czc13611858691/hozonEp40/doc/客户反馈诊断问题2022-1-19/readme.md

微信图片_20220119090819

NAX 0x50

主节点诊断

**未请求的服务，也会自动响应其他服务**



部分服务中少加了break

F19D	2

F1BF	2

F1C0	2 	BREAK

F1D0	3

default  BREAK

**流控制帧响应格式不对**







0x3C:	50	03	22	F1	9D	00	00	00

0x3D:	50	10	06	62	F1	9D	20	21

0x3D:	50	21	12	26	00	00	00	00

**pos**

62	F1	9D	20	21	12

**实际上我们想返回的数据**

10	PCI FF 首帧

06	数据长度为6

62	RSID	SID+0x40=0x22+0x40=0x62

21	PCI CF 续帧 计数值为1

F19D	数据标识符



返回的数据为:

20 21 12 26   //2021年12月26日
