czc13611858691/hozonEp40/doc/E3软件测试.md

#### 1.功能测试

##### 1.1.通用测试

- 窗提升点动，长按功能，区分时间300ms
- 快速滑动功能，滑动后长按功能
- 背光调节功能，白天高亮度，夜晚低亮度，同时夜晚背光亮度受背光等级调节
- 触摸开关任意按键发送按键声音信息
- 自动挡位信号的发送在之前移植时手动挡

##### 1.2.特定功能测试

###### 1.2.1.主驾DFGLS

- REAR按键切换功能
- 玻璃锁止功能

###### 1.2.2.左后DRGLS

- 自定义按键

###### 1.2.3.右前PFGLS

- 自定义按键

###### 1.2.4.右后PRGLS

- 自定义按键

#### 2.LIN通信测试

- 和CANOE主节点正常通信，同时不报错误
- 波特率正确
- 设备识别的同步间隔长度为13Tbit-26Tbit
- 设备识别的界定符长度为1Tbit-14Tbit
- 帧头长度识别范围为34Tbit-47Tbit
- 从节点PID奇偶校验错误测试
- 从节点不完整帧干扰测试
- checksum错误监测
- 数据场故障监测，干扰数据场
- 从节点接收睡眠命令帧
- 总线空闲4s进入睡眠模式
- 从节点可以正常唤醒

#### 3.LIN诊断测试

**canoe上位机可以读取设备所有信息**

- 配置nad,canoe可以读取所有did功能
- **1** boot版本    F180    03.01.01  -->  30 33 2e 30 31 2e 30 31      8Byte
- 当前诊断任务模式      F186  --> 01      1Byte
- 整车零部件号     F187   -->                  13Byte
- **2** 应用软件版本号(升级版本)  F188   03.01.01  -->  30 33 2e 30 31 2e 30 31      8Byte
- 应用软件版本号(固定版本）F1B0    03.01.01  -->  30 33 2e 30 31 2e 30 31      8Byte
- ECU标定软件号     F1A2      03.01.01  -->  30 33 2e 30 31 2e 30 31      8Byte
- 系统供应商代码   F18A   -->              3Byte
- ECU生产日期   F18B  2021年12月26日 -->    20 21 12 26   4Byte
- 控制器序列号   F18C   -->                    18Byte
- **3** 整车   VINF190        -->                    17Byte
- **4** 硬件版本号   F191  H1.01-->  48 31 2E 30 31                5Byte
- 测试串口序列   F198  -->                                     10Byte
- 刷新日期    F199  2021年12月26日 -->    20 21 12 26   4Byte
- ECU专配日期   F19D  2021年12月26日 -->    20 21 12 26   4Byte
- 硬件版本    F1BF    H1.01-->  48 31 2E 30 31                5Byte
- 软件总成    F1C0    03.01.01  -->  30 33 2e 30 31 2e 30 31      8Byte
- 软件总成零件号   F1D0  -->          13Byte

规定数据以外填充0x00

小于规定长度填充0x20

#### 4.LIN刷写测试

**canoe上位机可以对设备进行上位机升级**

boot 0-0x4800   18K

app 0-end

- 设备可以成功刷写
- 刷写后重新上电，测试设备是否改变
- 刷写后所有功能都可以正常运行

0x3c

诊断默认服务切换 PCI:SF sid:0x10 DATA:1   返回帧长度:1

读取bootloader版本号  PCI:SF sid:0x22 DATA:F180   返回帧长度:2

读取app软件版本号  PCI:SF sid:0x22 DATA:F188   返回帧长度:2

读取VIN  PCI:SF sid:0x22 DATA:F190   返回帧长度:4

读取ecu硬件版本号   PCI:SF sid:0x22 DATA:F191   返回帧长度:2

诊断扩展服务切换 PCI:SF sid:0x10 DATA:3   返回帧长度:1

执行检查程序安全状态 PCI:SF sid:0x31 DATA:31 01 02 03   返回帧长度:1

获取安全状态检查结果 PCI:SF sid:0x31 DATA:31 03 02 03   返回帧长度:1

设置DTC功能关闭 PCI:SF sid:0x85 DATA:02   返回帧长度:1

设置DTC功能关闭 PCI:SF sid:0x28 DATA:03 03   返回帧长度:1

进入编程会话  PCI:SF sid:0x10 DATA:2   返回帧长度:1

***canoe工程***

**read version message**

诊断默认服务切换-->读取bootloader版本号-->读取app软件版本号-->读取VIN-->读取ecu硬件版本号

**check environment**

诊断扩展服务切换-->执行检查程序安全状态-->获取安全状态检查结果

**enter programming mode**

进入编程会话

**get seed information**

50 02 27 11 ff ff ff ff

3d

**send password**

50 06 27 12 04 03 02 01

3d

**write version message**

3d

**load**

**erase flash**

50 10 0c 31 01 ff 00 ff

50 21 ff ff ff ff ff ff

50 22 ff ff ff ff ff ff

3d

 **download request**

50 10 0b 34 00 40 00 00

50 21 48 00 00 00 00 00

3d

**transfer data**

50 10 02 36 00 00 00 00

3d 

 **quit download**

50 01 37 ff ff ff ff ff

3d

 **check program crc16**

50 10 0e 31 01 ff 01 00

50 21 00 48 00 00 00 00

50 22 00 ff ff ff ff ff

3d

**refresh**

50 04 31 03 ff 01 ff ff

3d

**reset ecu**

50 02 11 01 ff ff ff ff
