czc13611858691/hozonEp40/doc/测试报告资源/标签.pdf

| 版本信息（标签模板，不支持信息可不填写）
项目 | HOZON_EP40 | 测试模块 | 窗提升
测试阶段 | E3 | 测试日期 | 2021/1/20
供应商名称 | 毅赫 | 软件版本/F1C0 | 03.00.01
硬件版本/F191 | H2.01 | Boot版本/F180
通信矩阵版本 | EP40_DDCU_LIN1_Matrix_V2.1_Release0910 EP40_PDCU_LIN1_Matrix_V2.1_Release0910 | 诊断协议版本
