czc13611858691/hozonEp40/doc/客户反馈诊断问题2022-1-19/readme.assets/image-20220119094246104.png

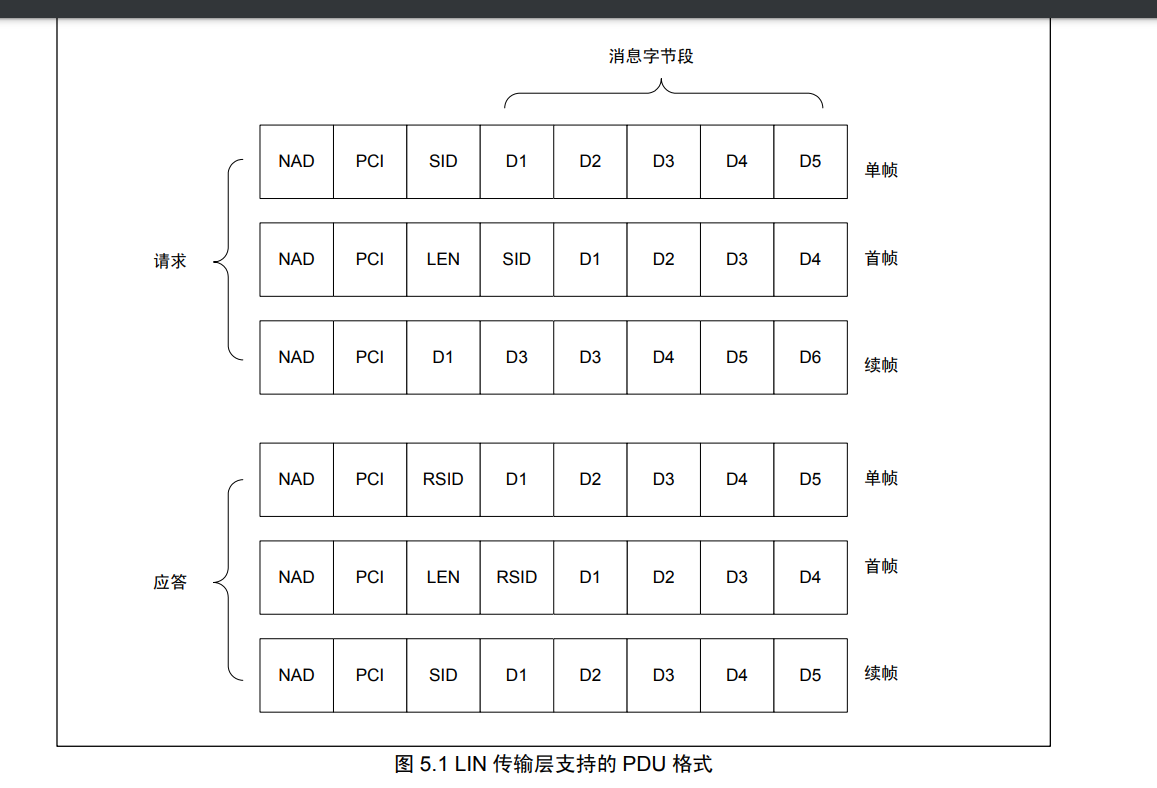
doc/客户反馈诊断问题2022-1-19/readme.assets/image-20220119094246104.png
