czc13611858691/hozonEp40/doc/客户反馈诊断问题2022-1-19/readme.assets/微信图片_20220119090819.png

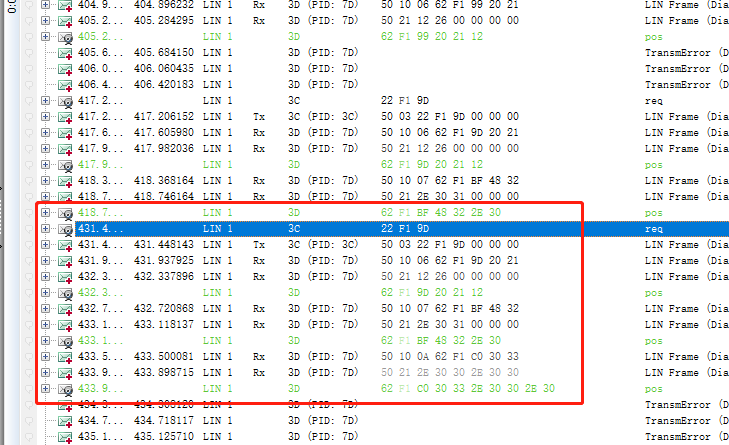
doc/客户反馈诊断问题2022-1-19/readme.assets/微信图片_20220119090819.png
