czc13611858691/hozonEp40/doc/EP40-DFGLS-LIN诊断调查表V1.2_2022.02.17.xlsx

Sheet: 1.0 Cover
 |  |  |  | Vehicle Diagnostic Engineer
 |  |  |  | Name | Email | Phone
ECU Information |  |  |  | Supplier Diagnostic Engineer
ECU Name | Diagnostic mode | Programming mode | Supplier | Name | Email | Phone
DFGLS | UDS on LIN | Programming on UDS | iNMECH | 祝聪 | zhucong@inmech.onaliyun.com

Sheet: 1.1一般信息
Part 1 - 一般信息
序号 | 调查 | 示例 | 供应商调查 | 备注
1 | 诊断使用何类物理层？[串行K线、LIN线、CAN总线、其它] | LIN总线 | LIN总线
2 | 你们是否可以使用UDS诊断协议？ | 是 | 是
3 | 诊断开始的条件是什么？ | Ignition On | Ignition On
4 | 诊断电压范围是多少？ | 9V~16V | 9V~16V
5 | 电控单元是否支持通过诊断服务“通讯控制服务($28)”，进入或退出“安静模式”？ | 支持 | 支持
6 | ECU是否支持功能寻址？ | 支持 | 支持
7 | ECU是否需要在下线站点或售后维修点进行软件刷写？ | 需要 | 需要
8 | ECU刷新是否有次数限制？ | 没有限制 | 没有限制
9 | ECU是否需要开发OTA？如果需要开发OTA，请按照合众的OTA调查表填写 | 是，填写文件详见附件“XXX项目FOTA开发刷写调查表” | 否

Sheet: 1.3 discussList
Item 序号 | sheet 分页 | Changes Comments修改说明 Issue Descriptions检讨项 |  |  | Issued by 提出方 | Issued by 提出者 | Date Issued 提出时间 | Feedback 反馈 | Status 状态 | Responded by 担当 | Due date 回复时限 | Date closed 关闭日期
 |  | 讨论项 | 修订方法 | 修订原因（可选）
1 | 1.0 Cover | 将该页填写完整 |  |  | 合众 | / | 2021.10.25
2 | 2. Services | 更改了28服务的支持情况，28服务可以只响应，不做功能 |  |  | 合众 | 王忠州 | 2021.11.03
3 | 3.5 Routine DID | 为保持和企标一致，更新了例程FF00的定义 |  |  | 合众 | 王忠州 | 2021.11.12
4 | 2. Services | 11服务需安全访问权限全部更改为N，28服务子功能01支持情况由N更改为Y |  |  | 合众 | 王忠州 | 2022.02.17

Sheet: 1.4. TimingParameters
Diagnostic Questionnaire 2 - Timing Parameter CAN 定时参数
ECU | Symbol 符号 | Min 最小值 | Max/Timeout 最大值/超时时间 | Unit 单位
DDCU | P2Server | 0 | 50 | ms
 | P2*Server | 0 | 5000 | ms
 | S3Server | —— | 5000 | ms
Tester 诊断仪 | S3Client | —— | 推荐值：2000 超时值：5000 | ms
Network Layer Timing Parameters CAN网络层定时器参数
ECU | Symbol 符号 | Timeout 超时时间 | Performance Requirement 性能要求 | Unit 单位
DDCU | N_As/N_Ar | 30 | —— | ms
 | N_Bs | 90 | —— | ms
 | N_Br | —— | (N_Br+N_Ar)<0.9*N_Bs | ms
 | N_Cs | —— | (N_Cs+N_As)<0.9*N_Cr | ms
 | N_Cr | 150 | —— | ms
CAN上诊断信息
ECU | Symbol 符号 | Parameter 参数 | Value 值 | Unit 单位
DDCU | BS | Block Size | 0 | ——
 | N_WFTmax | Maximum number of FC.WAIT frame transmissions | 0 | ——
 | STmin | Minimum Separation Time | 10（APP）/ 0（Boot） | ms
 | Request CAN-ID | 主机厂填写 0x76A
 | Response CAN-ID | 主机厂填写 0x77A
 | Functional Request CAN-ID | 主机厂填写 0x7DF
LIN诊断信息
ECU | Symbol 符号 | Parameter 参数 | Value 值 | Unit 单位
DFGLS | Request /Response ID | 0x3C/0x3D
 | Request /Response Frist-DATA（NAD） | 主机厂填写 0x50
 | Functional Request Frist-DATA | 主机厂填写 0x7E
Diagnostic Questionnaire 2 - Timing Parameter 诊断调查问卷2 - 定时参数
 | Symbol 符号 | Min 最小值 | Max/Timeout 最大值/超时时间 | Unit 单位
 | S3Server | —— | 5000 | ms
Tester 诊断仪 | S3Client | —— | 推荐值：2000 超时值：5000 | ms
Other parameters 其它参数
 | Symbol 符号 | Parameter 参数 | Value 值 | Unit 单位
RSCU | Request /Response ID | 0x3C/0x3D
 | Request /Response Frist-DATA（NAD） | 主机厂填写 0x11
 | Functional Request Frist-DATA | 主机厂填写 0x7E
Remarks:"tbd" indicates that it is to be defined. 备注："tbd" 表示待定。

Sheet: 2. Services
Diagnostic Questionnaire 2-Diagnostic Services 诊断调查问卷2 - 诊断服务
Service ID 服务标识符 | Diagnostic Services Name 诊断服务名称 | Sub-functions 子功能 | 是否支持 | Diagnostic Session 诊断模式 |  |  | Comm Types 通信类型 |  | Security Level 安全级别 |  |  | SuppressPosMsgindication 支持禁止肯定响应回复 | Comments 说明
 |  |  |  | 0x01 | 0x02 | 0x03 | Phy | Func | Level 1 | Level 2 | Level FBL
0x10 | DiagnosticSessionControl 诊断模式控制 | 0x01 DefaultSession 0x01 默认模式 | Y | Y | Y | Y | Y | Y | N | N | N | Y
 |  | 0x02 ProgrammingSession 0x02 编程会话模式 | Y | N | Y | Y | Y | N | N | N | N | Y | 编程会话模式只在bootloader中支持
 |  | 0x03 ExtendedDiagnosticSession 0x03 扩展诊断模式 | Y | Y | N | Y | Y | Y | N | N | N | Y
0x11 | EcuReset 电控单元复位 | 0x01 hardReset 0x01 硬复位 | Y | N | Y | Y | Y | N | N | N | N | Y
0x27 | SecurityAccess 安全访问 | 0x03 SecurityLevel1 0x03 安全访问级别1 | Y | N | N | Y | Y | N | N | N | N | N
 |  | 0x05 SecurityLevel2 0x05 安全访问级别2 | N | N | N | N | N | N | N | N | N | N
 |  | 0x11 SecurityLevelFBL 0x11 安全访问级别FBL | Y | N | Y | N | Y | N | N | N | N | N
0x28 | CommunicationControl 通信控制 | 0x00 EnableRxAndTx 0x00 使能收发 | Y | N | N | Y | Y | Y | N | N | N | Y | CommunicationType(通信类型) 0x01:normalCommunicationMessages 0x01:正常通信报文 0x02:networkManagementCommunicationMessages 0x02:(网络管理报文) 0x03:networkManagementCommunicationMessages and normalCommunicationMessages 0x03:(正常通信报文和网络管理报文)
 |  | 0x01 EnableRxAndDisableTx 0x01 使能收禁止发 | Y | N | N | Y | Y | Y | N | N | N | Y
 |  | 0x02 DisableRxAndEnableTx 0x02 禁止收使能发 | N | N | N | N | N | N | N | N | N | N
 |  | 0x03 DisableRxAndTx 0x03 禁止收发 | Y | N | N | Y | Y | Y | N | N | N | Y
0x3E | TesterPresent 诊断设备在线 | 0x00 ZeroSubFunction 0x00 Zero子功能 | Y | Y | Y | Y | Y | Y | N | N | N | Y
0x22 | ReadDataByIdentifier 读取数据（通过标识） | N/A | Y | Y | Y | Y | Y | Y | N | N | N | N
0x2E | WriteDataByIdentifier 写入数据（通过标识） | N/A | Y | N | Y | Y | Y | N | Y | N | Y | N
0x2F | InputOutput Control I/O控制 | 0x00 Return Control To ECU 0x00 返回ECU控制 | N | N | N | N | N | N | N | N | N | N
 |  | 0x01 Reset To Defort 0x01 重置到默认值 | N | N | N | N | N | N | N | N | N | N
 |  | 0x02 Freeze Current Statet 0x02 冻结当前状态 | N | N | N | N | N | N | N | N | N | N
 |  | 0x03 Short Term Adjustment 0x03 短时调整 | N | N | N | N | N | N | N | N | N | N
0x14 | ClearDiagnosticInformation 清除诊断信息 | N/A | Y | Y | N | Y | Y | Y | N | N | N | N
0x19 | ReadDTCInformation 读取DTC信息 | 0x01 ReportNumberOfDTCByStatusMask 0x01 通过状态码报告DTC的数 | N | Y | N | Y | Y | N | N | N | N | N
 |  | 0x02 ReportDTCByStatusMask 0x02 通过状态码报告DTC | N | Y | N | Y | Y | N | N | N | N | N
 |  | 0x03 reportDTCSnapshotIdentification | N | Y | N | Y | Y | N | N | N | N | N
 |  | 0x04 reportDTCSnapshotRecordByDTCNumber | N | Y | N | Y | Y | N | N | N | N
 |  | 0x0A ReportSupportedDTC 0x0A 报告支持的DTC | N | Y | N | Y | Y | N | N | N | N | N
0x31 | RoutineControl 例程控制 | 0x01 StartRoutine 0x01 开始执行 | Y | N | Y | Y | Y | N | Y | N | Y | N
 |  | 0x02 StopRoutine 0x02 停止执行 | N | N | Y | Y | Y | N | Y | N | Y | N
 |  | 0x03 RequestRoutineResults 0x03 执行结果 | Y | N | Y | Y | Y | N | Y | N | Y | N
0x34 | Request for download 请求下载 | N/A | Y | N | Y | N | Y | N | N | N | Y | N
0x36 | Transfer data 传输数据 | N/A | Y | N | Y | N | Y | N | N | N | Y | N
0x37 | RequestTransferExit 请求传输退出 | N/A | Y | N | Y | N | Y | N | N | N | Y | N
0x85 | Control DTC Setting DTC控制 | 0x01 ON | Y | N | N | Y | Y | Y | N | N | N | Y
 |  | 0x02 OFF | Y | N | N | Y | Y | Y | N | N | N | Y
注： DID为Data Identification; StoreData DID 通常为ECU内部存储的非易失的标识信息，如ECU硬件版本、序号等，这些参数可被读取或写入； DynamicData DID通常为ECU监测到的动态变化参数，如车速、某传感器的采集值等； Routine DID用于$31服务的参数； 填写特别注意： 1，支持为Y；不支持为N； 2，如果无需求，请写无，勿放空。例如，如I/O DID无需求，在该页写上无需求。

Sheet: 3.1 DTCStatus
Diagnostic Questionnaire 3-1 - DTC Status 诊断调查问卷3-1 - DTC状态
Bit Field 位场 | Bit Description 描述 | Bit State Definition 位状态定义 | Supported by ECU1 ECU支持1 | Remarks 备注
0 | Test failed 测试失效 | 0=False 1=True |  | 用来指示当前故障诊断结果
1 | Test failed this operation cycle 本运行周期测试失效 | 0=False 1=True
2 | Pending DTC 等待DTC | 0=False 1=True
3 | Confirmed DTC 确认DTC | 0=False 1=True |  | DTC被确认。只要故障被确认，此值会被置1，即Bit0==0 && Bit3==1代表历史故障
4 | Test not completed since last clear 上次清零后测试未完成 | 0=False 1=True
5 | Test failed since last clear 上次清零后测试失效 | 0=False 1=True
6 | Test not completed this operation cycle 本运行周期测试未完成 | 0=False 1=True
7 | Warning indicator requested 警告指示位请求 | 0=False 1=True
1 Please select if the DTC status is supported by ECU or not: "Yes" indicates that the DTC status is supported by ECU; "No" indicates that the DTC status is non-supported by ECU; "tbd" indicates that it is to be defined. 1 请选择ECU是否支持该DTC状态："Yes" 表示ECU支持该DTC状态；"No" 表示ECU不支持该DTC状态；"tbd" 表示是否支持待定。 Remarks: The meaning of every terms in this table is showed in the “Terms” worksheet. 注：表格中术语的含义在Terms工作表中给出。
NA

Sheet: 3.2 StoredData DID
Diagnostic Questionnaire 3-2 - StoredData DID List 诊断调查问卷3-2 - 静态存储DID列表
Num 序号 | DID Num DID号 | DID Description DID描述 | 是否支持 | 定义方 | Data Length (Bytes) | Data content 数据内容 | Data Type 数据类型 | Readable（$22） (Diagnostic Session ) |  |  |  | Writable（$2E） (Diagnostic Session ) |  |  |  | Comments / Information 备注
 |  |  |  |  |  |  |  | 0x01 | 0x02 | 0x03 | Security 安全等级 | 0x01 | 0x02 | 0x03 | Security 安全等级
1 | F180 | Boot SW Identifier Bootloader软件版本号 | Y | 供应商 | 8Byte | 编码规则示例： 30 31 2E 30 31 2E 30 31->"01.01.01" 表示Boot版本号为01.01.01 软件版本由主版本、子版本、修正版本及间隔符四部分共8个字节组成，前两个字节代表主版本、第三个字节代表间隔符，第四五个字节代表子版本，第六个字节代表间隔符，第七八字节代表修正版本。版本范围从00.01.00——99.99.99 | ASCII | Y | Y | Y | No | N | N | N
2 | F186 | ActiveDiagnosticSession 当前诊断任务模式 | Y | 供应商 | 1Byte | 0x01-默认会话模式 0x02-编程会话模式 0x03-扩展会话模式 | HEX | Y | Y | Y | No | N | N | N
3 | F187 | VehicleManufacturerSparePartNumber 整车零部件号 | Y | 合众 | 13Byte | 由合众提供，整车零部件号同EBOM零件号 | ASCII | Y | N | Y | No | N | N | N
4 | F188 | Vehicle Manufacturer ECU Software Number Data Identifier 应用软件版本号（正常升级版本） | Y | 合众 | 8Byte | 编码规则示例： 30 31 2E 30 32 2E 30 33 ->"01.02.03" 软件版本由主版本、子版本、修正版本及间隔符四部分共8个字节组成，前两个字节代表主版本、第三个字节代表间隔符，第四五个字节代表子版本，第六个字节代表间隔符，第七八字节代表修正版本。版本范围从00.01.00——99.99.99 | ASCII | Y | N | Y | No | N | N | N
5 | F1B0 | Vehicle Manufacturer ECU Software Number Data Identifier 应用软件版本号（固定版本） | Y | 合众 | 8Byte | 编码规则示例： 30 31 2E 30 32 2E 30 33 ->"01.02.03" 软件版本由主版本、子版本、修正版本及间隔符四部分共8个字节组成，前两个字节代表主版本、第三个字节代表间隔符，第四五个字节代表子版本，第六个字节代表间隔符，第七八字节代表修正版本。版本范围从00.01.00——99.99.99 | ASCII | Y | N | Y | No | N | N | N
6 | F1A2 | ECU标定软件号 | N | 供应商 | 8Byte | 30 31 2E 30 31 2E 30 31->"01.01.01" 表示 标定 版本号为 01.01.01 软件版本由主版本、子版本、修正版本及间隔符四部分共8个字节组成，前两个字节代表主版本、第三个字节代表间隔符，第四五个字节代表子版本，第六个字节代表间隔符，第七八字节代表修正版本。版本范围从00.01.00——99.99.99 | ASCII | Y | N | Y | No | N | N | N
7 | F18A | systemSupplierIdentifierDataIdentifier 系统供应商代码 | Y | 合众 | 3Byte | 采购定义系统供应商代码，该值由合众提供。 | ASCII | Y | N | Y | No | N | N | N
8 | F18B | ECU Manufacture Date ECU生产日期 | Y | 供应商 | 4Byte | 编码规则示例： 20 18 06 01->表示2018年6月1日生产 前两个字节代表年，第三个字节代表月，第四个字节代表日。 | BCD | Y | N | Y | No | N | N | N
9 | F18C | ECUSerialNumberDataIdentifier 控制器序列号 | Y | 供应商 | 18Byte | 示例：P EP30 10BA AA31 A 0001 第1字节：表示设备所在域。BDCS所在域为“B”，BMS所在的域为“P”，EPS所在的域为“C”，HUD所在的域为“I”； 第2~5字节：表示合众车型项目代码。如“EP30”。 第6~ 9字节：表示合众零件号码。采用合众内部零件号后4字节。 第 10字节：表示“年”。如：A 表示2021 年，依次类推。 第 11 字节：表示“月”分别用“1，2，3，4，5，6，7，8，9，A，B，C”表示12个月份。 第 12~13字节：表示“日”。必须用2字节数表示日，如是1－9 号则必须用 01－09表示。 第 14字节：表示零部件当天的生产班次，班次定义为：A-B-C-D-E-F-G-H； (I、O不允许使用) 第 15~18字节：表示零部件当天的生产流水号，流水号从0001开始。 | ASCII | Y | N | Y | No | N | N | N
10 | F190 | VINDataIdentifier 整车VIN | Y | 合众 | 17Byte | 编码规则示例： 十六进制： 4C 56 56 44 43 31 31 42 36 41 44 35 32 34 32 38 36 ACSII： LVVDC11B6AD324286 | ASCII | Y | N | Y | No | N | N | Y | Level1
11 | F191 | Vehicle Manufacturer ECU Hardware Number Data Identifier 硬件版本号 | Y | 合众 | 5Byte | 编码规则示例： 48 31 2E 30 31->"H1.01" 表示硬件版本号为H1.01， 硬件版本由字母、数字及间隔符共5个字节组成，其中H代表硬件（第一个字节），第二个字节代表大版本，代表产品硬件方案，从1开始。第三个字节代表间隔符，第四个字节代表中版本，代表PCB的版本，从1开始。第5个字节代表小版本，代表PCBA版本，从0开始。 | ASCII | Y | Y | Y | No | N | N | N
12 | F198 | TesterSerialNumberDataIdentifier | Y | 合众 | 10Byte | 每个字节从有效值范围0x20,0x2E,0x30-0x39, 0x41-0x5A,0x61-0x7A中选取任一字节，当序列号小于10字节时，低字节用以0x20（空格）填充 | ASCII | Y | Y | Y | No | N | Y | N | Leve FBL
13 | F199 | ProgrammingDataDataIdentifier 刷新日期 | Y | 合众 | 4Byte | 编码规则示例： 20 18 06 01->表示2018年6月1日刷新 前两个字节代表年，第三个字节代表月，第四个字节代表日。 | BCD | Y | Y | Y | No | N | Y | N | Leve FBL
15 | F1A8 | VehicleFeatureCode 整车配置码 | N | 供应商 | 10Byte |  |  | N | N | N |  | N | N | N
13 |  | BMSManufactureCode 电池管理系统生产编号 | N | 供应商
14 | F19D | ECUInstallationDateDataIdentifier ECU装配日期 | Y | 合众 | 4Byte | 编码规则示例： 20 18 06 01->表示2018年6月1日装配 前两个字节代表年，第三个字节代表月，第四个字节代表日。 | BCD | Y | N | Y | No | N | N | Y | Leve1
15 | F1BF | Vehicle Manufacturer ECU Hardware Number Data Identifier 硬件件版本号（固定版本） | Y | 合众 | 5Byte | 编码规则示例： 48 31 2E 30 31->"H1.01" 表示硬件版本号为H1.01， 硬件版本由字母、数字及间隔符共5个字节组成，其中H代表硬件（第一个字节），第二个字节代表大版本，代表产品硬件方案，从1开始。第三个字节代表间隔符，第四个字节代表中版本，代表PCB的版本，从1开始。第5个字节代表小版本，代表PCBA版本，从0开始。 | ASCII | Y | Y | Y | No | N | N | N
16 | F1C0 | Vehicle Manufacturer ECU Software Assembly Number Data Identifier 软件总成版本 | Y | 合众 | 8Byte | 编码规则示例： 30 31 2E 30 32 2E 30 33 ->"01.02.03" 软件版本由主版本、子版本、修正版本及间隔符四部分共8个字节组成，前两个字节代表主版本、第三个字节代表间隔符，第四五个字节代表子版本，第六个字节代表间隔符，第七八字节代表修正版本。版本范围从00.01.00——99.99.99 | ASCII | Y | N | Y | No | N | N | N
17 | F1D0 | Vehicle manufacturer ECU software Assembly part number data identifier 软件总成零件号 | Y | 合众 | 13Byte | 软件总成零件号由责任工程师定义，该值由合众提供。 | ASCII | Y | N | Y | No | N | N | N
注：a)规定数据长度以外的数据填充为0x00
b)如果ECU反馈的数据长度比规定的数据长度小，其余低字节填充0x20
NA

Sheet: 3.3 IO Control DID
Diagnostic Specification 4_2 - I/O DID List
诊断规范4_2 - 输入/输出DID列表
Module I/O control test via InputOutputControlByIdentifier [$2F] 节点通过$2F服务执行输入输出控制测试 |  |  | SecurityAccess[27] Required 需要$27安全访问
NOTE 1: | This section is reserved for Input output control commands ONLY. 此部分只包含输入输出控制命令DID
DID Number DID号 | Command Description 命令描述 |  | InputOutputControlParameter 输入输出控制参数 | ControlState in request message 请求报文中的控制状态 |  |  |  |  |  |  |  |  |  |  |  |  |  | ControlEnableMaskRecord 控制掩码 | ControlStateRecord in positive response message 肯定响应报文中的控制状态记录 | Security Leve 安全等级 | Application Software1 (Diagnostic Session ) 应用程序诊断模式1 |  | Boot Sofeware1 (Diagnostic Session ) 引导程序诊断模式1 |  |  | Message Example 报文示例 | Remarks 备注
 | DID Description | DID 中文描述 |  | Param 参数名 | 参数中文描述 | ByteLength 字节长度 | Byte Position 字节位置 | Bit Position Bit 位置 | Sub Data Name 子数据名称 | 子参数中文描述 | Default Value (Phy.) 默认值 | Range, Min (Phy.) 物理值最小值 | Range, Max (Phy.) 物理值最大值 | Unit 单位 | Conversion 换算 | Data Type 数据类型 | Comments / Information 描述信息 |  |  |  | 0x01 | 0x03 | 0x01 | 0x02 | 0x03
0x0010(Demo) | Door Lock/Unlock Control | 门锁控制 | 0x03 | Door Lock Control | 门锁控制 | 1 | 0 | 7 | Reserved | 预留 | 0x00 | / | / | / | / | / | not used | 0x00-0xFF | 与请求报文中的控制状态定义相同 | Level1 | No | Yes | No | No | Yes | 请求：2F 00 10 03 01 01 响应：6F 00 10 03 01 | N/A表示没有该参数
 |  |  |  |  |  |  |  | 6 | Reserved | 预留 | 0x00 | / | / | / | / | / | not used
 |  |  |  |  |  |  |  | 5 | Reserved | 预留 | 0x00 | / | / | / | / | / | not used
 |  |  |  |  |  |  |  | 4 | Reserved | 预留 | 0x00 | / | / | / | / | / | not used
 |  |  |  |  |  |  |  | 3 | Reserved | 预留 | 0x00 | / | / | / | / | / | not used
 |  |  |  |  |  |  |  | 2 | Reserved | 预留 | 0x00 | / | / | / | / | / | not used
 |  |  |  |  |  |  |  | 1 | Passener's Door | 副驾侧门 | Unlock | / | / | / | 0x0: Unlock 0x1:Lock | Table
 |  |  |  |  |  |  |  | 0 | Driver's Door | 主驾侧门 | Unlock | / | / | / | 0x0: Unlock 0x1:Lock | Table
 |  |  | 0x00 |  |  | N/A |  |  |  |  |  |  |  |  |  |  |  | N/A | 与输入输出控制参数为0x03时请求报文中的控制状态定义相同 | Level1 | No | Yes | No | No | Yes | 请求：2F 00 10 00 响应：6F 00 10 00 01
NA
1 Please select if the data is accessible by the service or not: "Y" indicates that the data is accessible by the service; "N" indicates that the data is not accessible by the service; "TBD" indicates that it is to be defined. 1 请选择服务能否访问该数据："Y"表示服务可以访问该数据；"N"表示服务不能访问该数据；"TBD"表示待定。 2 please fill the precondition requirement of the action in the implementation rule column. 2 请在执行规则栏中填写动作的前提条件。 Remarks: The meaning of terms in this table is showed in the "Terms" worksheet. 注：表格中术语的含义在Terms工作表中给出。

Sheet: 3.4 Routine DID
Diagnostic Specification - RoutineControl DID List
诊断规范 - 例程控制DID列表
Module routine control test via RoutineControlByIdentifier [$31]: 节点通过$31服务执行例程控制测试：
NOTE 1: | This section is reserved for routine control commands ONLY. 此部分只包含例程控制命令DID
RoutineDID 例程DID | Routine Description DID描述 |  | RoutineControlType 例程控制类型 | Subfuction 子功能 | 参数选项 | Routine Param 例程参数 |  |  |  |  |  |  |  |  |  | Security Leve 安全等级 | Application Software2 (Diagnostic Session ) 应用程序诊断模式2 |  | Boot Software2 (Diagnostic Session ) 引导程序诊断模式2 |  |  | Limited Time for Routine 例程时间限制 | Remarks 备注 | Message Example 报文示例
 | DID Description | DID 中文描述 |  |  |  | Byte Length 字节长度 | Param 参数名 | Byte Position 字节位置 | Bit Position Bit 位置 | Default Value (Phy.) 默认值 | Range, Min (Phy.) 物理值最小值 | Range, Max (Phy.) 物理值最大值 | Unit 单位 | Conversion 换算 | Data Type 数据类型 |  | 0X01 | 0X03 | 0X01 | 0X02 | 0x03
FF01 | Check Programming Dependencies | 检查编程完整性 | 0x01 StartRoutine | Y | Request Routibe Control Option 请求：例程控制选项 | 10 | Erase Address | 0~3 | 31~0 | 0x00 | 0 | 0xFFFFFFFF | / | phy=XX*1 | Unsigned | LevelFBL | N | N | N | Y | N
 |  |  |  |  |  |  | Erase Size | 4~7 | 31~0 | 0x00 | 0 | 0xFFFFFFFF | / | phy=XX*1 | Unsigned
 |  |  |  |  |  |  | checksum | 8~9 | 15~0 | 0x00 | 0 | 0xFFFF | / | phy=XX*1 | Unsigned
 |  |  |  | Y | Response Routine Status 回复：例程控制状态 | 3 | RoutineStatusRecord | 0 | 7~0 | / | / | / | / | 0x02 successful 0x05 failed | Table
 |  |  |  |  |  |  | checksum | 1~2 | 15~0 | 0x00 | 0 | 0xFFFF | / | phy=XX*1 | Unsigned
 |  |  | 0x02 StopRoutine | N | Request Routibe Control Option 请求：例程控制选项 | N/A | N/A | N/A | N/A | N/A | N/A | N/A | N/A | N/A | N/A
 |  |  |  | N | Response Routine Status 回复：例程控制状态 | N/A | N/A | N/A | N/A | N/A | N/A | N/A | N/A | N/A | N/A
 |  |  | 0x03 RequestRoutineResults | N | Request Routibe Control Option 请求：例程控制选项 | N/A | N/A | N/A | N/A | N/A | N/A | N/A | N/A | N/A | N/A
 |  |  |  | N | Response Routine Status 回复：例程控制状态 | N/A | N/A | N/A | N/A | N/A | N/A | N/A | N/A | N/A | N/A
0XFF00 | EraseMemory | 擦除内存 | 0x01 StartRoutine | Y | Request Routibe Control Option 请求：例程控制选项 | 8 | Erase Address | 0~3 | 31~0 | 0x00 | 0 | 0xFFFFFFFF | / | phy=XX*1 | Unsigned | LevelFBL | N | N | N | Y | N |  | 如果不支持Bootloader功能，请删除这个例程DID
 |  |  |  |  |  |  | Erase Size | 4~7 | 31~0 | 0x00 | 0 | 0xFFFFFFFF | / | phy=XX*1 | Unsigned
 |  |  |  | Y | Response Routine Status 回复：例程控制状态 | 1 | RoutineStatusRecord | 0 | 7~0 | / | / | / | / | 0x02 successful 0x05 failed | Table
 |  |  | 0x02 StopRoutine | N | Request Routibe Control Option 请求：例程控制选项 | N/A | N/A | N/A | N/A | N/A | N/A | N/A | N/A | N/A | N/A
 |  |  |  | N | Response Routine Status 回复：例程控制状态 | N/A | N/A | N/A | N/A | N/A | N/A | N/A | N/A | N/A | N/A
 |  |  | 0x03 RequestRoutineResults | N | Request Routibe Control Option 请求：例程控制选项 | N/A | N/A | N/A | N/A | N/A | N/A | N/A | N/A | N/A | N/A
 |  |  |  | N | Response Routine Status 回复：例程控制状态 | N/A | N/A | N/A | N/A | N/A | N/A | N/A | N/A | N/A | N/A
0x0203 | Check Programming Preconditions | 检查编程预条件 | 0x01 StartRoutine | Y | Request Routibe Control Option 请求：例程控制选项 | N/A | N/A | N/A | N/A | N/A | N/A | N/A | N/A | N/A | N/A | N | N | Y | N | N | Y |  |  | 预编程检查成功： 请求：31 01 02 03 响应：71 01 02 03 02 ：condition(successful) 预编程检查不成功： 请求：31 01 02 03 响应：71 01 02 03 05
 |  |  |  | Y | Response Routine Status 回复：例程控制状态 | 1 | RoutineStatusRecord | 0 | 7~0 | 0 | 0 | 255 | / | 0x02 successful 0x05 failed | Table
 |  |  | 0x02 StopRoutine | N | Request Routibe Control Option 请求：例程控制选项 | N/A | N/A | N/A | N/A | N/A | N/A | N/A | N/A | N/A | N/A
 |  |  |  | N | Response Routine Status 回复：例程控制状态 | N/A | N/A | N/A | N/A | N/A | N/A | N/A | N/A | N/A | N/A
 |  |  | 0x03 RequestRoutineResults | N | Request Routibe Control Option 请求：例程控制选项 | N/A | N/A | N/A | N/A | N/A | N/A | N/A | N/A | N/A | N/A
 |  |  |  | N | Response Routine Status 回复：例程控制状态 | N/A | N/A | N/A | N/A | N/A | N/A | N/A | N/A | N/A | N/A
NA
1 "-" indicates that there is no specific requirements about "RoutineControlOption" and "RoutineStatus" in this routine DID. 1 "-" 表示该例程DID中没有特殊的“例程控制选项”或“例程状态”。 2 Please select if the data is accessible by the service or not: "Y" indicates that the data is accessible by the service; "N" indicates that the data is not accessible by the service; "TBD" indicates that it is to be defined. 2 请选择服务能否访问该数据："Y"表示服务可以访问该数据；"N"表示服务不能访问该数据；"TBD"表示待定。 3 please fill the precondition requirement of the action in the implementation rule column. 3 请在执行规则栏中填写动作的前提条件。 Remarks: The meaning of terms in this table is showed in the "Terms" worksheet. 注：表格中术语的含义在Terms工作表中给出。

Sheet: 3.5 DTC List
Number 序号 | DTC Number DTC故障码（按照高中低3字节的格式反馈） | H&M Byte 高&中字节 | Faults Types1 低字节 | DTC描述 | Failure Category definition 故障类型 | 整车故障等级 | 故障灯 | 故障发生时发送的CAN\硬线信号 | 故障时，信号状态位及对应释义 | Detection Conditions 故障判断条件 （必须要有故障确认的时间和参数） | Recovery Conditions 恢复条件 （必须要有故障恢复的时间和参数） | Possible Fault Causes 引起故障可能的原因 | Corrective Action 维修建议 | Fault Protection Measure 故障保护措施 | 故障码清除方式 | Category | 优先级 | 严重等级 | Failure Mode 失效模式
Note 1: the value of this parameter should be filed according to ISO15031-6 注1: 依据ISO 15031填写该参数 Note2: The meaning of other terms in this table is showed in the "Terms" worksheet. 注2：表格中其它术语的含义在Terms工作表中给出。 注3：诊断故障代码严重等级说明。Level 1：立即检查；Level 2：下次停机检查；Level 3：保养时检查；Level 4：一般信息。 注4：诊断故障代码优先级说明。Priority 0代表最高的优先级；父故障的优先级要高于子故障的优先级。 所有的故障代码及其相关信息都应存储于非易失性存储器。受空间所限，ECU可存储的故障信息是有限。同时代码及其相关个数应不小于10个。当存储信息已满时，ECU需决定是忽略最新检测到的故障及其信息，还是删除已存储的信息以预留空间给最新检测到故障。 ECU供应商需定义故障信息存储的优先级机制，但必须保证部件及整车安全性。
示例 | 0x056216 | 0x0562 | 0x16 | Battery Voltage below threshold | Battery | 2 | 不点亮 | 无 | 无 | The BAT voltage value is detected as below 8.5V by ECU for 500 ms. | The BAT voltage value is detected as between 9V and 16V for 500 ms. | 电池电压过低 | 检查小电池电压 | 功能降级 | 通过14服务清除 DTC，或者DTC老化 | 电池 | Level $1 | 2
NA

Sheet: 4. Terms
Diagnostic Questionnaire 4 - Terms 诊断调查问卷4 - 术语
Property 属性 | Description 描述 | Remarks 注释
Diagnostic Services
诊断服务
Service ID (hex) 服务ID | Diagnostic services identifier 诊断服务标识符 | Based on ISO 14229 基于 ISO 14229
Diagnostic Services Name 诊断服务名称 | Name of diagnostic services 诊断服务名称 | Based on ISO 14229 基于 ISO 14229
Sub-Function 子功能 | Sub-functions of services 服务包含的子功能。 | Based on ISO 14229 基于 ISO 14229
Diagnostic Session 诊断会话模式 | Diagnostic session: defaultSession (0x01) programmingDiagnosticSession (0x02) extendedDiagnosticSession (0x03) 诊断会话模式： 默认会话模式（0x01） 程序设计诊断会话模式（0x02） 扩展诊断会话模式（0x03）
Comm Types 通信寻址方式 | Communication types: Physical Functional 寻址方式： 物理寻址 功能寻址
DID List
DID列表
DID Number DID数值 | The number of data Identifier 资料标识符的数值
DID Description 描述 | Description of DID 对于DID的描述
Length (Bytes) 字节数 | Length of the data which the DID stands for 该DID所代表数据的长度
Byte 字节 | The byte number of the data 数据所占的字节号 | Mapped start position of the signal by "Motorola forward LSB" format. It indicates the lsb (least significant bit) of LSB (least significant byte) from beginning of the message. (See the following figure). Bitwise to the left, bytewise to the up (from start position). 信号的起始映像位置按照 "Motorola forward LSB"格式。即报文的起始为LSB（最低有效字节）的lsb（最低有效位）。（如下图所示，从起始点开始，位方向从右向左，字节方向自下至上。
Bit 位 | The bit number of the data 数据在所占字节中的位号
Sub Data Name 子数据名称 | Name of sub data which is contained in a data 数据中包含的子数据的名称
Range, Min (Phy.) 最小值范围（物理值） | Minimum physical value of the data 数据的物理最小值 | The "physical value" of a data is the value of the physical quantity (e.g. speed, rpm, temperature, etc.) that represents the data. 数据的物理值即这个数据所代表的物理量（例如：速度、转速、温度等）。
Range, Max (Phy.) 最大值范围（物理值） | Maximum physical value of the data 数据的物理最大值
Unit 单位 | The unit of the physical data 数据物理值单位
Conversion 转换关系 | Conversion between physical data value and hexadecimal representation (e.g. formula, table,etc) 物理值和总线数值的换算（例如:公式、对照表等）
Data Type 数据类型 | The type of data used in program 程序设计中使用的数据的类型 | e.g. BCD, ASCII, Hex Dump, unsigned, Bool, Bit mapped etc. 例如: BCD, ASCII, Hex Dump, unsigned, Bool, Bit mapped等。
Storage Pos. 存储位置 | The position where a ECU store the data "FLASH", "EEPROM", "RAM" and "ROM" are defined ECU存储数据的位置 定义了“FLASH”，“EEPROM”，“RAM”和“ROM”
Limited Time (S) 限制时间（秒） | This parameter optionally defines the limited max time for special control. After the time, the control will automatically return to the ECU. 该参数用于定义某些特殊控制选项的最大运行时间。超过这个时间后，控制权将自动恢复给ECU。 | e.g. If the motor is controlled for too long, it will cause motor overheating and thus damage to motor. Therefore, a maximum time is defined. When this maximum time is achieved, the motor's control state will automatic return to normal state. 比如: 控制电机时间过长，会造成电机过热，从而损坏电机。因此，定义一个执行的最大时间，达到这个最大时间后，电机的控制状态自动恢复到正常状态。
RoutineControlType 例程控制类型 | 0x01: startRoutine 0x01: 开始执行 0x02: stopRoutine 0x02: 停止执行 0x03: requestRoutineResults 0x03: 执行结果
RoutineControlOption 例程控制选项 | This parameter is used in the request message of $31 service to describe the detailed control state of request. 该参数为$31服务请求报文中用于描述所请求的具体的控制状态。 | routine entry option parameters, which optionally specify start conditions of the routine (e.g. timeToRun, startUp- Variables, etc). 例程入口的参数选项，比如例程的指定开启条件（例如：运行的时间，开启时刻可变等）。
RoutineStatus 例程状态 | This parameter is used in the response message of $31 service to describe the detailed control results. 该参数为$31服务回应报文中用于描述所控制选项的执行结果。 | additional information about the status of the server following the start of the routine, etc. 例程开始后，服务器状态附加信息等
Limited Time for Routine (S) 限制时间（秒） | This parameter optionally defines the limited time for special routine. 该参数用于定义所控制例程的运行时间。
