czc13611858691/hozonEp40/doc/EP40_E3_DFGLS_功能测试报告_2021228.xlsx

Sheet: 封面
EP40项目
功能测试报告-触摸开关 （E3）
 | 编 制：
 | 审 核：
 | 批准：

Sheet: 内部环境
版本信息
项目 | EP40 | 测试模块 | 基本功能
测试阶段 | EP1 | 测试日期 | 2022-12-28
零部件号 | C40-3746010/020/030/040 | 软件版本/F188 | 暂未体现
硬件版本/F191 | 暂未体现 | Boot版本/F180 | 暂未体现
供应商名称 | 上海毅赫 | 测试申请人 | 邵伟
通信矩阵版本 | EP40_DDCU_LIN1_Matrix_V2.1_Release0910 EP40_PDCU_LIN1_Matrix_V2.1_Release0910 | 诊断协议版本 | 暂未体现

Sheet: 电路原路接口定义
一、测试工具
上位机、万用表
二、硬件接线
C40-3774010 玻璃升降主开关总成
C40-3774020/030/040 玻璃升降副开关总成/左后玻璃升降开关总成/右后玻璃升降开关总成

Sheet: 玻璃升降主开关总成功能测试
用例编号 | 零件号 | 零件名称 | 测试项目 | 前置条件 | 操作步骤 | 预期结果 | 阶段 | 车型 | 测试环境 | 测试结果 | 备注
1 | C40-3774010 | 玻璃升降主开关总成 | 点动-左前门玻璃自动上升功能 | 1、正常工作电压； 2、针脚接线正确； 3、DDCU报头能正常发送； | 点触玻璃升降主开关总成左前门上升按键； | 1、开关信号发出：DFGLS_FLWindowControl=0x3:Auto Up； 2、左前玻璃升降电机自动上升； | EP1 | EP40 | 单件/台架 | PASS
2 |  |  | 长按-左前门玻璃手动上升功能 |  | 长按玻璃升降主开关总成左前门上升按键； | 1、开关信号发出：DFGLS_FLWindowControl=0x1:Manual Up； 2、左前玻璃升降电机手动上升； | EP1 | EP40 | 单件/台架 | PASS
3 |  |  | 点动-左前门玻璃自动下降升功能 |  | 点触玻璃升降主开关总成左前门下降按键； | 1、开关信号发出：DFGLS_FLWindowControl=0x4:Auto Down； 2、左前玻璃升降电机自动下降； | EP1 | EP40 | 单件/台架 | PASS
4 |  |  | 长按-左前门玻璃手动动下降升功能 |  | 长按玻璃升降主开关总成左前门下降按键； | 1、开关信号发出：DFGLS_FLWindowControl=0x2:Manual Down； 2、左前玻璃升降电机手动下降； | EP1 | EP40 | 单件/台架 | PASS
5 |  |  | 点动-右前门玻璃自动上升功能 |  | 点触玻璃升降主开关总成右前门上升按键； | 1、开关信号发出：DFGLS_FRWindowControl=0x3:Auto Up； 2、右前玻璃升降电机自动上升； | EP1 | EP40 | 单件/台架 | PASS
6 |  |  | 长按-右前门玻璃手动上升功能 |  | 长按玻璃升降主开关总成右前门上升按键； | 1、开关信号发出：DFGLS_FRWindowControl=x1:Manual Up； 2、右前玻璃升降电机手动上升； | EP1 | EP40 | 单件/台架 | PASS
7 |  |  | 点动-右前门玻璃自动下降升功能 |  | 点触玻璃升降主开关总成右前门下降按键； | 1、开关信号发出：DFGLS_FRWindowControl=0x4:Auto Down； 2、右前玻璃升降电机自动下降； | EP1 | EP40 | 单件/台架 | PASS
8 |  |  | 长按-右前门玻璃手动下降升功能 |  | 长按玻璃升降主开关总成右前门下降按键； | 1、开关信号发出：DFGLS_FRWindowControl=0x2:Manual Down； 2、右前玻璃升降电机手动下降； | EP1 | EP40 | 单件/台架 | PASS
9 |  |  | REAR切换功能 |  | 点触玻璃升降主开关总成REAR按键 | 1、开关指示灯点亮； 2、1min后指示灯熄灭； | EP1 | EP40 | 单件/台架 | PASS
10 |  |  | 玻璃锁止功能 |  | 点触玻璃升降主开关总成玻璃锁止按键 | 1、开关信号发出：DFGLS_ControlWindowLockSw=0x1:Active； 2、DDCU信号发至开关：DDCU_ControlWindowLockSwInd=0x1:Active； 3、开关指示灯点亮； | EP1 | EP40 | 单件 | PASS | DDCU通过模拟信号发送
11 |  |  | 点动-左后门玻璃自动上升功能 |  | 1、点触REAR按键； 2、点触玻璃升降主开关总成左后门上升按键； | 1、开关信号发出：DFGLS_RLWindowControl=0x3:Auto Up； 2、左后玻璃升降电机自动上升； | EP1 | EP40 | 单件/台架 | PASS
12 |  |  | 长按-左后门玻璃手动上升功能 |  | 1、点触REAR按键； 2、长按玻璃升降主开关总成左后门上升按键； | 1、开关信号发出：DFGLS_RLWindowControl=0x1:Manual Up； 2、左后玻璃升降电机手动上升； | EP1 | EP40 | 单件/台架 | PASS
13 |  |  | 点动-左后门玻璃自动下降升功能 |  | 1、点触REAR按键； 2、点触玻璃升降主开关总成左后门下降按键； | 1、开关信号发出：DFGLS_RLWindowControl=0x4:Auto Down； 2、左后玻璃升降电机自动下降； | EP1 | EP40 | 单件/台架 | PASS
14 |  |  | 长按-左后门玻璃手动下降升功能 |  | 1、点触REAR按键； 2、长按玻璃升降主开关总成左后门下降按键； | 1、开关信号发出：DFGLS_RLWindowControl=0x2:Manual Down； 2、左后玻璃升降电机手动下降； | EP1 | EP40 | 单件/台架 | PASS
15 |  |  | 点动-右后门玻璃自动上升功能 |  | 1、点触REAR按键； 2、点触玻璃升降主开关总成右后门上升按键； | 1、开关信号发出：DFGLS_RRWindowControl=0x3:Auto Up； 2、右后玻璃升降电机自动上升； | EP1 | EP40 | 单件/台架 | PASS
16 |  |  | 长按-右后门玻璃手动上升功能 |  | 1、点触REAR按键； 2、长按玻璃升降主开关总成右后门上升按键； | 1、开关信号发出：DFGLS_RRWindowControl=0x1:Manual Up； 2、右后玻璃升降电机手动上升； | EP1 | EP40 | 单件/台架 | PASS
17 |  |  | 点动-右后门玻璃自动下降升功能 |  | 1、点触REAR按键； 2、点触玻璃升降主开关总成右后门下降按键； | 1、开关信号发出：DFGLS_RRWindowControl=0x4:Auto Down； 2、右后玻璃升降电机自动下降； | EP1 | EP40 | 单件/台架 | PASS
18 |  |  | 长按-右后门玻璃手动下降升功能 |  | 1、点触REAR按键； 2、长按玻璃升降主开关总成右后门下降按键； | 1、开关信号发出：DFGLS_RRWindowControl=0x2:Manual Down； 2、右后玻璃升降电机手动下降； | EP1 | EP40 | 单件/台架 | PASS
19 |  |  | 滑动-左前门玻璃自动上升功能 |  | 滑动向上且手指迅速离开玻璃升降主开关总成左侧按键表面； | 1、开关信号发出：DFGLS_FLWindowControl=0x3:Auto Up； 2、左前玻璃升降电机自动上升； | EP1 | EP40 | 单件/台架 | PASS
20 |  |  | 滑动后长按-左前门玻璃手动上升功能 |  | 滑动向上且手指保持在玻璃升降主开关总成左侧按键表面； | 1、开关信号发出：DFGLS_FLWindowControl=0x1:Manual Up； 2、左前玻璃升降电机手动上升； | EP1 | EP40 | 单件/台架 | PASS
21 |  |  | 滑动-左前门玻璃自动下降升功能 |  | 滑动向下手指迅速离开玻璃升降主开关总成左侧按键表面； | 1、开关信号发出：DFGLS_FLWindowControl=0x4:Auto Down； 2、左前玻璃升降电机自动下降； | EP1 | EP40 | 单件/台架 | PASS
22 |  |  | 滑动后长按-左前门玻璃手动下降升功能 |  | 滑动向下手指保持在玻璃升降主开关总成左侧按键表面； | 1、开关信号发出：DFGLS_FLWindowControl=0x2:Manual Down； 2、左前玻璃升降电机手动下降； | EP1 | EP40 | 单件/台架 | PASS
23 |  |  | 滑动-右前门玻璃自动上升功能 |  | 滑动向上且手指迅速离开玻璃升降主开关总成右侧按键表面； | 1、开关信号发出：DFGLS_FRWindowControl=0x3:Auto Up； 2、右前玻璃升降电机自动上升； | EP1 | EP40 | 单件/台架 | PASS
24 |  |  | 滑动后长按-右前门玻璃手动上升功能 |  | 滑动向上且手指保持在玻璃升降主开关总成右侧按键表面； | 1、开关信号发出：DFGLS_FRWindowControl=0x1:Manual Up； 2、右前玻璃升降电机手动上升； | EP1 | EP40 | 单件/台架 | PASS
25 |  |  | 滑动-右前门玻璃自动下降升功能 |  | 滑动向下且手指迅速离开玻璃升降主开关总成右侧按键表面； | 1、开关信号发出：DFGLS_FRWindowControl=0x4:Auto Down； 2、右前玻璃升降电机自动下降； | EP1 | EP40 | 单件/台架 | PASS
26 |  |  | 滑动后长按-右前门玻璃手动下降升功能 |  | 滑动向下且手指保持在玻璃升降主开关总成右侧按键表面； | 1、开关信号发出：DFGLS_FRWindowControl=0x2:Manual Down； 2、右前玻璃升降电机手动下降； | EP1 | EP40 | 单件/台架 | PASS
27 |  |  | 滑动-左后门玻璃自动上升功能 |  | 1、点触REAR按键； 2、滑动向上且手指迅速离开玻璃升降主开关总成左侧按键表面； | 1、开关信号发出：DFGLS_RLWindowControl=0x3:Auto Up； 2、左后玻璃升降电机自动上升； | EP1 | EP40 | 单件/台架 | PASS
28 |  |  | 滑动后长按-左后门玻璃手动上升功能 |  | 1、点触REAR按键； 2、滑动向上且手指保持在玻璃升降主开关总成左侧按键表面； | 1、开关信号发出：DFGLS_RLWindowControl=0x1:Manual Up； 2、左后玻璃升降电机手动上升； | EP1 | EP40 | 单件/台架 | PASS
29 |  |  | 滑动-左后门玻璃自动下降升功能 |  | 1、点触REAR按键； 2、滑动向下且手指迅速离开玻璃升降主开关总成左侧按键表面； | 1、开关信号发出：DFGLS_RLWindowControl=0x4:Auto Down； 2、左后玻璃升降电机自动下降； | EP1 | EP40 | 单件/台架 | PASS
30 |  |  | 滑动后长按-左后门玻璃手动下降升功能 |  | 1、点触REAR按键； 2、滑动向下且手指保持在玻璃升降主开关总成左侧按键表面； | 1、开关信号发出：DFGLS_RLWindowControl=0x2:Manual Down； 2、左后玻璃升降电机手动下降； | EP1 | EP40 | 单件/台架 | PASS
31 |  |  | 滑动-右后门玻璃自动上升功能 |  | 1、点触REAR按键； 2、滑动向上且手指迅速离开玻璃升降主开关总成右侧按键表面； | 1、开关信号发出：DFGLS_RRWindowControl=0x3:Auto Up； 2、右后玻璃升降电机自动上升； | EP1 | EP40 | 单件/台架 | PASS
32 |  |  | 滑动后长按-右后门玻璃手动上升功能 |  | 1、点触REAR按键； 2、滑动向上且手指保持在玻璃升降主开关总成右侧按键表面； | 1、开关信号发出：DFGLS_RRWindowControl=0x1:Manual Up； 2、右后玻璃升降电机手动上升； | EP1 | EP40 | 单件/台架 | PASS
33 |  |  | 滑动-右后门玻璃自动下降升功能 |  | 1、点触REAR按键； 2、滑动向下且手指迅速离开玻璃升降主开关总成右侧按键表面； | 1、开关信号发出：DFGLS_RRWindowControl=0x4:Auto Down； 2、右后玻璃升降电机自动下降； | EP1 | EP40 | 单件/台架 | PASS
34 |  |  | 滑动后长按-右后门玻璃手动下降升功能 |  | 1、点触REAR按键； 2、滑动向下且手指保持在玻璃升降主开关总成右侧按键表面； | 1、开关信号发出：DFGLS_RRWindowControl=0x2:Manual Down； 2、右后玻璃升降电机手动下降； | EP1 | EP40 | 单件/台架 | PASS
35 |  |  | 背光等级调节 |  | 1、模拟DDCU发送整车背光灯状态信号 白天、夜晚模式信号发送DDCU_BDCS1_BacklightStatus=0x1:Active； 2、模拟DDCU发送背光等级信号发送 DDCU_BDCS1_Backlight_brightness_fb= 0x1:Level 1 0x2:Level 2 0x3:Level 3 0x4:Level 4 0x5:Level 5 0x6:Level 6 0x7:Level 7 0x8:Level 8 | 开关夜晚背光分等级变化，白天为最大等级 | EP1 | EP40 | 单件 | PASS
36 |  |  | 按键声音 |  | 触摸开关任意按键 | 开关信号发出：DFGLS_ButtonSoundRequest=0x1:Press | EP1 | EP40 | 单件 | PASS
37 |  |  | 压力感应/震动反馈 |  | 对开关面板上的字符进行操作，施加一定力度； | 施加力度后功能方可触发，同时面板振动； | EP1 | EP40 | 单件 | NG | 软件暂未体现

Sheet: 玻璃升降副开关总成功能测试
用例编号 | 零件号 | 零件名称 | 测试项目 | 前置条件 | 操作步骤 | 预期结果 | 阶段 | 车型 | 测试环境 | 测试结果 | 备注
1 | C40-3774020 | 玻璃升降副开关总成 | 点动-右前门玻璃自动上升功能 | 1、正常工作电压； 2、针脚接线正确； 3、PDCU报头能正常发送； | 点触玻璃升降副开关总成成右前门上升按键； | 1、开关信号发出：PFGLS_RLWindowControl0x3:Auto Up； 2、右前玻璃升降电机自动上升； | EP1 | EP40 | 单件/台架 | PASS
2 |  |  | 长按-右前门玻璃手动上升功能 |  | 长按玻璃升降副开关总成成右前门上升按键； | 1、开关信号发出：PFGLS_RLWindowControl=x1:Manual Up； 2、右前玻璃升降电机手动上升； | EP1 | EP40 | 单件/台架 | PASS
3 |  |  | 点动-右前门玻璃自动下降升功能 |  | 点触玻璃升降副开关总成右前门下降按键； | 1、开关信号发出：PFGLS_RLWindowControl=0x4:Auto Down； 2、右前玻璃升降电机自动下降； | EP1 | EP40 | 单件/台架 | PASS
4 |  |  | 长按-右前门玻璃手动下降升功能 |  | 长按玻璃升降副开关总成右前门下降按键； | 1、开关信号发出：PFGLS_RLWindowControl=0x2:Manual Down； 2、右前玻璃升降电机手动下降； | EP1 | EP40 | 单件/台架 | PASS
5 |  |  | 滑动-右前门玻璃自动上升功能 |  | 滑动向上且手指迅速离开玻璃升降副开关总成右侧按键表面； | 1、开关信号发出：PFGLS_RLWindowControl=0x3:Auto Up； 2、右前玻璃升降电机自动上升； | EP1 | EP40 | 单件/台架 | PASS
6 |  |  | 滑动后长按-右前门玻璃手动上升功能 |  | 滑动向上且手指保持在玻璃升降副开关总成右侧按键表面； | 1、开关信号发出：PFGLS_RLWindowControl=0x1:Manual Up； 2、右前玻璃升降电机手动上升； | EP1 | EP40 | 单件/台架 | PASS
7 |  |  | 滑动-右前门玻璃自动下降升功能 |  | 滑动向下且手指迅速离开玻璃升降副开关总成右侧按键表面； | 1、开关信号发出：PFGLS_RLWindowControl=0x4:Auto Down； 2、右前玻璃升降电机自动下降； | EP1 | EP40 | 单件/台架 | PASS
8 |  |  | 滑动后长按-右前门玻璃手动下降升功能 |  | 滑动向下且手指保持在玻璃升降副开关总成右侧按键表面； | 1、开关信号发出：PFGLS_RLWindowControl=0x2:Manual Down； 2、右前玻璃升降电机手动下降； | EP1 | EP40 | 单件/台架 | PASS
9 |  |  | 背光等级调节 |  | 1、模拟DDCU发送整车背光灯状态信号 白天、夜晚模式信号发送BDCS1_BacklightStatus=0x1:Active； 2、模拟PDCU发送背光等级信号发送 PDCU_BDCS1_Backlight_brightness_fb= 0x1:Level 1 0x2:Level 2 0x3:Level 3 0x4:Level 4 0x5:Level 5 0x6:Level 6 0x7:Level 7 0x8:Level 8 | 开关夜晚背光分等级变化，白天为最大等级 | EP1 | EP40 | 单件 | PASS
10 |  |  | 按键声音 |  | 触摸开关任意按键 | 开关信号发出：PFGLS_ButtonSoundRequest=0x1:Press | EP1 | EP40 | 单件 | PASS
11 |  |  | 自定义功能 |  | 点触自定义按键表面 | 开关信号发出：PFGLS_CustomSignal=0x1:Active | EP1 | EP40 | 单件/台架 | PASS

Sheet: 左后玻璃升降开关总成功能测试
用例编号 | 零件号 | 零件名称 | 测试项目 | 前置条件 | 操作步骤 | 预期结果 | 阶段 | 车型 | 测试环境 | 测试结果 | 备注
1 | C40-3774030 | 左后玻璃升降开关总成 | 点动-左后门玻璃自动上升功能 | 1、正常工作电压； 2、针脚接线正确； 3、PDCU报头能正常发送； | 1、点触REAR按键； 2、点触左后玻璃升降开关总成左后门上升按键； | 1、开关信号发出：DRGLS_FRWindowControl=0x3:Auto Up； 2、左后玻璃升降电机自动上升； | EP1 | EP40 | 单件/台架 | PASS
2 |  |  | 长按-左后门玻璃手动上升功能 |  | 1、点触REAR按键； 2、长按左后玻璃升降开关总成左后门上升按键； | 1、开关信号发出：DRGLS_FRWindowControl=0x1:Manual Up； 2、左后玻璃升降电机手动上升； | EP1 | EP40 | 单件/台架 | PASS
3 |  |  | 点动-左后门玻璃自动下降升功能 |  | 1、点触REAR按键； 2、点触左后玻璃升降开关总成左后门下降按键； | 1、开关信号发出：DRGLS_FRWindowControl=0x4:Auto Down； 2、左后玻璃升降电机自动下降； | EP1 | EP40 | 单件/台架 | PASS
4 |  |  | 长按-左后门玻璃手动下降升功能 |  | 1、点触REAR按键； 2、长按左后玻璃升降开关总成左后门下降按键； | 1、开关信号发出：DRGLS_FRWindowControl=0x2:Manual Down； 2、左后玻璃升降电机手动下降； | EP1 | EP40 | 单件/台架 | PASS
5 |  |  | 滑动-左后门玻璃自动上升功能 |  | 1、点触REAR按键； 2、滑动向上且手指迅速离开左后玻璃升降开关总成左侧按键表面； | 1、开关信号发出：DRGLS_FRWindowControl=0x3:Auto Up； 2、左后玻璃升降电机自动上升； | EP1 | EP40 | 单件/台架 | PASS
6 |  |  | 滑动后长按-左后门玻璃手动上升功能 |  | 1、点触REAR按键； 2、滑动向上且手指保持在左后玻璃升降开关总成左侧按键表面； | 1、开关信号发出：DRGLS_FRWindowControl=0x1:Manual Up； 2、左后玻璃升降电机手动上升； | EP1 | EP40 | 单件/台架 | PASS
7 |  |  | 滑动-左后门玻璃自动下降升功能 |  | 1、点触REAR按键； 2、滑动向下且手指迅速离开左后玻璃升降开关总成左侧按键表面； | 1、开关信号发出：DRGLS_FRWindowControl=0x4:Auto Down； 2、左后玻璃升降电机自动下降； | EP1 | EP40 | 单件/台架 | PASS
8 |  |  | 滑动后长按-左后门玻璃手动下降升功能 |  | 1、点触REAR按键； 2、滑动向下且手指保持在左后玻璃升降开关总成左侧按键表面； | 1、开关信号发出：DRGLS_FRWindowControl=0x2:Manual Down； 2、左后玻璃升降电机手动下降； | EP1 | EP40 | 单件/台架 | PASS
9 |  |  | 背光等级调节 |  | 1、模拟DDCU发送整车背光灯状态信号 白天、夜晚模式信号发送DDCU_BDCS1_BacklightStatus=0x1:Active； 2、模拟DDCU发送背光等级信号发送 DDCU_BDCS1_Backlight_brightness_fb= 0x1:Level 1 0x2:Level 2 0x3:Level 3 0x4:Level 4 0x5:Level 5 0x6:Level 6 0x7:Level 7 0x8:Level 8 | 开关夜晚背光分等级变化，白天为最大等级 | EP1 | EP40 | 单件 | PASS
10 |  |  | 自定义功能 |  | 点触自定义按键表面 | 开关信号发出：DRGLS_CustomSignal=0x1:Active | EP1 | EP40 | 单件/台架 | PASS
11 |  |  | 按键声音 |  | 触摸开关任意按键 | 开关信号发出：DRGLS_ButtonSoundRequest=0x1:Press | EP1 | EP40 | 单件 | PASS

Sheet: 右后玻璃升降开关总成功能测试
用例编号 | 零件号 | 零件名称 | 测试项目 | 前置条件 | 操作步骤 | 预期结果 | 阶段 | 车型 | 测试环境 | 测试结果 | 备注
1 | C40-3774040 | 右后玻璃升降开关总成 | 点动-右后门玻璃自动上升功能 | 1、正常工作电压； 2、针脚接线正确； 3、PDCU报头能正常发送； | 1、点触REAR按键； 2、点触玻璃升降主开关总成右后门上升按键； | 1、开关信号发出：PRGLS_RRWindowControl=0x3:Auto Up； 2、右后玻璃升降电机自动上升； | EP1 | EP40 | 单件/台架 | PASS
2 |  |  | 长按-右后门玻璃手动上升功能 |  | 1、点触REAR按键； 2、长按玻璃升降主开关总成右后门上升按键； | 1、开关信号发出：PRGLS_RRWindowControl=0x1:Manual Up； 2、右后玻璃升降电机手动上升； | EP1 | EP40 | 单件/台架 | PASS
3 |  |  | 点动-右后门玻璃自动下降升功能 |  | 1、点触REAR按键； 2、点触玻璃升降主开关总成右后门下降按键； | 1、开关信号发出：PRGLS_RRWindowControl=0x4:Auto Down； 2、右后玻璃升降电机自动下降； | EP1 | EP40 | 单件/台架 | PASS
4 |  |  | 长按-右后门玻璃手动下降升功能 |  | 1、点触REAR按键； 2、长按玻璃升降主开关总成右后门下降按键； | 1、开关信号发出：PRGLS_RRWindowControl=0x2:Manual Down； 2、右后玻璃升降电机手动下降； | EP1 | EP40 | 单件/台架 | PASS
5 |  |  | 滑动-右后门玻璃自动上升功能 |  | 1、点触REAR按键； 2、滑动向上且手指迅速离开玻璃升降主开关总成右侧按键表面； | 1、开关信号发出：PRGLS_RRWindowControl=0x3:Auto Up； 2、右后玻璃升降电机自动上升； | EP1 | EP40 | 单件/台架 | PASS
6 |  |  | 滑动后长按-右后门玻璃手动上升功能 |  | 1、点触REAR按键； 2、滑动向上且手指保持在玻璃升降主开关总成右侧按键表面； | 1、开关信号发出：PRGLS_RRWindowControl=0x1:Manual Up； 2、右后玻璃升降电机手动上升； | EP1 | EP40 | 单件/台架 | PASS
7 |  |  | 滑动-右后门玻璃自动下降升功能 |  | 1、点触REAR按键； 2、滑动向下且手指迅速离开玻璃升降主开关总成右侧按键表面； | 1、开关信号发出：PRGLS_RRWindowControl=0x4:Auto Down； 2、右后玻璃升降电机自动上升； | EP1 | EP40 | 单件/台架 | PASS
8 |  |  | 滑动后长按-右后门玻璃手动下降升功能 |  | 1、点触REAR按键； 2、滑动向下且手指保持在玻璃升降主开关总成右侧按键表面； | 1、开关信号发出：PRGLS_RRWindowControl=0x2:Manual Down； 2、右后玻璃升降电机手动上升； | EP1 | EP40 | 单件/台架 | PASS
9 |  |  | 背光等级调节 |  | 1、模拟PDCU发送整车背光灯状态信号 白天、夜晚模式信号发送BDCS1_BacklightStatus=0x1:Active； 2、模拟PDCU发送背光等级信号发送 PDCU_BDCS1_Backlight_brightness_fb= 0x1:Level 1 0x2:Level 2 0x3:Level 3 0x4:Level 4 0x5:Level 5 0x6:Level 6 0x7:Level 7 0x8:Level 8 | 开关夜晚背光分等级变化，白天为最大等级 | EP1 | EP40 | 单件 | PASS
10 |  |  | 按键声音 |  | 触摸开关任意按键 | 开关信号发出：PRGLS_ButtonSoundRequest=0x1:Press | EP1 | EP40 | 单件 | PASS
11 |  |  | 自定义功能 |  | 点触自定义按键表面 | 开关信号发出：PRGLS_CustomSignal=0x1:Active | EP1 | EP40 | 单件/台架 | PASS
