czc13611858691/hozonEp40/doc/自测报告模板/xx项目_xx阶段_xxECU_AUTOSAR测试报告-xxxx.xx.xx日期.xlsx

Sheet: 封面
XXX项目单件AUTOSAR测试
测试报告-XXX（ECU）
 | 编 制： | XX
 | 审 核 | XX

Sheet: 外围测试环境
1 外围测试环境
1.1 需求文档
No. | 类型 | 版本 | 更新日期 | 文件名称 | 备注
[1] | 功能需求规范 | 01版 |  | Q THZ B1-69-2016 控制器软硬件版本格式编制规则 Q THZ E8-3-2015 汽车电子CANBUS通讯系统信号列表规范 Q THZ E8-31-2019 新能源汽车CAN总线网络管理技术要求AUTOSAR
1.2 测试工具
No. | 类别 | 名称 | 型号 | 设备编号 | 备注
[1] | 总线监控及仿真设备 | CANoe | 1640A | 无 | 无

Sheet: 内部环境
版本信息
项目 | XXX | 测试模块 | XXX
测试阶段 | XXX | 测试日期 | XXXX/XX/XX
零部件号 | XX… | 软件版本/F1C0 | XX.XX.XX
硬件版本/F191 | XX.XX | Boot版本/F180 | XX.XX.XX
供应商名称 | XXX | 测试申请人 | XXX
通信矩阵版本 | XX… | 诊断协议版本 | XX…

Sheet: 测试报告
AUTOSAR Test Report
Class | Testcase number | Testcase | verdict | Test record | QA Contact | remark
BSM | ASRNM_TG1_TC1_SC1 | NM报文唤醒数据场测试
 | ASRNM_TG1_TC1_SC2 | 本地唤醒数据场测试
 | ASRNM_TG1_TC2_SC1 | 网络管理地址范围测试(NM报文)
 | ASRNM_TG1_TC2_SC2 | 网络管理地址范围测试（APP报文）
 | ASRNM_TG2_TC1_BSM | BSM Test
RMS | ASRNM_TG2_TC2_SC1_BSM_RMS | BSM-RMS Test(NM唤醒)
 | ASRNM_TG2_TC2_SC2_BSM_RMS | BSM-RMS Test(本地唤醒)
NOS | ASRNM_TG2_TC3_SC1_RMS_NOS_RSS_NOS | RMS-NOS-RSS-NOS Test(NM唤醒)
 | ASRNM_TG2_TC3_SC2_RMS_NOS_RSS_NOS | RMS-NOS-RSS-NOS Test(本地唤醒)
 | ASRNM_TG2_TC3_SC3_RMS_NOS_RSS_NOS | RMS-NOS-RSS-NOS Test(唤醒源遍历)
RSS | ASRNM_TG2_TC4_SC1_RMS_RSS_NOS | RMS-RSS-NOS Test(NM唤醒)
 | ASRNM_TG2_TC4_SC2_RMS_RSS_NOS | RMS-RSS-NOS Test(本地唤醒)
RMS | ASRNM_TG2_TC5_SC1_NOS_RMS | NOS-RMS Test(NM唤醒)
 | ASRNM_TG2_TC5_SC2_NOS_RMS | NOS-RMS Test(本地唤醒)
 | ASRNM_TG2_TC6_SC1_RSS_RMS | RSS-RMS Test(NM唤醒)
 | ASRNM_TG2_TC6_SC2_RSS_RMS | RSS-RMS Test(本地唤醒)
PBM | ASRNM_TG2_TC7_SC1_RSS_PBM_RMS | RSS-PBM-RMS Test(本地唤醒)
 | ASRNM_TG2_TC7_SC2_RSS_PBM_RMS | RSS-PBM-RMS Test(NM唤醒)
 | ASRNM_TG2_TC7_SC3_RSS_PBM_RMS | RSS-PBM-RMS Test(本地唤醒)
 | ASRNM_TG2_TC8_SC1_RSS_PBM_RMS | RSS-PBM-RMS Test(NM唤醒)
 | ASRNM_TG2_TC8_SC2_RSS_PBM_RMS | RSS-PBM-RMS Test(NM唤醒)
 | ASRNM_TG2_TC8_SC3_RSS_PBM_RMS | RSS-PBM-RMS Test(本地唤醒)
BSM | ASRNM_TG2_TC9_SC1_RSS_PBM_BSM | RSS-PBM-BSM Test(NM唤醒)
 | ASRNM_TG2_TC9_SC2_RSS_PBM_BSM | RSS-PBM-BSM Test(本地唤醒)
 | ASRNM_TG2_TC10_SC1_RSS_PBM_BSM | RSS-PBM-BSM Test(NM唤醒)
 | ASRNM_TG2_TC10_SC2_RSS_PBM_BSM | RSS-PBM-BSM Test(本地唤醒)
Cycle | ASRNM_TG2_TC11_SC1_CycleTest | CycleTesst(NM唤醒)
 | ASRNM_TG2_TC11_SC2_CycleTesst | CycleTesst(本地唤醒)
BusOff | ASRNM_TG3_TC1_SC1 | BusOff Handle Test
 | ASRNM_TG3_TC1_SC2 | BusOff Handle Test
 | ASRNM_TG3_TC2 | Node off-line Handle Test
Diag | ASRNM_TG4_TC1_SC1 | N0S_Diag
 | ASRNM_TG4_TC1_SC2 | RSS_Diag
 | ASRNM_TG4_TC2 | PBM_Diag

Sheet: 测试结果统计
测试用例执行及结果统计：
 | 测试用例总数 | PASS | FAIL | NT | NA
总计 | 31 | 0 | 0 | 0 | 0
比例 | 100.00% | 0.00% | 0.00% | 0.00% | 0.00%

Sheet: 项目交付物
AUTOSAR Test Report
项目： | XXX |  |  | 测试模块： |  | XXX
阶段： | XXX |  |  | 测试日期： |  | XXXX/XX/XX
认可软件版本： |  | XX.XX.XX |  | 认可硬件版本： |  | XX.XX
认可Boot版本： |  | XX.XX.XX |  | 零部件号： |  | XX…
诊断协议版本： |  | XX…
通信矩阵版本： |  | XX…
申请人： |  | XXX |  | 执行人： |  | XX
序号 | 测试项 |  |  | 结论 |  |  | 备注
TG1 | BSM |  | PASS | PASS
TG2 | RMS | RMS | PASS | PASS
TG3 | NOS | NOS | PASS | PASS
TG4 | RSS | RSS | PASS | PASS
TG5 | RMS | RMS | PASS | PASS
TG6 | PBM | PBM | PASS | PASS
TG7 | BSM | BSM | PASS | PASS
TG8 | Cycle | Cycle | PASS | PASS
TG9 | BusOff | BusOff | PASS | PASS
TG10 | Diag | Diag | PASS | PASS
 | 编制： |  | XX |  | 审核： |  | XX
