czc13611858691/hozonEp40/doc/自测报告模板/xx项目_xx阶段_xxECU_LIN从节点网络测试报告-xxxx.xx.xx日期.xlsx

Sheet: 封面
XXX项目单件LIN网络从节点测试
测试报告-XXX（ECU）
 | 编 制：
 | 审 核

Sheet: 外围测试环境
1 外围测试环境
1.1 需求文档
No. | 类型 | 版本 | 更新日期 | 文件名称 | 备注
[1] | 功能需求规范 | 01版 |  | Q THZ B1-69-2016 控制器软硬件版本格式编制规则 Q THZ E8-3-2015 汽车电子CANBUS通讯系统信号列表规范 Q THZ E8-31-2019 新能源汽车CAN总线网络管理技术要求AUTOSAR
1.2 测试工具
No. | 类别 | 名称 | 型号 | 设备编号 | 备注
[1] | 总线监控及仿真设备 | CANoe | 1640A | 无 | 无

Sheet: 内部环境
版本信息（标签模板，不支持信息可不填写）
项目 | XXX | 测试模块 | XXX
测试阶段 | XXX | 测试日期 | XXXX/XX/XX
供应商名称 | XXX | 软件版本/F1C0 | XX.XX.XX
硬件版本/F191 | XX.XX.XX | Boot版本/F180 | XX.XX.XX
通信矩阵版本 | XX… | 诊断协议版本 | XX…

Sheet: 测试报告
LIN Test Report
Class | Testcase number | Testcase | verdict | Test record | QA Contact | remark
物理层 | TG1_TC1_SC1 | 从节点工作电压范围测试(低压)
 | TG1_TC1_SC2 | 从节点工作电压范围测试（高压）
 | TG1_TC2_SC1 | 从节点输出电平测试（高、低、正常电压）
 | TG1_TC2_SC2 | 从节点输出电平测试（5V方波TX干扰）
数据线路层 | TG2_TC1_SC1 | 从节点波特率(不使用通步场)
 | TG2_TC1_SC2 | 从节点波特率(使用通步场同步)
 | TG2_TC2_SC1 | 从节点兼容测试
 | TG2_TC3_SC1 | 从节点识别间隔场显性电平长度范围
 | TG2_TC4_SC1 | 从节点识别界定符长度范围
 | TG2_TC5_SC1 | 从节点接收报文头长度范围
 | TG2_TC6_SC1 | 从节点响应空间长度范围
 | TG2_TC7_SC1 | 报文DLC检测
 | TG2_TC8_SC1 | 校验方式检测（经典型）
 | TG2_TC8_SC2 | 校验方式检测（增强型）
 | TG2_TC9_SC1 | 总线消息总长度测试
 | TG2_TC10_SC1 | 从节点不完整帧干扰测试
 | TG2_TC11_SC1 | 从节点PID奇偶校验错误测试
网络管理 | TG3_TC1_SC1 | 从节点接收睡眠命令帧
 | TG3_TC2_SC1 | 从节点初始化时间
 | TG3_TC3_SC1 | 总线空闲4s进入睡眠模式
 | TG3_TC4_SC1 | 从节点发送唤醒请求
容错性能 | TG4_TC1_SC1 | 丢失电源
 | TG4_TC1_SC2 | 丢失地漏电流测试
 | TG4_TC2_SC1 | 总线与地短路测试
 | TG4_TC3_SC1 | 总线与电源短路测试
 | TG4_TC3_SC2 | 总线与电源短路掉电测试
 | TG4_TC4_SC1 | 地偏移测试
错误故障监测 | TG5_TC1_SC1 | checksum错误监测
 | TG5_TC2_SC1 | 数据场故障监测（干扰数据场任意位）
 | TG5_TC2_SC2 | 数据场故障监测（干扰数据场结束位）
