czc13611858691/hozonEp40/doc/EP40_SEAT.pdf

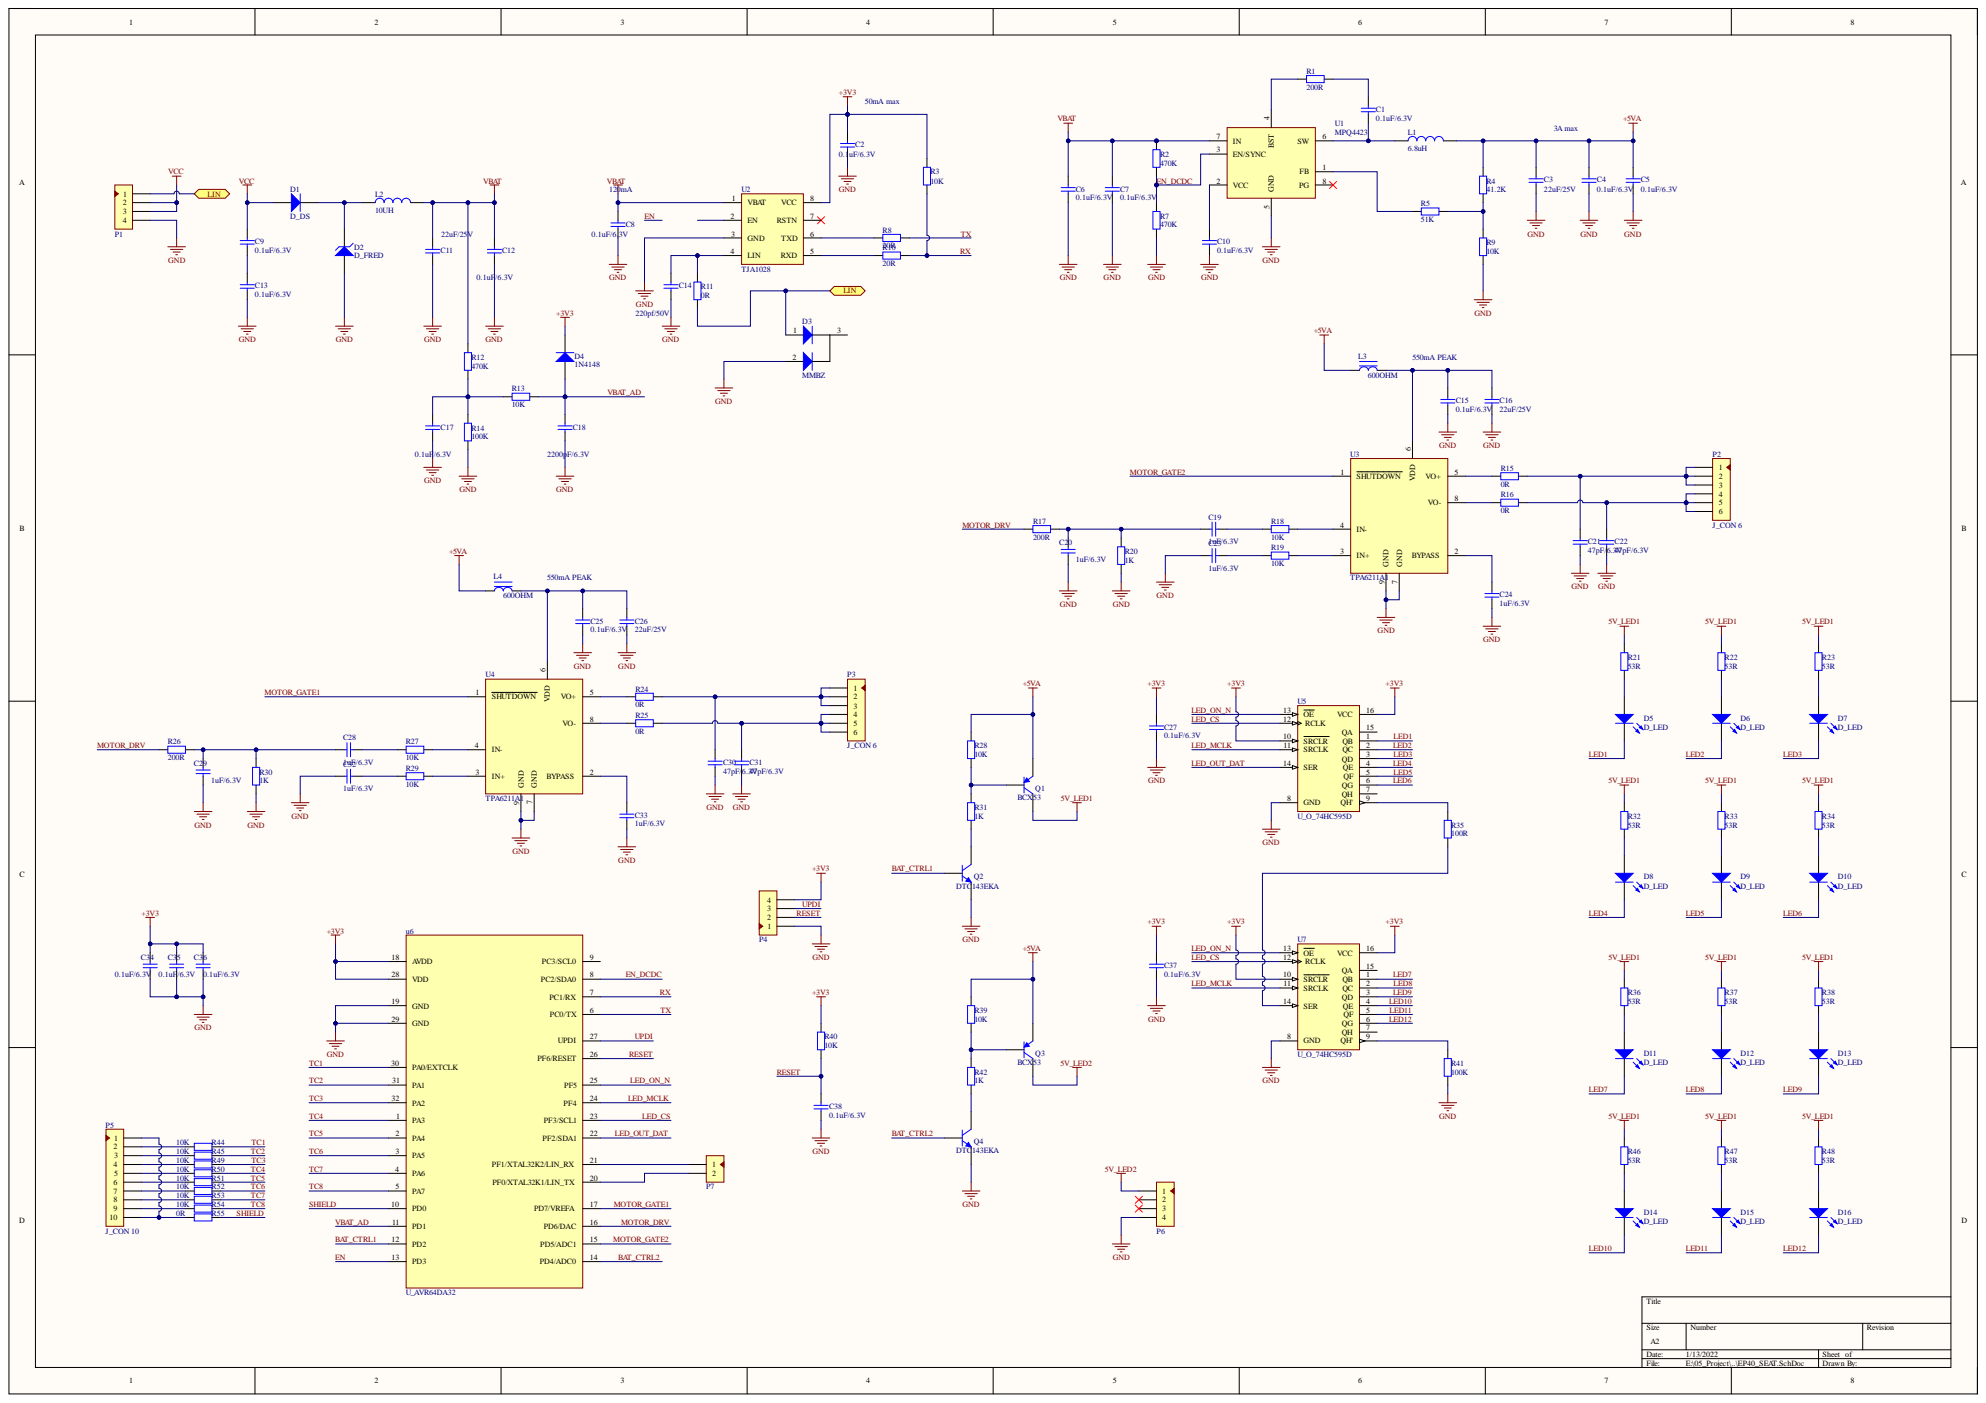
[picture p37: page 1]

470K EN_DCDC

U7U_O_74H OE 13 RC VC SER 14 SRCLR 10 SRCLK 11 L K 12 QB QC QD QE QF QG QH GND QH '

VDD 28 | 8
