czc13611858691/hozonEp40/doc/窗提升开关/原理图/EP40-FR-RR.pdf

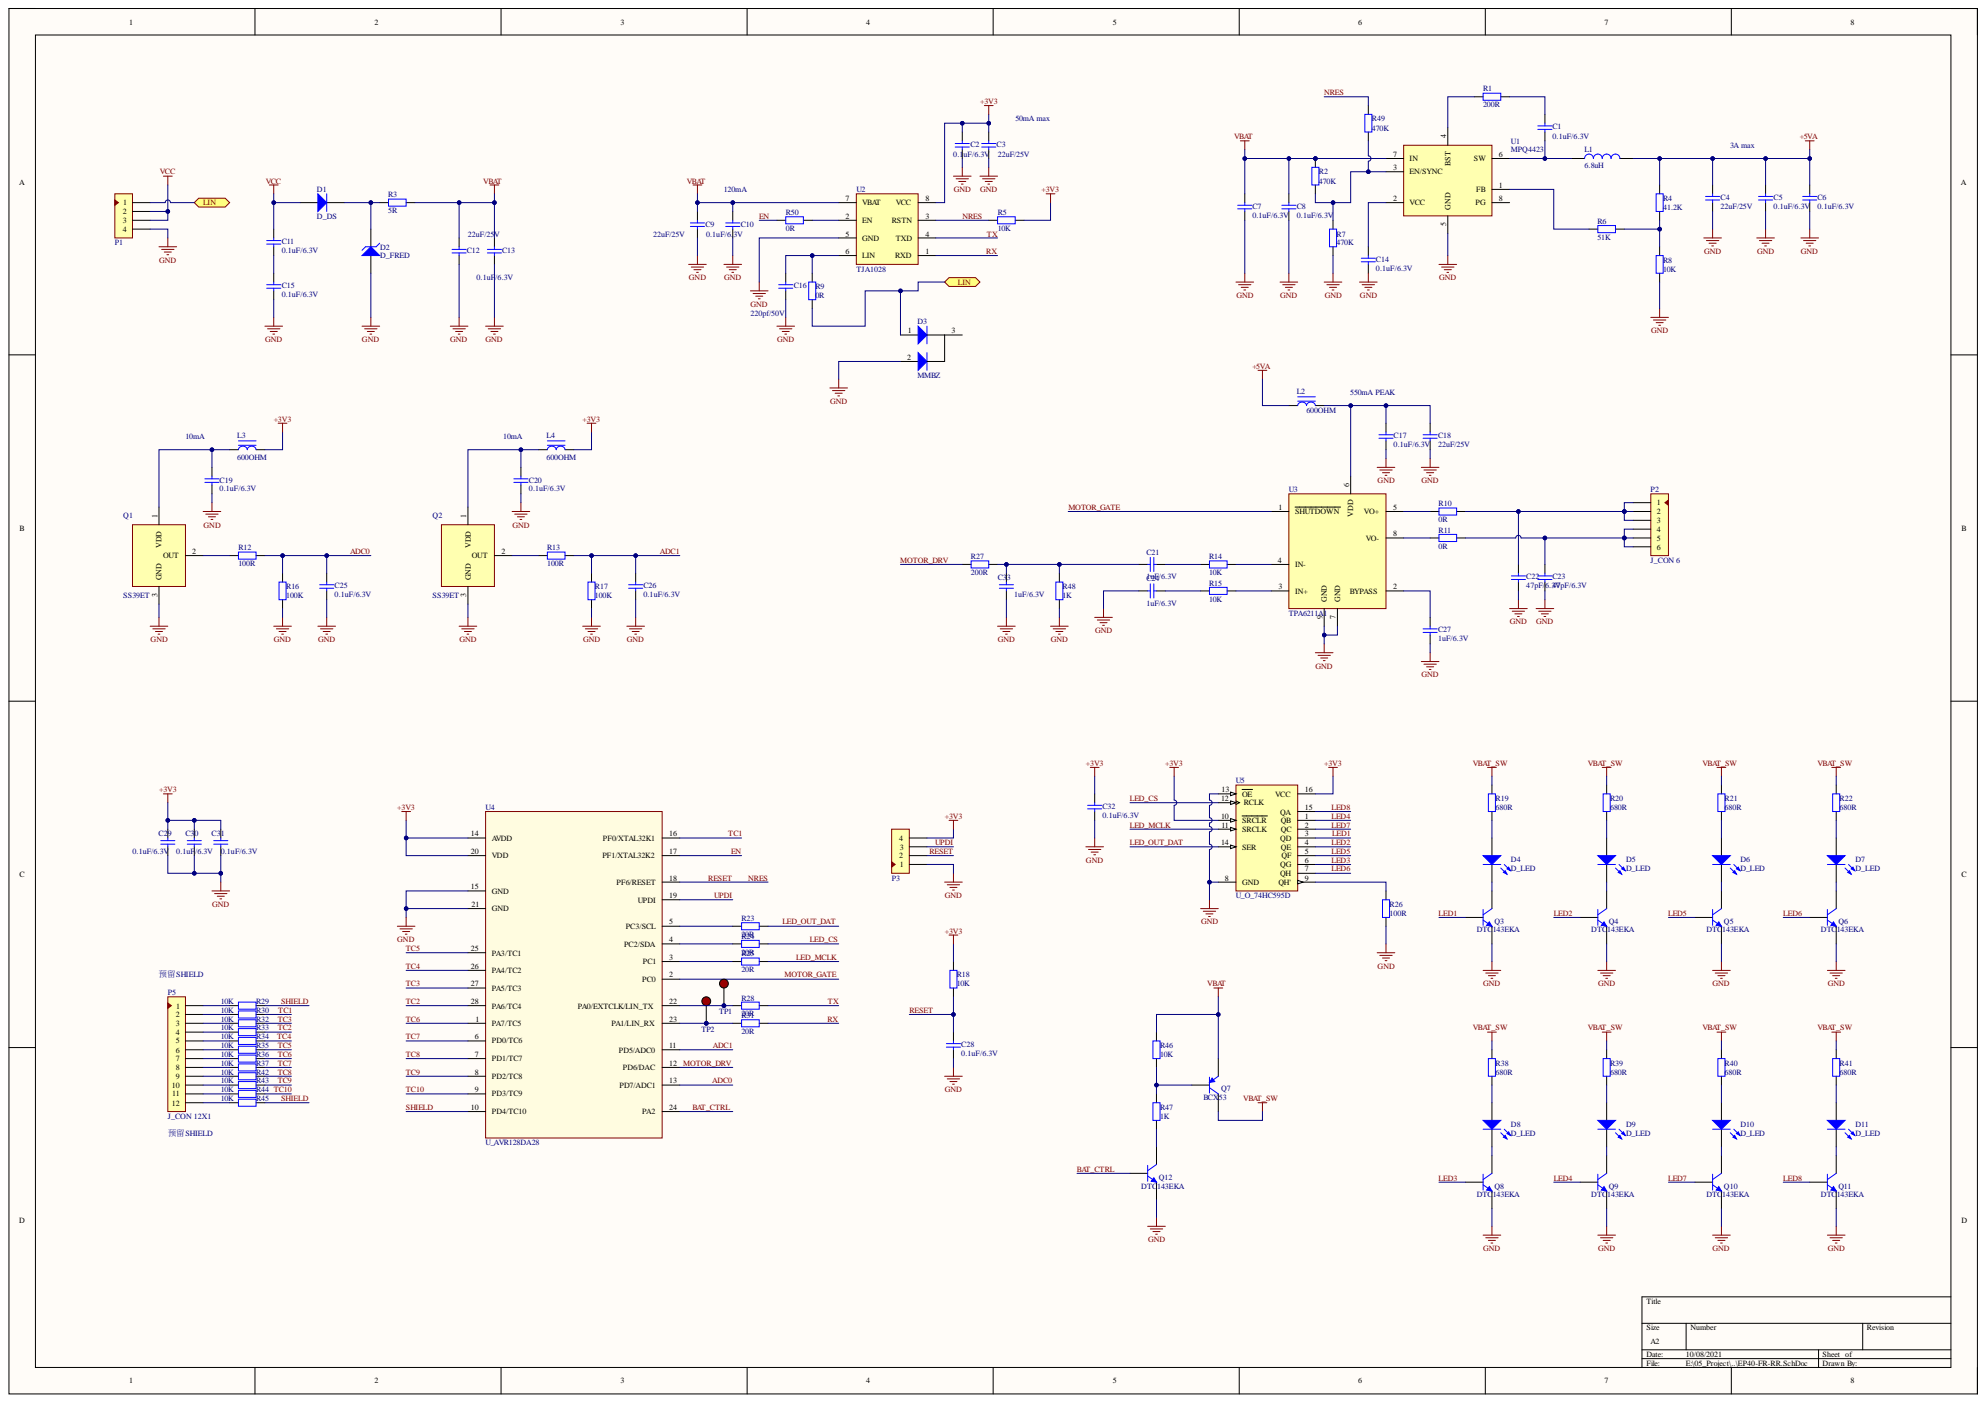
[picture p38: page 1]
