czc13611858691/hozonEp40/doc/窗提升开关/原理图/EP40-MAIN_ver2.pdf

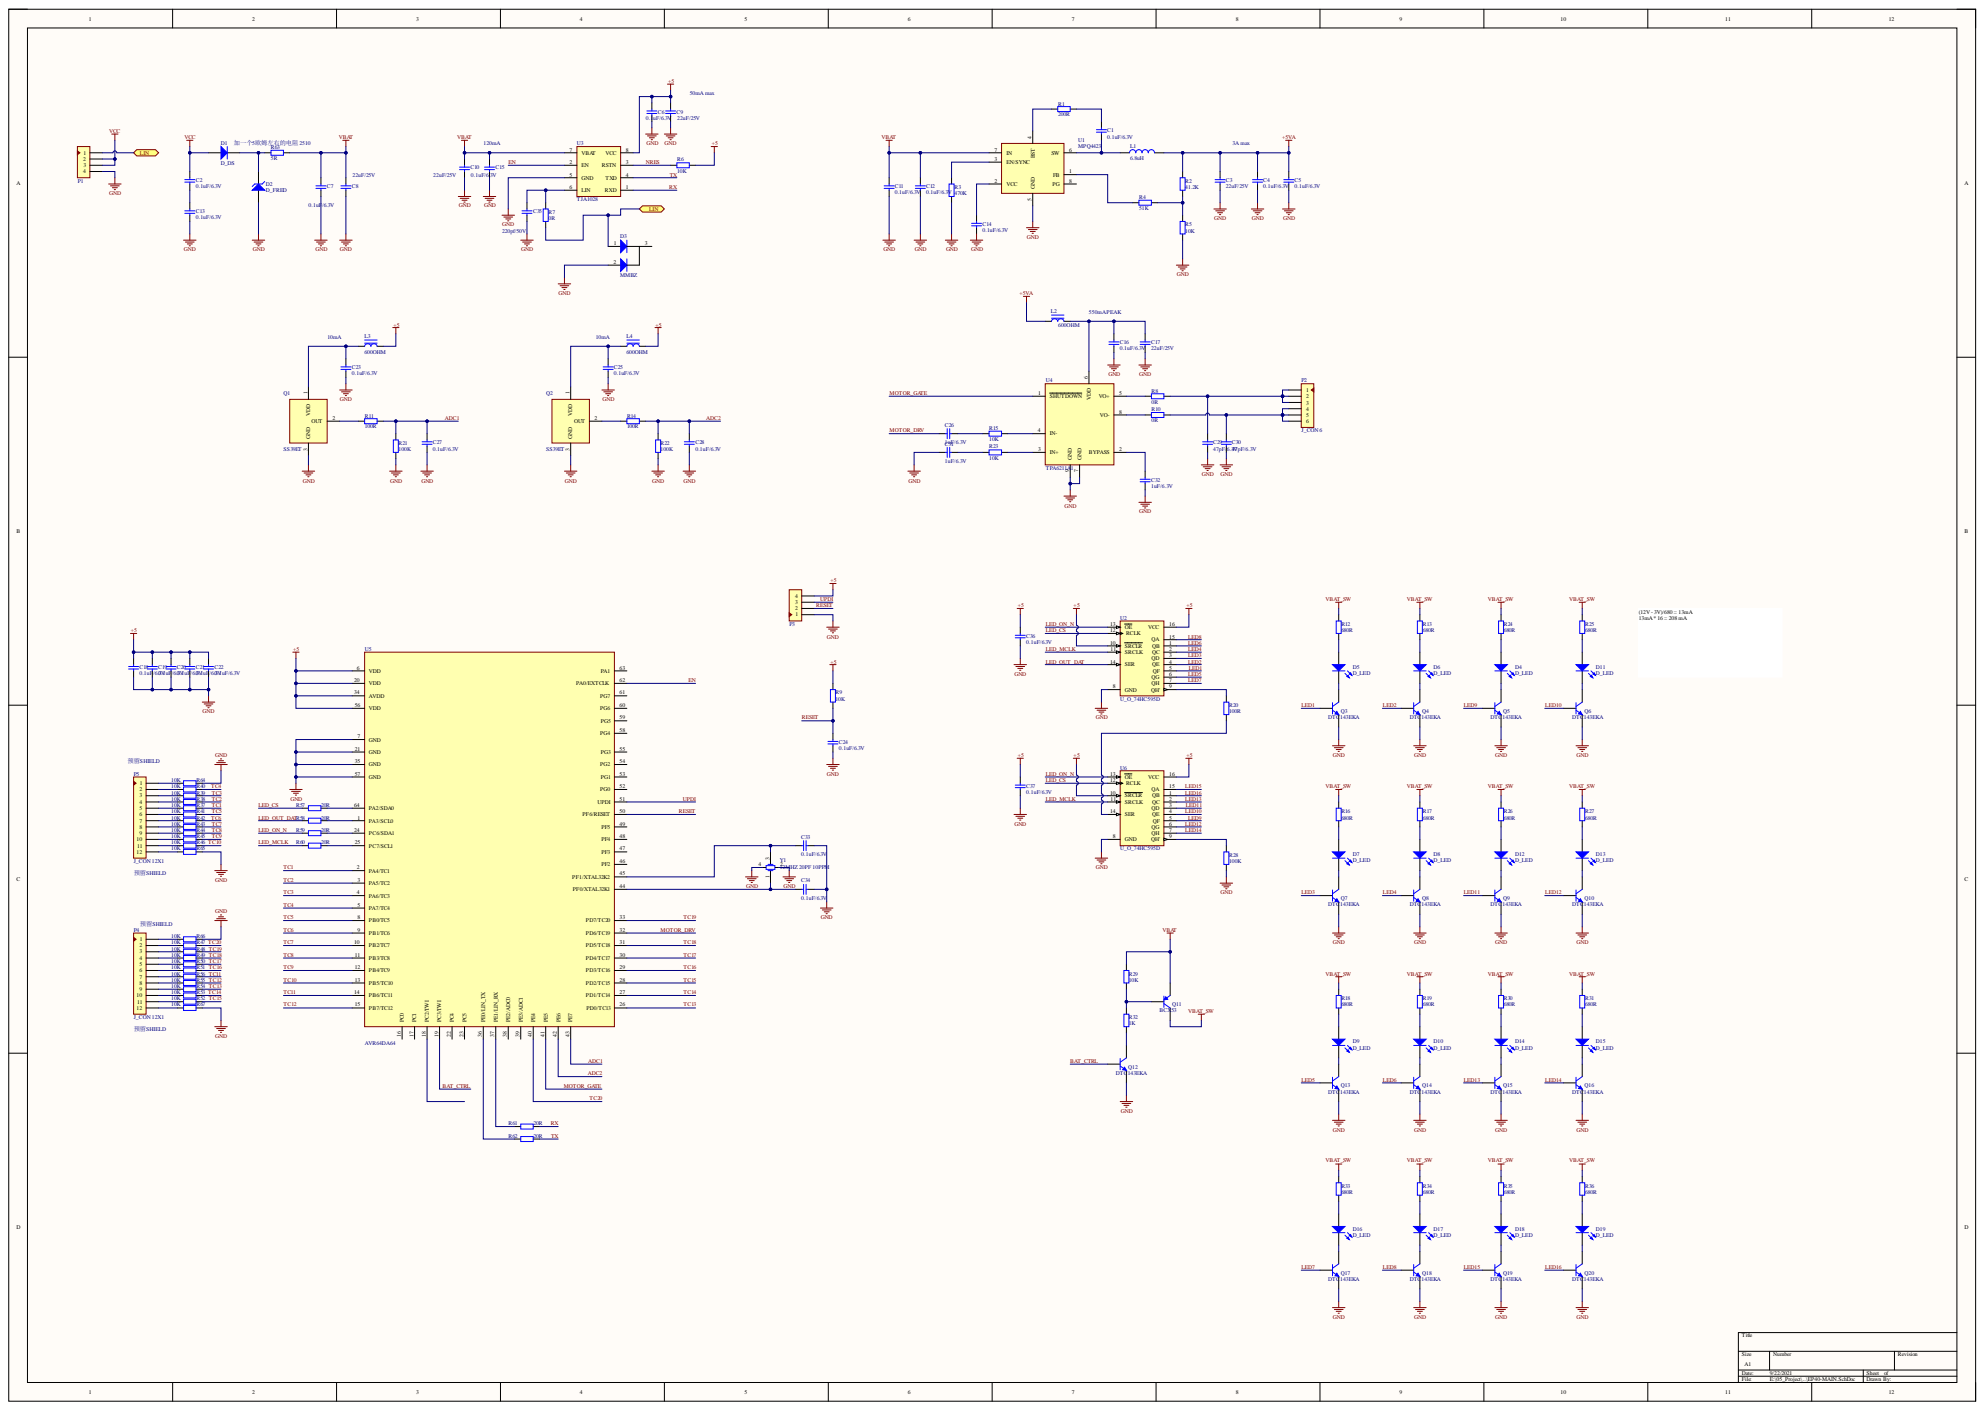
[picture p39: page 1]
