czc13611858691/hozonEp40/doc/窗提升开关/原理图/EP40-RL.pdf

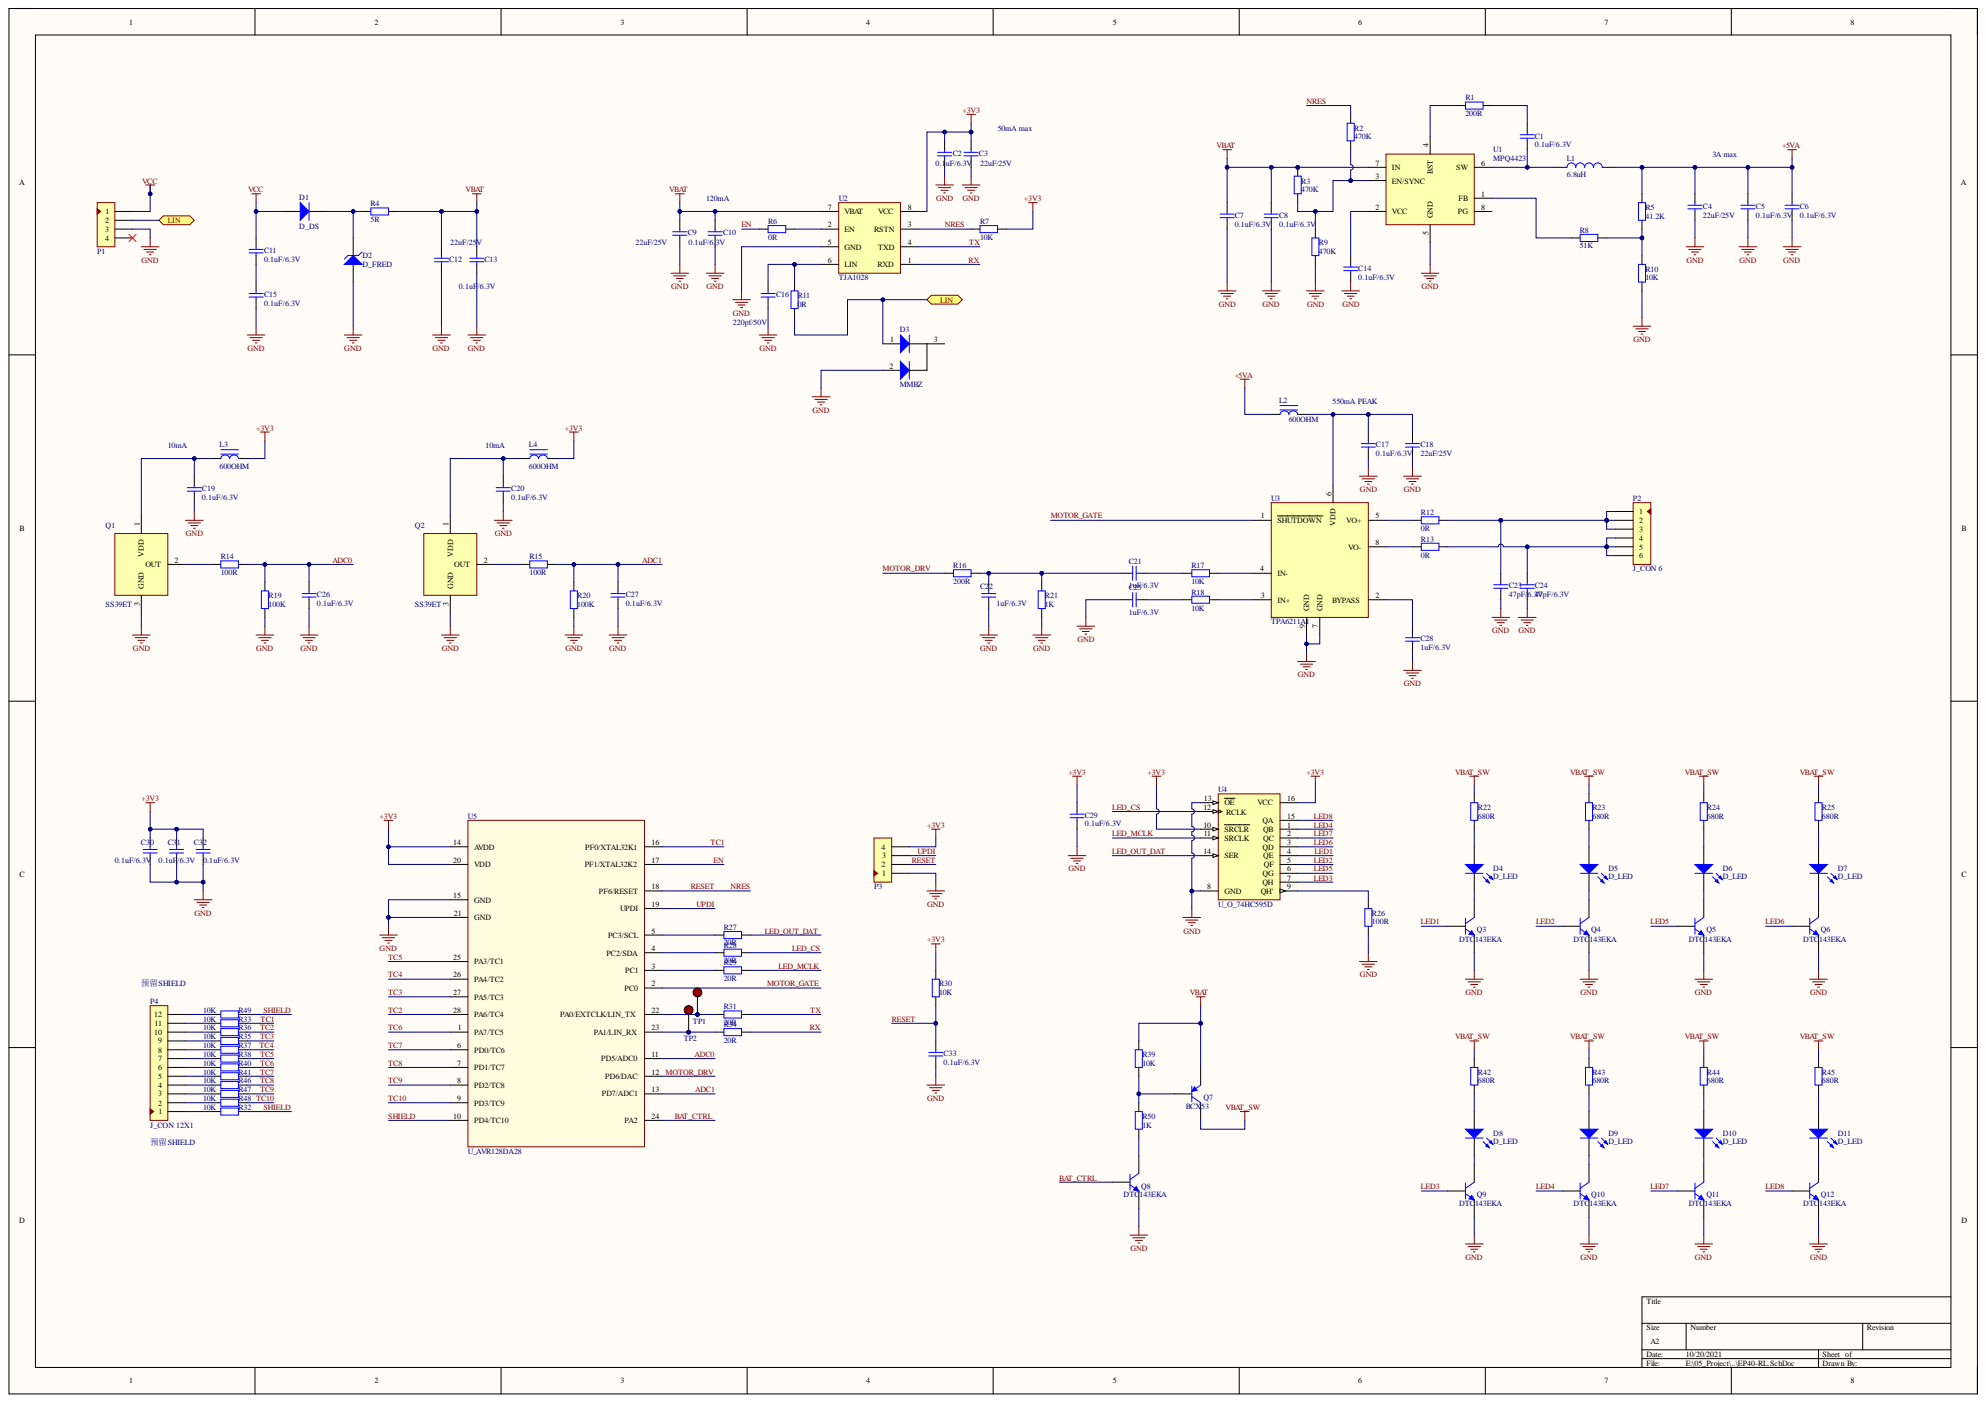
[picture p40: page 1]
