czc13611858691/hozonEp40/code/canoe/RTAS/RTAS.cfg

;CANoe Version |4|11|0|52321 RTAS 
Version: 11.0.81 Build 81
32 PRO
20
APPDIR Vector.CANalyzer.LIN.InteractiveScheduler.DLL
Vector.CANalyzer.LIN.InteractiveScheduler, Version=11.0.81.0, Culture=neutral, PublicKeyToken=null
Vector.CANalyzer.LIN.InteractiveScheduler.Controller.CANwinGateway
1
1.0.0
APPDIR Vector.CANalyzer.LIN.NMWindow.DLL
Vector.CANalyzer.LIN.NMWindow, Version=11.0.81.0, Culture=neutral, PublicKeyToken=null
Vector.CANalyzer.LIN.NMWindow.NMWindow
2
1.0.0
APPDIR Vector.CANalyzer.LIN.NetworkMonitor.DLL
Vector.CANalyzer.LIN.NetworkMonitor, Version=11.0.81.0, Culture=neutral, PublicKeyToken=null
Vector.CANalyzer.LIN.NetworkMonitor.NetworkMonitor
3
1.0.1
APPDIR Vector.CANoe.SignalGenerators.DLL
Vector.CANoe.SignalGenerators, Version=11.0.81.0, Culture=neutral, PublicKeyToken=null
Vector.CANoe.SignalGenerators.ComponentWrapper
4
1.0.1
VGlobalConfiguration 1 Begin_Of_Object
17
VGlobalParameters 2 Begin_Of_Object
31
0
3,100,200,500
1000000 1.000000 0 1000 1 1 0 0 1 1 1 0 0 0 1 0 0 0
1
0
1 1
ResetSignalsOnMeasurementStart=1
VDatabaseContainerStreamer 3 Begin_Of_Object
8
1
<VFileName V7 QL> 1 "..\..\..\..\..\Customer input\功能规范\v2\EP40_BDCS_LIN2_Matrix_V2.1_Release0910(1).ldf" 
EP40_BDCS_LIN2_Matrix_V21_Releas

1
0
5
1

1
0
0
0
0
End_Of_Object VDatabaseContainerStreamer 3
0
0
1
<VFileName V7 QL> 1 "RTAS.cfg" 
0
0
0
1
VPersistentEnvarSelectionData 3 Begin_Of_Object
1
1 1 0 0
~
~
End_Of_Object VPersistentEnvarSelectionData 3
VPersistentExtensionData 3 Begin_Of_Object
3
VPersistentRelation 4 Begin_Of_Object
1
HookDLLActivations
1
1
End_Of_Object VPersistentRelation 4
End_Of_Object VPersistentExtensionData 3
VPersistentTreeStateInfo 3 Begin_Of_Object
1
Version
5
DialogBegin
1
75 75 605 580
SymbolExplorerDialogBegin
1
HistoryBegin
1 0
HistoryEnd
FiltersBegin
Begin
3 0 -1
0
SymbSelHeaderMgrBegin
1 6
0 1 200 0 0
1 1 100 0 0
2 0 100 0 0
3 0 75 1 1
5 1 80 0 0
6 1 200 0 0
15 1 80 0 0
SymbSelHeaderMgrEnd
End
Begin
3 0 -1
-1
SymbSelHeaderMgrBegin
1 4
0 1 200 0 0
10 1 75 0 0
11 1 100 0 0
6 1 200 0 0
SymbSelHeaderMgrEnd
End
Begin
3 0 -1
-1
SymbSelHeaderMgrBegin
1 3
0 1 200 0 0
7 0 100 0 0
6 1 200 0 0
SymbSelHeaderMgrEnd
End

FiltersEnd
0 0
SymbolExplorerDialogEnd

DialogEnd
End_Of_Object VPersistentTreeStateInfo 3
VPrintSettings 3 Begin_Of_Object
1
0 0 0 0 0
0 0 0 0 0 0 0 0 0 1
<VFileName V7 QL> 1 "" 
@@@@
Ausdruck Seite: {PAGE}    {DATE}  {TIME}
Lizenznehmer: {LICENSENAME}
Seriennummer: {LICENSENO}
@@@@
0

End_Of_Object VPrintSettings 3
<VFileName V7 QL> 1 "C:\Users\Public\Documents\Vector\CANoe\Public\Documents\Vector\CANwin\8.0.71\CANwin Demos\templates\portlink1.pre" 
1
VPortlinkConfigurationStreamer 3 Begin_Of_Object
1
1
0
0
0
END_OF_DRIVER
END_OF_PORT_CONFIGURATION_STREAM
End_Of_Object VPortlinkConfigurationStreamer 3
0
1
VWTP20ObsParameters-1:0:0:
FlexRayTP2ObsParameters: 2 0x2 36 VFrTPParams 2 0 1 0 1 1 0 0 8 255 0 :
FlexRayTP2ObsParametersEnd
VDoIPObserverParams 3 Begin_Of_Object
1
1
End_Of_Object VDoIPObserverParams 3
VISOTPParameters-1:active:onlyknown:interleave:stmin:seqnr:unexpected:sender:extended:baseaddr=1024:rxmask=255:storedata:maxlen=65536:pad=54
EOO
DiagnosticsSettingsV1.1
<VFileName V7 BQL> 1 base=cfg "..\..\..\doc\EP40_V02(1).cdd" 
Base_Variant#en-US#CAN_Mixed_Addressing#LIN#RATS#EP40_GLS##0#
EOO
DiagnosticsSettingsV2.0
EP40_GLS
.C#######0x00#1
.T#1;0
.B#LIN
.L#0#1000#1000
.J#2#0#0#0#
EOO
0
0
<VMultibusFilterDialogSettings> V2 275
<VWidthInfoContainer> 6
<VWidthInfo> V2 20 1 -1 36 
<VWidthInfo> V2 1 1 -1 47 
<VWidthInfo> V2 0 1 -1 40 
<VWidthInfo> V2 2 1 -1 47 
<VWidthInfo> V2 4 1 -1 33 
<VWidthInfo> V2 5 3 0 24 1 24 2 24 
<VBusWidthInfoSet> 4
6 0 <VWidthInfoContainer> 7
<VWidthInfo> V2 9 1 -1 33 
<VWidthInfo> V2 7 1 -1 47 
<VWidthInfo> V2 15 1 -1 35 
<VWidthInfo> V2 27 2 0 24 1 24 
<VWidthInfo> V2 12 1 -1 37 
<VWidthInfo> V2 13 1 -1 37 
<VWidthInfo> V2 14 1 -1 40 
7 0 <VWidthInfoContainer> 2
<VWidthInfo> V2 23 1 -1 47 
<VWidthInfo> V2 29 1 -1 47 
8 0 <VWidthInfoContainer> 5
<VWidthInfo> V2 7 1 -1 47 
<VWidthInfo> V2 8 1 -1 30 
<VWidthInfo> V2 11 3 0 30 1 30 3 30 
<VWidthInfo> V2 17 3 0 20 1 20 2 20 
<VWidthInfo> V2 18 6 0 26 1 33 2 26 3 26 4 20 5 40 
9 0 <VWidthInfoContainer> 1
<VWidthInfo> V2 41 1 -1 47 
EndOf <VMultibusFilterDialogSettings>
VGlobalActionsStreamer 3 Begin_Of_Object
3
3
0
End_Of_Object VGlobalActionsStreamer 3
VEventSortingConfigStreamer 3 Begin_Of_Object
1
0
0
0
1
5
1
0
End_Of_Object VEventSortingConfigStreamer 3
FlexRayOptionParameters: 2 0 1 0 1 1 :0 :
FlexRayOptionParametersEnd
VCaplOptionsStreamer 3 Begin_Of_Object
2
17
1448
0
2001
1
2002
0
2005
0
2008
1
2013
1
2020
1
2032
1
2038
1
2039
0
2040
1
2041
1
2054
0
2055
1
2065
0
2135
1
2201
0
1
512
End_Of_Object VCaplOptionsStreamer 3
VSVConfigurationStreamer 3 Begin_Of_Object
1
73
<?xml version="1.0" encoding="utf-8"?>
<systemvariables version="4" />
2
0

End_Of_Object VSVConfigurationStreamer 3
VOfflineBusStatisticSettings 3 Begin_Of_Object
1
1
1
0 1
1 0
0 2
1 0
0 3
1 0
0 4
1 0
0 5
1 0
0 6
1 0
0 7
1 0
0 8
1 0
0 9
1 0
0 10
1 0
0 11
1 0
0 12
1 0
0 13
1 0
0 14
1 0
0 15
1 0
0 16
1 0
0 17
1 0
0 18
1 0
0 19
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
End_Of_Object VOfflineBusStatisticSettings 3
VNETOptionsStreamer 3 Begin_Of_Object
3
0
<VFileName V7 QL> 0 "C:\Users\Public\Documents\Vector\CANoe\11.0 (x64)\Templates\CANoe" 
1

End_Of_Object VNETOptionsStreamer 3
0
1
VUserFileMgrAnlyz 3 Begin_Of_Object
1
0
End_Of_Object VUserFileMgrAnlyz 3
VBasicDiagnosticStreamer 3 Begin_Of_Object
1
0
End_Of_Object VBasicDiagnosticStreamer 3
VCLibraryOptions 3 Begin_Of_Object
1
0
End_Of_Object VCLibraryOptions 3
NValueObjectDisplay::VNameDisplaySettings 3 Begin_Of_Object
3
12
0
4
1
4
2
4
3
4
4
1
5
1
6
4
7
4
8
4
9
6
10
4
11
4
12
0
1
1
1
2
1
3
1
4
1
5
1
6
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
End_Of_Object NValueObjectDisplay::VNameDisplaySettings 3
ConfigurationSavedByCANwBeginner 0
VGlobalExportAndLoggingSettings 3 Begin_Of_Object
8
2
1
0
0
6
1
0.10000000000000001
2
0
0.10000000000000001
2
19
0
1
3
1
0
::
,
.
<VFileName V7 QL> 1 "" 
0
0
0
1
6
0
6
0
0
0.10000000000000001
1
0
0
6
730
0
0.10000000000000001
0
0
-1
End_Of_Object VGlobalExportAndLoggingSettings 3
0
VRTFilterOptions 3 Begin_Of_Object
3
0
0
0
0
0
End_Of_Object VRTFilterOptions 3
VRTTxBufferOptions 3 Begin_Of_Object
2
1
1
500
End_Of_Object VRTTxBufferOptions 3
VRTIRQReductionOptions 3 Begin_Of_Object
2
500
End_Of_Object VRTIRQReductionOptions 3
VPersistentDebuggerOptions 3 Begin_Of_Object
2
64
10000
End_Of_Object VPersistentDebuggerOptions 3
7
0
1
0
0
0
1
0
0
1
VAFDXGlobalSettings 3 Begin_Of_Object
4
1000
15
1
0
0
0
0
End_Of_Object VAFDXGlobalSettings 3
VRTCANErrorFrameOptions 3 Begin_Of_Object
1
1
0
End_Of_Object VRTCANErrorFrameOptions 3
1
ILConfiguration::VProxyManager 3 Begin_Of_Object
1
0
0
End_Of_Object ILConfiguration::VProxyManager 3
4
VGlobalVariableSettings 3 Begin_Of_Object
1
65001
End_Of_Object VGlobalVariableSettings 3
VGeneralLoggingBlockSettings 3 Begin_Of_Object
1
2000
6
0
End_Of_Object VGeneralLoggingBlockSettings 3
0
0
6
0
1
SecurityManager::VSecurityManager 3 Begin_Of_Object
2
0
0
End_Of_Object SecurityManager::VSecurityManager 3
VRTAutosarPDULayerMode 3 Begin_Of_Object
1
2
End_Of_Object VRTAutosarPDULayerMode 3
VErtOptions 3 Begin_Of_Object
1
0
End_Of_Object VErtOptions 3
End_Of_Object VGlobalParameters 2
VDesktopManager 2 Begin_Of_Object
1
0
3
VDesktop 3 Begin_Of_Object
1
Trace
{8AEE295B-AE63-40EF-88EA-C793B7D5A136}
Begin_Of_Multi_Line_String
3
<?xml version="1.0"?><!--



  Actipro Docking/MDI for WinForms

  Copyright (c) 2001-2014 Actipro Software LLC.  All rights reserved.

  http://www.actiprosoftware.com



--><ToolWindowLayout Version="1.0"><LayoutData><HostContainerControl /><AutoHide Dock="Left" /><AutoHide Dock="Right" /><AutoHide Dock="Top" /><AutoHide Dock="Bottom" /><TabbedDocuments Orientation="Horizontal" /><FloatingContainers /><Hidden><ToolWindow Key="{F5E09530-AAE7-48d9-B925-CEF5027AA97D}" Guid="32e4b564-02ec-46fd-9296-f6315c198b9d" State="DockableInsideHost" DockedSize="325, 325" FloatingSize="325, 380"><AutoHideStateInfo RootDock="Left" /><DockedInsideHostStateInfo RootDock="Left" IsAttached="False" /><DockedOutsideHostStateInfo IsAttached="False" /></ToolWindow></Hidden></LayoutData><CustomData /></ToolWindowLayout>
End_Of_Serialized_Data 3
End_Of_Object VDesktop 3
VDesktop 3 Begin_Of_Object
1
Configuration
{8D67C965-AA91-4802-B199-AF23C28058D4}
Begin_Of_Multi_Line_String
3
<?xml version="1.0"?><!--



  Actipro Docking/MDI for WinForms

  Copyright (c) 2001-2014 Actipro Software LLC.  All rights reserved.

  http://www.actiprosoftware.com



--><ToolWindowLayout Version="1.0"><LayoutData><HostContainerControl><ToolWindowContainer Dock="Bottom" Size="1275, 205" SelectedToolWindowGuid="7ea42338-695f-45c6-905b-ec30f7ad24b9"><ToolWindow Key="{63372714-3383-4E08-B637-01C6E097AC1F}" Guid="7ea42338-695f-45c6-905b-ec30f7ad24b9" DockedSize="201, 201" FloatingLocation="7, 474" FloatingSize="300, 180" HasOptions="False" ImageIndex="-1" Text="Write" TitleBarText="Write"><AutoHideStateInfo RootDock="Bottom" /><DockedInsideHostStateInfo RootDock="Bottom" IsAttached="False" /><DockedOutsideHostStateInfo IsAttached="False" /></ToolWindow></ToolWindowContainer></HostContainerControl><AutoHide Dock="Left" /><AutoHide Dock="Right" /><AutoHide Dock="Top" /><AutoHide Dock="Bottom" /><TabbedDocuments Orientation="Horizontal" /><FloatingContainers /><Hidden><ToolWindow Key="{F5E09530-AAE7-48d9-B925-CEF5027AA97D}" Guid="32e4b564-02ec-46fd-9296-f6315c198b9d" State="DockableInsideHost" DockedSize="325, 325" FloatingSize="325, 380"><AutoHideStateIn
kPersistNoLineBreak
fo RootDock="Left" /><DockedInsideHostStateInfo RootDock="Left" IsAttached="False" /><DockedOutsideHostStateInfo IsAttached="False" /></ToolWindow></Hidden></LayoutData><CustomData /></ToolWindowLayout>
End_Of_Serialized_Data 3
End_Of_Object VDesktop 3
VDesktop 3 Begin_Of_Object
1
Analysis
{DC70B216-AC8D-4C91-91E3-4414386CEDBA}
Begin_Of_Multi_Line_String
3
<?xml version="1.0"?><!--



  Actipro Docking/MDI for WinForms

  Copyright (c) 2001-2014 Actipro Software LLC.  All rights reserved.

  http://www.actiprosoftware.com



--><ToolWindowLayout Version="1.0"><LayoutData><HostContainerControl /><AutoHide Dock="Left" /><AutoHide Dock="Right" /><AutoHide Dock="Top" /><AutoHide Dock="Bottom" /><TabbedDocuments Orientation="Horizontal" /><FloatingContainers /><Hidden><ToolWindow Key="{F5E09530-AAE7-48d9-B925-CEF5027AA97D}" Guid="32e4b564-02ec-46fd-9296-f6315c198b9d" State="DockableInsideHost" DockedSize="325, 325" FloatingSize="325, 380"><AutoHideStateInfo RootDock="Left" /><DockedInsideHostStateInfo RootDock="Left" IsAttached="False" /><DockedOutsideHostStateInfo IsAttached="False" /></ToolWindow></Hidden></LayoutData><CustomData /></ToolWindowLayout>
End_Of_Serialized_Data 3
End_Of_Object VDesktop 3
4294967295
4294967295
4294967295
End_Of_Object VDesktopManager 2
2
VDiagnoseBox 2 Begin_Of_Object
1
VDiagnoseBoxRoot 3 Begin_Of_Object
1
VBoxRoot 4 Begin_Of_Object
1
1
1 0 0 1 -1 -1 -1 -1 0 424 960 863
EP40_GLS - Diagnostic Console
1

MDI_DOCK_INFO_END
5
1
6
0 1 -1 -1 -1 -1 0 424 960 863
6 0 0 0 0 0 0 0 0 0 0 0 0 0 0 0 0 0 0 0 0 0 0 -1 -1 32767 0 0 0 0 0 0 0 0 0 0 -1 -1 0 0 0 0 0 0 
END_OF_DOCK_INFO
1
0
0
0
1
1920 848
END_OF_DESKTOP_DATA
6
0 1 -1 -1 -1 -1 255 126 1020 565
6 0 0 0 0 0 0 0 0 0 0 0 0 0 0 0 0 0 0 0 0 0 0 -1 -1 32767 0 0 0 0 0 0 0 0 0 0 -1 -1 0 0 0 0 0 0 
END_OF_DOCK_INFO
0
2
0
0
1
1275 632
END_OF_DESKTOP_DATA
6
0 1 0 0 0 0 255 126 1020 506
6 0 0 0 0 0 0 0 0 0 0 0 0 0 0 0 0 0 0 0 0 0 0 -1 -1 32767 0 0 0 0 0 0 0 0 0 0 -1 -1 0 0 0 0 0 0 
END_OF_DOCK_INFO
0
1
0
0
0
0 0
END_OF_DESKTOP_DATA
END_OF_DESKTOP_DATA_COLLECTION
0
0 0
END_OF_DESKTOP_MEMBER
{42B95611-E9C1-4D0B-904E-C19DCD3E5D52}
0
End_Of_Object VBoxRoot 4
EP40_GLS
Module=EP40_GLS
Display=0
ParamCol0Width=20
ParamCol1Width=67
ParamCol2Width=67
ParamCol3Width=50
TraceCol0Width=20
TraceCol1Width=66
TraceCol2Width=104
ParamPositionColumn=0
ParamUnitColumn=1
ParamTypeColumn=0
ParamIdentifierColumn=0
ParamCommentColumn=0
ParamColumnCount=4
ParamNameColumnIndex=1
ParamValueColumnIndex=2
ParamUnitColumnIndex=3
UdsSuppressPosResp=0
StringParamPadding=1
Split1=336
Split2=187
AutoUpdateParams=0
ServiceDisplayStyle=0
ViewMode=0
ServiceShowIndex=1
ServiceShowRawPrefix=1
ServiceSortingType=0
DisplayParamPosLengthInTrace=0
ScriptPath=
DisplayAllParamsInTrace=0
MaxRequestHistory=10
RequestHistoryService_0=ExtendedDiagnosticSession_Start
RequestHistoryService_1=DefaultSession_Start
RequestHistoryService_2=ProgrammingSession_Start
RequestHistoryService_3=BootSWIdentifier_Read
DisplayPduInParameterList=1
IsTraceLogging=0
TraceLogfile=DiagConsoleLog.txt
TraceLogfileIndex=1
DIAGNOSE_CONTROL_END
End_Of_Object VDiagnoseBoxRoot 3
End_Of_Object VDiagnoseBox 2
VErrorMemoryBox 2 Begin_Of_Object
1
VDiagnoseBoxRoot 3 Begin_Of_Object
1
VBoxRoot 4 Begin_Of_Object
1
1
1 -1 0 1 -1 -1 -1 -1 255 126 1020 565
EP40_GLS - Fault Memory
1

MDI_DOCK_INFO_END
5
1
6
0 1 0 0 0 0 255 126 1020 506
6 0 0 0 0 0 0 0 0 0 0 0 0 0 0 0 0 0 0 0 0 0 0 -1 -1 32767 0 0 0 0 0 0 0 0 0 0 -1 -1 0 0 0 0 0 0 
END_OF_DOCK_INFO
0
-1
0
0
0
0 0
END_OF_DESKTOP_DATA
6
0 1 -1 -1 -1 -1 255 126 1020 565
6 0 0 0 0 0 0 0 0 0 0 0 0 0 0 0 0 0 0 0 0 0 0 -1 -1 32767 0 0 0 0 0 0 0 0 0 0 -1 -1 0 0 0 0 0 0 
END_OF_DOCK_INFO
0
-1
0
0
1
1275 632
END_OF_DESKTOP_DATA
6
0 1 0 0 0 0 255 126 1020 506
6 0 0 0 0 0 0 0 0 0 0 0 0 0 0 0 0 0 0 0 0 0 0 -1 -1 32767 0 0 0 0 0 0 0 0 0 0 -1 -1 0 0 0 0 0 0 
END_OF_DOCK_INFO
0
-1
0
0
0
0 0
END_OF_DESKTOP_DATA
END_OF_DESKTOP_DATA_COLLECTION
0
0 0
END_OF_DESKTOP_MEMBER
{983649FF-0270-4306-81F4-15672D182CA6}
0
End_Of_Object VBoxRoot 4
EP40_GLS
Message_0=<msg><semantic>DeleteSelected</semantic><default>1</default><customname></customname><qualifier>FaultMemory_Clear</qualifier><pdu>14 FF FF FF</pdu><params><param><qual>GroupOfDtc</qual><val></val></param></params></msg>
Message_1=<msg><semantic>DeleteAll</semantic><default>1</default><customname></customname><qualifier>FaultMemory_Clear</qualifier><pdu>14 FF FF FF</pdu><params><param><qual>GroupOfDtc</qual><val></val></param></params></msg>
Module=EP40_GLS
Display=1
OptionRequestValueType=1
DtcViewMode=0
ActiveDtcRequest=
DtcCol0Width=54
DtcColumnSize=171
StatusColumnSize=245
DetailsCol0Width=171
DetailsCol1Width=298
EnvDataCol0Width=224
ValueColumnSize=125
InvalidValueColumnSize=125
Logfile=FaultMemoryLog.txt
UpdateRate=60.000000
ShowEnvData=0
ShowSaeCode=0
CyclicUpdate=0
LogDTCs=0
LogfileIndex=1
FilterDTCText=
FilterStatusByte=
DTCFiltersActive=0
DtcDeltaLogging=0
FaultMemContinueOnError=0
ShowAllDtcEnv=0
DIAGNOSE_CONTROL_END
End_Of_Object VDiagnoseBoxRoot 3
End_Of_Object VErrorMemoryBox 2
VGBAnlyzBox 2 Begin_Of_Object
3
VGrMnBox 3 Begin_Of_Object
1
VUniqueBox 4 Begin_Of_Object
1
VBoxRoot 5 Begin_Of_Object
1
3
1 0 0 1 -1 -1 -1 -1 0 0 513 565

1

MDI_DOCK_INFO_END
5
1
6
0 1 -1 -1 -1 -1 22 22 910 567
6 0 0 0 0 0 0 0 0 0 0 0 0 0 0 0 0 0 0 0 0 0 0 -1 -1 32767 0 0 0 0 0 0 0 0 0 0 0 0 0 0 0 0 0 0 
END_OF_DOCK_INFO
0
0
0
0
1
948 598
END_OF_DESKTOP_DATA
6
0 1 -1 -1 -1 -1 0 0 513 565
6 0 0 0 0 0 0 0 0 0 0 0 0 0 0 0 0 0 0 0 0 0 0 -1 -1 32767 0 0 0 0 0 0 0 0 0 0 0 0 0 0 0 0 0 0 
END_OF_DOCK_INFO
1
0
0
0
1
1275 632
END_OF_DESKTOP_DATA
6
0 1 -1 -1 -1 -1 0 0 394 420
6 0 0 0 0 0 0 0 0 0 0 0 0 0 0 0 0 0 0 0 0 0 0 -1 -1 32767 0 0 0 0 0 0 0 0 0 0 0 0 0 0 0 0 0 0 
END_OF_DOCK_INFO
0
0
0
0
1
1001 592
END_OF_DESKTOP_DATA
END_OF_DESKTOP_DATA_COLLECTION
0
0 1
1
6
0 0 0 0 0 0 283 291 853 654
6 0 0 0 0 0 0 0 0 0 0 0 0 0 0 0 0 0 0 0 0 0 0 -1 -1 32767 0 0 0 0 0 0 0 0 0 0 0 0 0 0 0 0 0 0 
END_OF_DOCK_INFO
0
-1
0
0
0
0 0
END_OF_DESKTOP_DATA
6
0 1 -1 -1 -1 -1 0 0 512 373
6 0 0 0 0 0 0 0 0 0 0 0 0 0 0 0 0 0 0 0 0 0 0 -1 -1 32767 0 0 0 0 0 0 0 0 0 0 -1 -1 0 0 0 0 0 0 
END_OF_DOCK_INFO
0
3
0
0
0
0 0
END_OF_DESKTOP_DATA
6
0 1 -1 -1 -1 -1 0 0 512 373
6 0 0 0 0 0 0 0 0 0 0 0 0 0 0 0 0 0 0 0 0 0 0 -1 -1 32767 0 0 0 0 0 0 0 0 0 0 -1 -1 0 0 0 0 0 0 
END_OF_DOCK_INFO
0
3
0
0
0
0 0
END_OF_DESKTOP_DATA
END_OF_DESKTOP_DATA_COLLECTION
0
END_OF_DESKTOP_MEMBER
{79EB2B7B-3AC3-4200-A21D-060730E2CF13}
0
End_Of_Object VBoxRoot 5
1 -1 0 0 0 0 0 0 0 0 0 0
End_Of_Object VUniqueBox 4
End_Of_Object VGrMnBox 3
VDOLocalInfoStruct 3 Begin_Of_Object
4
1
75
VDAOGBFunctionBlock 4 Begin_Of_Object
1
1
0
TABPredecessor:
0
TABSuccessor:
2
VPlugConf 5 Begin_Of_Object
1
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
0
End_Of_Object VBoxRoot 21
1 -1 0 0 0 0 0 0 0 0 0 0
End_Of_Object VUniqueBox 20
0
0
End_Of_Object VNETControlBox 19
End_Of_Object VNETTraceControlBox 18
End_Of_Object VTraceConfiguration 17
VDOLine 17 Begin_Of_Object
1
63
0
130 0
NULL
End_Of_Object VDOLine 17

EndOfComment
0
1
End_Of_Object VDAOGBFunctionBlock 16
End_Of_Object VDODynamicLine 15
End_Of_Object VDAOGBHSStd 14
NULL
End_Of_Object VDORefinement 13
VDORefinement 13 Begin_Of_Object
1
64
0
5
VDAOGBHSStd 14 Begin_Of_Object
1
65
0
0 0
TABPredecessor:
62
TABSuccessor:
67
VDODynamicLine 15 Begin_Of_Object
1
66
0
0
VDAOGBFunctionBlock 16 Begin_Of_Object
1
67
0
TABPredecessor:
65
TABSuccessor:
70
VGraphBoxConf 17 Begin_Of_Object
1
VNETGraphBox 18 Begin_Of_Object
1
VNETControlBox 19 Begin_Of_Object
2
VUniqueBox 20 Begin_Of_Object
1
VBoxRoot 21 Begin_Of_Object
1
1
0 3 0 1 -1 -1 -1 -1 502 1 1000 293
Graphics
1

MDI_DOCK_INFO_END
5
1
6
0 1 0 0 -1 -1 200 118 801 474
6 0 0 0 0 0 0 0 0 0 0 0 0 0 0 0 0 0 0 0 0 0 0 -1 -1 32767 0 0 0 0 0 0 0 0 0 0 -1 -1 0 0 0 0 0 0 
END_OF_DOCK_INFO
0
3
0
0
0
0 0
END_OF_DESKTOP_DATA
6
0 1 -1 -1 -1 -1 200 118 801 474
6 0 0 0 0 0 0 0 0 0 0 0 0 0 0 0 0 0 0 0 0 0 0 -1 -1 32767 0 0 0 0 0 0 0 0 0 0 -1 -1 0 0 0 0 0 0 
END_OF_DOCK_INFO
0
3
0
0
1
1001 591
END_OF_DESKTOP_DATA
6
0 1 -1 -1 -1 -1 502 1 1000 293
6 0 0 0 0 0 0 0 0 0 0 0 0 0 0 0 0 0 0 0 0 0 0 -1 -1 32767 0 0 0 0 0 0 0 0 0 0 -1 -1 0 0 0 0 0 0 
END_OF_DOCK_INFO
1
3
0
0
1
1275 837
END_OF_DESKTOP_DATA
END_OF_DESKTOP_DATA_COLLECTION
0
0 1
1
6
0 1 0 0 -1 -1 200 118 801 474
6 0 0 0 0 0 0 0 0 0 0 0 0 0 0 0 0 0 0 0 0 0 0 -1 -1 32767 0 0 0 0 0 0 0 0 0 0 -1 -1 0 0 0 0 0 0 
END_OF_DOCK_INFO
1
3
0
0
0
0 0
END_OF_DESKTOP_DATA
6
0 1 0 0 -1 -1 200 118 801 474
6 0 0 0 0 0 0 0 0 0 0 0 0 0 0 0 0 0 0 0 0 0 0 -1 -1 32767 0 0 0 0 0 0 0 0 0 0 -1 -1 0 0 0 0 0 0 
END_OF_DOCK_INFO
1
3
0
0
0
0 0
END_OF_DESKTOP_DATA
6
0 1 0 0 -1 -1 200 118 801 474
6 0 0 0 0 0 0 0 0 0 0 0 0 0 0 0 0 0 0 0 0 0 0 -1 -1 32767 0 0 0 0 0 0 0 0 0 0 -1 -1 0 0 0 0 0 0 
END_OF_DOCK_INFO
1
3
0
0
0
0 0
END_OF_DESKTOP_DATA
END_OF_DESKTOP_DATA_COLLECTION
0
END_OF_DESKTOP_MEMBER
{E69ABCBE-909B-44F9-8C45-8F6A3F921D93}
0
End_Of_Object VBoxRoot 21
1 -1 0 0 0 0 0 0 0 0 0 0
End_Of_Object VUniqueBox 20
1
1 -1 0 0 0 0 0 0 0 0 0 0
0
End_Of_Object VNETControlBox 19
End_Of_Object VNETGraphBox 18
81
APPDIR Vector.CANalyzer.Graphic.DLL
Vector.CANalyzer.Graphic, Version=11.0.81.0, Culture=neutral, PublicKeyToken=null
Vector.CANalyzer.Graphic.ComponentWrapper
1
1
APPDIR CANw_Net.DLL
CANw_Net, Version=11.0.81.0, Culture=neutral, PublicKeyToken=null
Vector.CANalyzer.ApplicationSerializer
2
Application
2
Boolean
Expanded
True
Int32
SplitterWidth
184
Int32
SplitterHeight
80
APPDIR Vector.CANalyzer.Graphic.DLL
Vector.CANalyzer.Graphic, Version=11.0.81.0, Culture=neutral, PublicKeyToken=null
Vector.CANalyzer.Graphic.Position
3
LegendPosition
3
Int32
value__
0
--TextFormatter: End of Object--
APPDIR Vector.CANalyzer.Graphic.DLL
Vector.CANalyzer.Graphic, Version=11.0.81.0, Culture=neutral, PublicKeyToken=null
Vector.CANalyzer.Graphic.GraphicCommandID
4
ScrollSignalsButton1Command
4
Int32
value__
29
--TextFormatter: End of Object--
TypeRef:4
ScrollSignalsButton2Command
5
Int32
value__
30
--TextFormatter: End of Object--
TypeRef:4
ScrollButton1Command
6
Int32
value__
35
--TextFormatter: End of Object--
TypeRef:4
ScrollButton2Command
7
Int32
value__
36
--TextFormatter: End of Object--
APPDIR Components\Vector.CANalyzer.Serialization\1.5.0.0\Vector.CANalyzer.Serialization.dll
Vector.CANalyzer.Serialization, Version=1.5.0.0, Culture=neutral, PublicKeyToken=b273882a063429a6
Vector.CANalyzer.Serialization.SerializationVersion
5
SerializationVersion
8
UInt16
mMajor
1
UInt16
mMinor
0
UInt16
mPatch
0
--TextFormatter: End of Object--
--TextFormatter: End of Object--
TypeRef:2
2
--TextFormatter: End of Object--
VSignalObjectStreamer 18 Begin_Of_Object
1
0
[GraphWindow:x_x_x_x_x_x_WindowBk_Grid_AxisBk_XAxisFr_YAxisFr_x_x_x_x_x_x]
0 100000 100000 200000 576000000 1 ffffff b2b2b2 ffffff 0 0 0 0 1 1 1 0
0 30 5000
0
0 100
0
16777215
0
2
0
1
41943040
-1
VLogExportPersister 19 Begin_Of_Object
7
1416
25200253
Graphics Window
<VFileName V7 QL> 1 "" 
<VFileName V7 QL> 1 "" 
0
2
1
::
,
.

0
2
0
0.10000000000000001
6
1
3
2
19
0.10000000000000001
1
0
0
0
0

0
0
0
0
730
0
0.10000000000000001
0
0
1
End_Of_Object VLogExportPersister 19
12
20 25 110 20 18 55 55 55 55 55 57 13 
184
0
0
1
134
0
0
-11
0
0
0
0
0
0
0
400
0
SimSun
0
1
134
0
0
-11
0
0
0
34
0
0
0
400
0
SimSun
0
1
1
0
0
11711154
32768
0
0
0
0
0
0
0
0
0
164
0 10
1
0
0
VLogCfgData 19 Begin_Of_Object
11
0
0
0
0
0
0
0
0
1024
60
0
0
0
3
0
6
1
1
0
2
0
0
19
VLogExportPersister 20 Begin_Of_Object
7
1416
11060201
<VFileName V7 QL> 1 "" 
<VFileName V7 QL> 1 "" 
<VFileName V7 QL> 1 "" 
0
2
1
::
,
.

0
2
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
End_Of_Object VDOLine 12
End_Of_Object VDODynamicLine 11
End_Of_Object VDODynamicLine 10
End_Of_Object VDODynamicLine 9
End_Of_Object VDAOGBHSStd 8
End_Of_Object VDODynamicLine 7
4
End_Of_Object VDOCrossing 6

EndOfComment
0
1
End_Of_Object VDAOGBFunctionBlock 5

EndOfComment
1
1
End_Of_Object VDAOGBFunctionBlock 4
VDAOGBFunctionBlock 4 Begin_Of_Object
1
44
0
TABPredecessor:
0
TABSuccessor:
45
VOfflineSrcConfiguration 5 Begin_Of_Object
3
VMigratedGenericConfiguration<struct_VOfflineCfgData> 6 Begin_Of_Object
1
VOfflineCfgData 7 Begin_Of_Object
2
VReplayCfgBase 8 Begin_Of_Object
1
0
1
End_Of_Object VReplayCfgBase 8
VCfgBreakCondition 8 Begin_Of_Object
1
VDataBreakCondition 9 Begin_Of_Object
1
0
VEvCondBlock 10 Begin_Of_Object
1
VEvCondGroup 11 Begin_Of_Object
2
VEvCondPrimitive 12 Begin_Of_Object
1
1
End_Of_Object VEvCondPrimitive 12
1
0
0
End_Of_Object VEvCondGroup 11
End_Of_Object VEvCondBlock 10
End_Of_Object VDataBreakCondition 9
End_Of_Object VCfgBreakCondition 8
0
0
0
0
0
0
End_Of_Object VOfflineCfgData 7
End_Of_Object VMigratedGenericConfiguration<struct_VOfflineCfgData> 6
VChannelMapping 6 Begin_Of_Object
1
0
End_Of_Object VChannelMapping 6
End_Of_Object VOfflineSrcConfiguration 5
NULL

EndOfComment
1
1
End_Of_Object VDAOGBFunctionBlock 4
0
End_Of_Object VDOLocalInfoStruct 3
67305472
0
0
2
VDOLocalInfoStruct 3 Begin_Of_Object
End_Of_Object VDOLocalInfoStruct 3
End_Of_Serialized_Data 2
0.000000
0 0
End_Of_Object VGBAnlyzBox 2
VGBRealTimeBox 2 Begin_Of_Object
1
VGrMnBox 3 Begin_Of_Object
1
VUniqueBox 4 Begin_Of_Object
1
VBoxRoot 5 Begin_Of_Object
1
3
1 1 0 1 -1 -1 -1 -1 467 1 1275 565

1

MDI_DOCK_INFO_END
5
1
6
0 1 -1 -1 -1 -1 0 0 437 387
6 0 0 0 0 0 0 0 0 0 0 0 0 0 0 0 0 0 0 0 0 0 0 -1 -1 32767 0 0 0 0 0 0 0 0 0 0 0 0 0 0 0 0 0 0 
END_OF_DOCK_INFO
0
1
0
0
1
1007 387
END_OF_DESKTOP_DATA
6
0 1 -1 -1 -1 -1 467 1 1275 565
6 0 0 0 0 0 0 0 0 0 0 0 0 0 0 0 0 0 0 0 0 0 0 -1 -1 32767 0 0 0 0 0 0 0 0 0 0 0 0 0 0 0 0 0 0 
END_OF_DOCK_INFO
1
1
0
0
1
1275 632
END_OF_DESKTOP_DATA
6
0 1 -1 -1 -1 -1 44 44 932 589
6 0 0 0 0 0 0 0 0 0 0 0 0 0 0 0 0 0 0 0 0 0 0 -1 -1 32767 0 0 0 0 0 0 0 0 0 0 -1 -1 0 0 0 0 0 0 
END_OF_DOCK_INFO
0
2
0
0
0
0 0
END_OF_DESKTOP_DATA
END_OF_DESKTOP_DATA_COLLECTION
0
0 1
1
6
0 0 0 0 0 0 283 291 853 654
6 0 0 0 0 0 0 0 0 0 0 0 0 0 0 0 0 0 0 0 0 0 0 -1 -1 32767 0 0 0 0 0 0 0 0 0 0 0 0 0 0 0 0 0 0 
END_OF_DOCK_INFO
0
-1
0
0
0
0 0
END_OF_DESKTOP_DATA
6
0 1 -1 -1 -1 -1 515 1 1019 374
6 0 0 0 0 0 0 0 0 0 0 0 0 0 0 0 0 0 0 0 0 0 0 -1 -1 32767 0 0 0 0 0 0 0 0 0 0 -1 -1 0 0 0 0 0 0 
END_OF_DOCK_INFO
0
0
0
0
0
0 0
END_OF_DESKTOP_DATA
6
0 1 -1 -1 -1 -1 515 1 1019 374
6 0 0 0 0 0 0 0 0 0 0 0 0 0 0 0 0 0 0 0 0 0 0 -1 -1 32767 0 0 0 0 0 0 0 0 0 0 -1 -1 0 0 0 0 0 0 
END_OF_DOCK_INFO
0
0
0
0
0
0 0
END_OF_DESKTOP_DATA
END_OF_DESKTOP_DATA_COLLECTION
0
END_OF_DESKTOP_MEMBER
{EA785C8F-7A62-4AEE-B713-4D5E2CA3B8E3}
0
End_Of_Object VBoxRoot 5
1 -1 0 0 0 0 0 0 0 0 0 0
End_Of_Object VUniqueBox 4
End_Of_Object VGrMnBox 3
VDOLocalInfoStruct 3 Begin_Of_Object
4
1
66
VDAOBus 4 Begin_Of_Object
1
1
5
VDAOGBFunctionBlock 5 Begin_Of_Object
1
57
3
TABPredecessor:
1
TABSuccessor:
58
VSimulationNode 6 Begin_Of_Object
4
VProgrammedNode 7 Begin_Of_Object
6
VConfigurationRoot 8 Begin_Of_Object
1
End_Of_Object VConfigurationRoot 8
<VFileName V7 QL> 1 "..\..\..\..\..\..\circlelamp\" 
1
C:\Users\Public\Documents\Vector\CANoe\11.0 (x64)\Templates\CANoe
BDCS
EP40_BDCS_LIN2_Matrix_V21_Releas
5
ECU 1
ECU 1
EOF_TITLE_INFO

1
0
1
1
0
1
0
1 0 9 0 
SS_BEGIN_COMMON_INFO
1
4
Behavior
1
Buses
1
Misc
1
Timing
1
SS_END_COMMON_INFO

EOF_MBSSDATA
1
0 1
0
EOF_NLDATA
0
EOF_ASSEMBLYDATA
<VFileName V7 QL> 1 "C:\Users\Public\Documents\Vector\CANoe\11.0 (x64)\Templates\CANoe" 
VIPBStackSetting 8 Begin_Of_Object
6
2
0
0
1
0
1
8
0.0.0.0
End_Of_Serialized_Data 8
8
::
End_Of_Serialized_Data 8
1
End_Of_Object VIPBStackSetting 8
7
NULL
End_Of_Serialized_Data 7
0
<VFileName V7 QL> 0 "" 
1
0
End_Of_Object VProgrammedNode 7
0
0
Startdelay 0 0 0
Jitter 0 0 1 0 0 0 0
0
EOF_NLDATA
3
VSimulinkModelViewerConfiguration 7 Begin_Of_Object
2
<VFileName V7 QL> 1 "..\..\..\..\..\..\circlelamp\" 
<VFileName V7 QL> 1 "..\..\..\..\..\..\circlelamp\" 
<VFileName V7 QL> 1 "..\..\..\..\..\..\circlelamp\" 
150
0
End_Of_Object VSimulinkModelViewerConfiguration 7
1
0
0
0
NodeSignalPanelBustypeCount 1
LIN
NodeSignalPanelCount 1
VNETStandaloneComponent 7 Begin_Of_Object
1
VNETControlBox 8 Begin_Of_Object
2
VUniqueBox 9 Begin_Of_Object
1
VBoxRoot 10 Begin_Of_Object
1
3
1 2 0 1 -1 -1 -1 -1 960 282 1920 564
Node Panel - LIN - BDCS
1

MDI_DOCK_INFO_END
5
1
6
0 1 -1 -1 -1 -1 960 282 1920 564
6 0 0 0 0 0 0 0 0 0 0 0 0 0 0 0 0 0 0 0 0 0 0 -1 -1 32767 0 0 0 0 0 0 0 0 0 0 -1 -1 0 0 0 0 0 0 
END_OF_DOCK_INFO
1
2
0
0
1
1920 848
END_OF_DESKTOP_DATA
6
0 1 -1 -1 -1 -1 255 126 690 523
6 0 0 0 0 0 0 0 0 0 0 0 0 0 0 0 0 0 0 0 0 0 0 -1 -1 32767 0 0 0 0 0 0 0 0 0 0 -1 -1 0 0 0 0 0 0 
END_OF_DOCK_INFO
0
2
0
0
0
1275 632
END_OF_DESKTOP_DATA
6
0 1 0 0 0 0 255 126 1020 506
6 0 0 0 0 0 0 0 0 0 0 0 0 0 0 0 0 0 0 0 0 0 0 -1 -1 32767 0 0 0 0 0 0 0 0 0 0 -1 -1 0 0 0 0 0 0 
END_OF_DOCK_INFO
0
-1
0
0
0
0 0
END_OF_DESKTOP_DATA
END_OF_DESKTOP_DATA_COLLECTION
0
0 1
1
6
0 1 0 0 0 0 255 126 1020 506
6 0 0 0 0 0 0 0 0 0 0 0 0 0 0 0 0 0 0 0 0 0 0 -1 -1 32767 0 0 0 0 0 0 0 0 0 0 -1 -1 0 0 0 0 0 0 
END_OF_DOCK_INFO
0
-1
0
0
0
0 0
END_OF_DESKTOP_DATA
6
0 1 0 0 0 0 255 126 1020 506
6 0 0 0 0 0 0 0 0 0 0 0 0 0 0 0 0 0 0 0 0 0 0 -1 -1 32767 0 0 0 0 0 0 0 0 0 0 -1 -1 0 0 0 0 0 0 
END_OF_DOCK_INFO
0
-1
0
0
0
0 0
END_OF_DESKTOP_DATA
6
0 1 0 0 0 0 255 126 1020 506
6 0 0 0 0 0 0 0 0 0 0 0 0 0 0 0 0 0 0 0 0 0 0 -1 -1 32767 0 0 0 0 0 0 0 0 0 0 -1 -1 0 0 0 0 0 0 
END_OF_DOCK_INFO
0
-1
0
0
0
0 0
END_OF_DESKTOP_DATA
END_OF_DESKTOP_DATA_COLLECTION
0
END_OF_DESKTOP_MEMBER
{4BE78B39-0265-4DE5-B7A9-827E3E04165F}
0
End_Of_Object VBoxRoot 10
1 -1 0 0 0 0 0 0 0 0 0 0
End_Of_Object VUniqueBox 9
1
1 -1 0 0 0 0 0 0 0 0 0 0
0
End_Of_Object VNETControlBox 8
481
APPDIR Vector.CANoe.NodeSignalPanel.DLL
Vector.CANoe.NodeSignalPanel, Version=11.0.81.0, Culture=neutral, PublicKeyToken=null
Vector.CANoe.NodeSignalPanel.VMainApplication
1
1
Int32
AppChannel
1
String
DatabaseName
1
EP40_BDCS_LIN2_Matrix_V21_Releas
String
TxECUName
1
BDCS
Boolean
BusContext
False
Int32
BusType
3
APPDIR CANw_Net.DLL
CANw_Net, Version=11.0.81.0, Culture=neutral, PublicKeyToken=null
Vector.CANalyzer.ApplicationSerializer
2
Application
2
APPDIR Vector.CANoe.NodeSignalPanel.DLL
Vector.CANoe.NodeSignalPanel, Version=11.0.81.0, Culture=neutral, PublicKeyToken=null
Vector.CANoe.NodeSignalPanel.VMainView
3
MainView
3
APPDIR Components\Vector.CANalyzer.Serialization\1.5.0.0\Vector.CANalyzer.Serialization.dll
Vector.CANalyzer.Serialization, Version=1.5.0.0, Culture=neutral, PublicKeyToken=b273882a063429a6
Vector.CANalyzer.Serialization.SerializationVersion
4
SerializationVersion
4
UInt16
mMajor
1
UInt16
mMinor
0
UInt16
mPatch
1
--TextFormatter: End of Object--
--TextFormatter: End of Object--
TypeRef:2
2
--TextFormatter: End of Object--
TypeRef:3
3
APPDIR Vector.CANoe.NodeSignalPanel.DLL
Vector.CANoe.NodeSignalPanel, Version=11.0.81.0, Culture=neutral, PublicKeyToken=null
Vector.CANoe.NodeSignalPanel.VSignalView
5
SignalView
5
APPDIR Vector.CANoe.NodeSignalPanel.DLL
Vector.CANoe.NodeSignalPanel, Version=11.0.81.0, Culture=neutral, PublicKeyToken=null
Vector.CANoe.NodeSignalPanel.VMessageView
6
MessageView
6
APPDIR Vector.CANoe.NodeSignalPanel.DLL
Vector.CANoe.NodeSignalPanel, Version=11.0.81.0, Culture=neutral, PublicKeyToken=null
Vector.CANoe.NodeSignalPanel.VRxNodeView
7
RxNodeView
7
Int32
SelectedView
0
TypeRef:4
SerializationVersion
8
UInt16
mMajor
1
UInt16
mMinor
0
UInt16
mPatch
1
--TextFormatter: End of Object--
--TextFormatter: End of Object--
TypeRef:5
5
Int32
Grouping
0
Boolean
SignalColumn_Visible
True
Boolean
MuxColumn_Visible
False
Boolean
SubframeColumn_Visible
False
Boolean
PhysColumn_Visible
True
Boolean
RawColumn_Visible
True
Boolean
MessageColumn_Visible
False
Boolean
UnitColumn_Visible
False
Boolean
RxNodeColumn_Visible
False
Boolean
TxNodeColumn_Visible
False
Boolean
SymbolicValueColumn_Visible
True
Boolean
TxAckColumn_Visible
False
Boolean
SigLenColumn_Visible
False
Int32
SignalColumn_VisibleIndex
0
Int32
MuxColumn_VisibleIndex
-1
Int32
SubframeColumn_VisibleIndex
-1
Int32
PhysColumn_VisibleIndex
1
Int32
RawColumn_VisibleIndex
2
Int32
MessageColumn_VisibleIndex
-1
Int32
UnitColumn_VisibleIndex
-1
Int32
RxNodeColumn_VisibleIndex
-1
Int32
TxNodeColumn_VisibleIndex
-1
Int32
SymbolicValueColumn_VisibleIndex
3
Int32
TxAckColumn_VisibleIndex
-1
Int32
SigLenColumn_VisibleIndex
-1
Int32
SignalColumn_Width
115
Int32
MuxColumn_Width
75
Int32
SubframeColumn_Width
75
Int32
PhysColumn_Width
100
Int32
RawColumn_Width
100
Int32
MessageColumn_Width
163
Int32
UnitColumn_Width
75
Int32
RxNodeColumn_Width
168
Int32
TxNodeColumn_Width
168
Int32
SymbolicValueColumn_Width
100
Int32
TxAckColumn_Width
25
Int32
SigLenColumn_Width
75
TypeRef:4
SerializationVersion
9
UInt16
mMajor
1
UInt16
mMinor
0
UInt16
mPatch
2
--TextFormatter: End of Object--
--TextFormatter: End of Object--
TypeRef:6
6
Int32
Grouping
0
Boolean
MessageColumn_Visible
True
Boolean
RxNodeColumn_Visible
False
Boolean
TxNodeColumn_Visible
False
Boolean
ButtonColumn_Visible
True
Boolean
SignalColumn_Visible
True
Boolean
MuxColumn_Visible
False
Boolean
SubframeColumn_Visible
False
Boolean
PhysColumn_Visible
True
Boolean
RawColumn_Visible
True
Boolean
UnitColumn_Visible
False
Boolean
SymbolicValueColumn_Visible
True
Boolean
TxAckColumn_Visible
False
Boolean
SigLenColumn_Visible
False
Int32
MessageColumn_VisibleIndex
0
Int32
RxNodeColumn_VisibleIndex
-1
Int32
TxNodeColumn_VisibleIndex
-1
Int32
ButtonColumn_VisibleIndex
1
Int32
SignalColumn_VisibleIndex
0
Int32
MuxColumn_VisibleIndex
-1
Int32
SubframeColumn_VisibleIndex
-1
Int32
PhysColumn_VisibleIndex
1
Int32
RawColumn_VisibleIndex
2
Int32
UnitColumn_VisibleIndex
-1
Int32
SymbolicValueColumn_VisibleIndex
3
Int32
TxAckColumn_VisibleIndex
-1
Int32
SigLenColumn_VisibleIndex
-1
Int32
MessageColumn_Width
861
Int32
RxNodeColumn_Width
432
Int32
TxNodeColumn_Width
164
Int32
ButtonColumn_Width
64
Int32
SignalColumn_Width
75
Int32
MuxColumn_Width
75
Int32
SubframeColumn_Width
75
Int32
PhysColumn_Width
75
Int32
RawColumn_Width
75
Int32
UnitColumn_Width
75
Int32
SymbolicValueColumn_Width
664
Int32
TxAckColumn_Width
25
Int32
SigLenColumn_Width
75
TypeRef:4
SerializationVersion
10
UInt16
mMajor
1
UInt16
mMinor
0
UInt16
mPatch
2
--TextFormatter: End of Object--
--TextFormatter: End of Object--
TypeRef:7
7
Int32
Grouping
0
Boolean
RxNodeColumn_Visible
True
Boolean
SignalColumn_Visible
True
Boolean
MuxColumn_Visible
False
Boolean
SubframeColumn_Visible
False
Boolean
PhysColumn_Visible
True
Boolean
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
2
<VFileName V7 QL> 1 "..\..\..\..\..\..\circlelamp\" 
<VFileName V7 QL> 1 "..\..\..\..\..\..\circlelamp\" 
<VFileName V7 QL> 1 "..\..\..\..\..\..\circlelamp\" 
150
0
End_Of_Object VSimulinkModelViewerConfiguration 7
1
0
0
0
NodeSignalPanelBustypeCount 0
0
End_Of_Object VSimulationNode 6
NULL

EndOfComment
0
1
End_Of_Object VDAOGBFunctionBlock 5
VDAOGBFunctionBlock 5 Begin_Of_Object
1
66
3
TABPredecessor:
65
TABSuccessor:
2
VLINInteractiveSchedulerConfiguration 6 Begin_Of_Object
1
VMigratedGenericConfiguration<class_VLINInteractiveSchedulerData> 7 Begin_Of_Object
1
VLINInteractiveSchedulerData 8 Begin_Of_Object
1
1
End_Of_Object VLINInteractiveSchedulerData 8
End_Of_Object VMigratedGenericConfiguration<class_VLINInteractiveSchedulerData> 7
3
LIN ISC
BOF_MBSSDATA
1 0 0 0 
SS_BEGIN_COMMON_INFO
1
3
Behavior
1
Buses
1
Misc
1
SS_END_COMMON_INFO

EOF_MBSSDATA
1
0 1
VNETStandaloneComponent 7 Begin_Of_Object
1
VNETControlBox 8 Begin_Of_Object
2
VUniqueBox 9 Begin_Of_Object
1
VBoxRoot 10 Begin_Of_Object
1
3
1 2 0 1 -1 -1 -1 -1 263 93 1241 622
LIN ISC
1

MDI_DOCK_INFO_END
5
1
6
0 1 -1 -1 -1 -1 263 93 1241 622
6 0 0 0 0 0 0 0 0 0 0 0 0 0 0 0 0 0 0 0 0 0 0 -1 -1 32767 0 0 0 0 0 0 0 0 0 0 -1 -1 0 0 0 0 0 0 
END_OF_DOCK_INFO
0
2
0
0
1
1275 837
END_OF_DESKTOP_DATA
6
0 1 0 0 0 0 255 126 1020 506
6 0 0 0 0 0 0 0 0 0 0 0 0 0 0 0 0 0 0 0 0 0 0 -1 -1 32767 0 0 0 0 0 0 0 0 0 0 -1 -1 0 0 0 0 0 0 
END_OF_DOCK_INFO
0
2
0
0
0
0 0
END_OF_DESKTOP_DATA
6
0 1 0 0 0 0 255 126 1020 506
6 0 0 0 0 0 0 0 0 0 0 0 0 0 0 0 0 0 0 0 0 0 0 -1 -1 32767 0 0 0 0 0 0 0 0 0 0 -1 -1 0 0 0 0 0 0 
END_OF_DOCK_INFO
0
2
0
0
0
0 0
END_OF_DESKTOP_DATA
END_OF_DESKTOP_DATA_COLLECTION
0
0 1
1
6
0 1 0 0 0 0 255 126 1020 506
6 0 0 0 0 0 0 0 0 0 0 0 0 0 0 0 0 0 0 0 0 0 0 -1 -1 32767 0 0 0 0 0 0 0 0 0 0 -1 -1 0 0 0 0 0 0 
END_OF_DOCK_INFO
0
-1
0
0
0
0 0
END_OF_DESKTOP_DATA
6
0 1 0 0 0 0 255 126 1020 506
6 0 0 0 0 0 0 0 0 0 0 0 0 0 0 0 0 0 0 0 0 0 0 -1 -1 32767 0 0 0 0 0 0 0 0 0 0 -1 -1 0 0 0 0 0 0 
END_OF_DOCK_INFO
0
-1
0
0
0
0 0
END_OF_DESKTOP_DATA
6
0 1 0 0 0 0 255 126 1020 506
6 0 0 0 0 0 0 0 0 0 0 0 0 0 0 0 0 0 0 0 0 0 0 -1 -1 32767 0 0 0 0 0 0 0 0 0 0 -1 -1 0 0 0 0 0 0 
END_OF_DOCK_INFO
0
-1
0
0
0
0 0
END_OF_DESKTOP_DATA
END_OF_DESKTOP_DATA_COLLECTION
0
END_OF_DESKTOP_MEMBER
{FA447D69-4703-4DE2-A3A4-0BCFAF95BB2B}
0
End_Of_Object VBoxRoot 10
1 -1 0 0 0 0 0 0 0 0 0 0
End_Of_Object VUniqueBox 9
1
1 -1 0 0 0 0 0 0 0 0 0 0
0
End_Of_Object VNETControlBox 8
3416
APPDIR Vector.CANalyzer.LIN.InteractiveScheduler.DLL
Vector.CANalyzer.LIN.InteractiveScheduler, Version=11.0.81.0, Culture=neutral, PublicKeyToken=null
Vector.CANalyzer.LIN.InteractiveScheduler.Controller.CANwinGateway
1
1
APPDIR Vector.CANalyzer.LIN.InteractiveScheduler.DLL
Vector.CANalyzer.LIN.InteractiveScheduler, Version=11.0.81.0, Culture=neutral, PublicKeyToken=null
Vector.CANalyzer.LIN.InteractiveScheduler.Controller.InteractiveSchedulerController
2
Controller
2
APPDIR Components\Vector.CANalyzer.Serialization\1.5.0.0\Vector.CANalyzer.Serialization.dll
Vector.CANalyzer.Serialization, Version=1.5.0.0, Culture=neutral, PublicKeyToken=b273882a063429a6
Vector.CANalyzer.Serialization.SerializationVersion
3
SerializationVersion
3
UInt16
mMajor
1
UInt16
mMinor
0
UInt16
mPatch
0
--TextFormatter: End of Object--
--TextFormatter: End of Object--
TypeRef:2
2
APPDIR CANw_Net.DLL
CANw_Net, Version=11.0.81.0, Culture=neutral, PublicKeyToken=null
Vector.CANalyzer.ApplicationSerializer
4
Application
4
APPDIR Vector.CANalyzer.LIN.InteractiveScheduler.DLL
Vector.CANalyzer.LIN.InteractiveScheduler, Version=11.0.81.0, Culture=neutral, PublicKeyToken=null
Vector.CANalyzer.LIN.InteractiveScheduler.Model.InteractiveSchedulerDataModel
5
Data
5
String
Guid
1
9ceb8a37-2ed0-46c1-a055-3b911807db92
Boolean
Collapsed
False
TypeRef:3
SerializationVersion
6
UInt16
mMajor
1
UInt16
mMinor
0
UInt16
mPatch
0
--TextFormatter: End of Object--
--TextFormatter: End of Object--
TypeRef:4
4
--TextFormatter: End of Object--
TypeRef:5
5
APPDIR Vector.CANalyzer.LIN.InteractiveScheduler.DLL
Vector.CANalyzer.LIN.InteractiveScheduler, Version=11.0.81.0, Culture=neutral, PublicKeyToken=null
Vector.CANalyzer.LIN.InteractiveScheduler.Model.View.ViewDataModel
6
ViewData
7
APPDIR Vector.CANalyzer.LIN.InteractiveScheduler.DLL
Vector.CANalyzer.LIN.InteractiveScheduler, Version=11.0.81.0, Culture=neutral, PublicKeyToken=null
Vector.CANalyzer.LIN.InteractiveScheduler.Model.Network.NetworkList
7
Networks
8
APPDIR Vector.CANalyzer.LIN.InteractiveScheduler.DLL
Vector.CANalyzer.LIN.InteractiveScheduler, Version=11.0.81.0, Culture=neutral, PublicKeyToken=null
Vector.CANalyzer.LIN.InteractiveScheduler.Model.Settings.SettingsDataModel
8
Settings
9
String
Guid
1
7dc57ace-139c-478c-9b15-023bfa78be53
Boolean
Collapsed
False
TypeRef:3
SerializationVersion
10
UInt16
mMajor
1
UInt16
mMinor
0
UInt16
mPatch
0
--TextFormatter: End of Object--
--TextFormatter: End of Object--
TypeRef:6
7
APPDIR Vector.CANalyzer.LIN.InteractiveScheduler.DLL
Vector.CANalyzer.LIN.InteractiveScheduler, Version=11.0.81.0, Culture=neutral, PublicKeyToken=null
Vector.CANalyzer.LIN.InteractiveScheduler.Model.View.SplitterSettings
9
MainViewLeftSplitterSettings
11
TypeRef:9
MainViewRightSplitterSettings
12
TypeRef:9
PropertyViewSplitterSettings
13
TypeRef:9
FramesSplitterSettings
14
APPDIR Vector.CANalyzer.LIN.InteractiveScheduler.DLL
Vector.CANalyzer.LIN.InteractiveScheduler, Version=11.0.81.0, Culture=neutral, PublicKeyToken=null
Vector.CANalyzer.LIN.InteractiveScheduler.Model.View.TreeListSettings
10
NetworkTreeSettings
15
TypeRef:10
ScheduleTableTreeSettings
16
TypeRef:10
FramesTreeSettings
17
APPDIR Vector.CANalyzer.LIN.InteractiveScheduler.DLL
Vector.CANalyzer.LIN.InteractiveScheduler, Version=11.0.81.0, Culture=neutral, PublicKeyToken=null
Vector.CANalyzer.LIN.InteractiveScheduler.Model.View.PropertySelectionData
11
PropertySelection
18
String
Guid
1
6e29c860-a3f1-4922-92fa-bcf41dfacd33
Boolean
Collapsed
False
TypeRef:3
SerializationVersion
19
UInt16
mMajor
1
UInt16
mMinor
0
UInt16
mPatch
1
--TextFormatter: End of Object--
--TextFormatter: End of Object--
TypeRef:7
8
Int32
ElementCount
1
APPDIR Vector.CANalyzer.LIN.InteractiveScheduler.DLL
Vector.CANalyzer.LIN.InteractiveScheduler, Version=11.0.81.0, Culture=neutral, PublicKeyToken=null
Vector.CANalyzer.LIN.InteractiveScheduler.Model.Network.NetworkDataModel
12
Element_0
20
String
Guid
1
35c87fb2-829d-4e28-8b41-76df1753fc3e
Boolean
Collapsed
False
TypeRef:3
SerializationVersion
21
UInt16
mMajor
1
UInt16
mMinor
0
UInt16
mPatch
0
--TextFormatter: End of Object--
--TextFormatter: End of Object--
TypeRef:8
9
APPDIR Vector.CANalyzer.LIN.InteractiveScheduler.DLL
Vector.CANalyzer.LIN.InteractiveScheduler, Version=11.0.81.0, Culture=neutral, PublicKeyToken=null
Vector.CANalyzer.LIN.InteractiveScheduler.Model.Settings.CaplFilterSettings
13
CaplFilterSettings
22
String
Guid
1
2b2eef48-c8c0-479a-a0c5-707acb03fe5a
Boolean
Collapsed
False
TypeRef:3
SerializationVersion
23
UInt16
mMajor
1
UInt16
mMinor
0
UInt16
mPatch
0
--TextFormatter: End of Object--
--TextFormatter: End of Object--
TypeRef:9
11
Boolean
Expanded
True
Int32
Size
200
String
Guid
1
a170b211-4a4e-4bcc-89c3-a2944ef83ea8
Boolean
Collapsed
False
TypeRef:3
SerializationVersion
24
UInt16
mMajor
1
UInt16
mMinor
0
UInt16
mPatch
0
--TextFormatter: End of Object--
--TextFormatter: End of Object--
TypeRef:9
12
Boolean
Expanded
True
Int32
Size
200
String
Guid
1
06d3d7f7-a7e8-49e6-9129-313e826dec5b
Boolean
Collapsed
False
--TextFormatter: End of Object--
TypeRef:9
13
Boolean
Expanded
True
Int32
Size
200
String
Guid
1
8dd2f9c5-93a9-4ce0-8c6c-6531a57e92d8
Boolean
Collapsed
False
--TextFormatter: End of Object--
TypeRef:9
14
Boolean
Expanded
True
Int32
Size
200
String
Guid
1
4d86ee48-406c-4a8e-999c-26e0f2bcbf68
Boolean
Collapsed
False
--TextFormatter: End of Object--
TypeRef:10
15
String
SelectedElementGuid
1
79b51233-5300-4110-9da7-fd07bd6863f6
APPDIR Vector.CANalyzer.LIN.InteractiveScheduler.DLL
Vector.CANalyzer.LIN.InteractiveScheduler, Version=11.0.81.0, Culture=neutral, PublicKeyToken=null
Vector.CANalyzer.LIN.InteractiveScheduler.Model.View.TreeListColumnSettingsList
14
ColumnSettings
25
String
Guid
1
ba5d7a42-f1ac-4093-9866-f75839d702d6
Boolean
Collapsed
False
TypeRef:3
SerializationVersion
26
UInt16
mMajor
1
UInt16
mMinor
0
UInt16
mPatch
0
--TextFormatter: End of Object--
--TextFormatter: End of Object--
TypeRef:10
16
String
SelectedElementGuid
1
9c315a82-885a-44ea-8385-30ad548ef0d0
TypeRef:14
ColumnSettings
27
String
Guid
1
652d4f26-5d73-40a2-992a-ba46654a14ca
Boolean
Collapsed
False
--TextFormatter: End of Object--
TypeRef:10
17
String
SelectedElementGuid
1

TypeRef:14
ColumnSettings
28
String
Guid
1
93bc228a-3aff-46a2-8b0d-560b2fd0d72f
Boolean
Collapsed
False
--TextFormatter: End of Object--
TypeRef:11
18
String
UpperPropertyObjectGuid
1
9c315a82-885a-44ea-8385-30ad548ef0d0

mscorlib, Version=4.0.0.0, Culture=neutral, PublicKeyToken=b77a5c561934e089
System.Object
15
LowerPropertyObjectGuid
0
String
Guid
1
3a9dd70a-b213-4280-875a-d561fc524e9e
Boolean
Collapsed
False
TypeRef:3
SerializationVersion
29
UInt16
mMajor
1
UInt16
mMinor
0
UInt16
mPatch
0
--TextFormatter: End of Object--
--TextFormatter: End of Object--
TypeRef:12
20
Boolean
Active
True
String
Name
1
LIN
APPDIR Components\Vector.CANalyzer.BasicTypes\1.2.8.0\Vector.CANalyzer.BasicTypes.dll
Vector.CANalyzer.BasicTypes, Version=1.2.8.0, Culture=neutral, PublicKeyToken=b273882a063429a6
Vector.CANalyzer.ApplicationChannel
16
Channel
30
UInt32
mChannelNumber
1
APPDIR Components\Vector.CANalyzer.BasicTypes\1.2.8.0\Vector.CANalyzer.BasicTypes.dll
Vector.CANalyzer.BasicTypes, Version=1.2.8.0, Culture=neutral, PublicKeyToken=b273882a063429a6
Vector.CANalyzer.BusType
17
mBusType
31
Int32
value__
5
--TextFormatter: End of Object--
--TextFormatter: End of Object--
APPDIR Vector.CANalyzer.LIN.InteractiveScheduler.DLL
Vector.CANalyzer.LIN.InteractiveScheduler, Version=11.0.81.0, Culture=neutral, PublicKeyToken=null
Vector.CANalyzer.LIN.InteractiveScheduler.Model.Network.Interfaces.ProtocolVersion
18
ProtocolVersion
32
Int32
value__
5
--TextFormatter: End of Object--
APPDIR Vector.CANalyzer.LIN.InteractiveScheduler.DLL
Vector.CANalyzer.LIN.InteractiveScheduler, Version=11.0.81.0, Culture=neutral, PublicKeyToken=null
Vector.CANalyzer.LIN.InteractiveScheduler.Model.Network.WakeUpParametersDataModel
19
WakeUpParameters
33
APPDIR Vector.CANalyzer.LIN.InteractiveScheduler.DLL
Vector.CANalyzer.LIN.InteractiveScheduler, Version=11.0.81.0, Culture=neutral, PublicKeyToken=null
Vector.CANalyzer.LIN.InteractiveScheduler.Model.Network.NetworkStateDataModel
20
StartUpState
34
APPDIR Vector.CANalyzer.LIN.InteractiveScheduler.DLL
Vector.CANalyzer.LIN.InteractiveScheduler, Version=11.0.81.0, Culture=neutral, PublicKeyToken=null
Vector.CANalyzer.LIN.InteractiveScheduler.Model.Network.ScheduleTableList
21
ScheduleTables
35
Boolean
IsConnectedToDatabaseObject
True
String
Guid
1
79b51233-5300-4110-9da7-fd07bd6863f6
Boolean
Collapsed
False
TypeRef:3
SerializationVersion
36
UInt16
mMajor
1
UInt16
mMinor
0
UInt16
mPatch
1
--TextFormatter: End of Object--
--TextFormatter: End of Object--
TypeRef:13
22
Boolean
FilterCaplSchedulerCommands
True
Boolean
FilterCaplMasterCommands
True
String
Guid
1
0ef2bb4a-ef12-4db8-bc05-3b561062a581
Boolean
Collapsed
False
TypeRef:3
SerializationVersion
37
UInt16
mMajor
1
UInt16
mMinor
0
UInt16
mPatch
0
--TextFormatter: End of Object--
--TextFormatter: End of Object--
TypeRef:14
25
Int32
ElementCount
1
APPDIR Vector.CANalyzer.LIN.InteractiveScheduler.DLL
Vector.CANalyzer.LIN.InteractiveScheduler, Version=11.0.81.0, Culture=neutral, PublicKeyToken=null
Vector.CANalyzer.LIN.InteractiveScheduler.Model.View.TreeListColumnSettings
22
Element_0
38
String
Guid
1
3a6e9c7b-e012-433d-8352-aeb21bf132cb
Boolean
Collapsed
False
TypeRef:3
SerializationVersion
39
UInt16
mMajor
1
UInt16
mMinor
0
UInt16
mPatch
0
--TextFormatter: End of Object--
--TextFormatter: End of Object--
TypeRef:14
27
Int32
ElementCount
6
TypeRef:22
Element_0
40
TypeRef:22
Element_1
41
TypeRef:22
Element_2
42
TypeRef:22
Element_3
43
TypeRef:22
Element_4
44
TypeRef:22
Element_5
45
String
Guid
1
067297dc-9014-48d2-84ea-bdb4b5b0abfe
Boolean
Collapsed
False
--TextFormatter: End of Object--
TypeRef:14
28
Int32
ElementCount
7
TypeRef:22
Element_0
46
TypeRef:22
Element_1
47
TypeRef:22
Element_2
48
TypeRef:22
Element_3
49
TypeRef:22
Element_4
50
TypeRef:22
Element_5
51
TypeRef:22
Element_6
52
String
Guid
1
37c51bb8-9c6b-48d1-8836-07c6a936a032
Boolean
Collapsed
False
--TextFormatter: End of Object--
TypeRef:19
33
UInt16
Length
1000
Byte
RetransmissionCount
3
UInt16
RetransmissionDelay
150
String
Guid
1
975a5608-2ef0-405f-b124-c5006608cafd
Boolean
Collapsed
False
TypeRef:3
SerializationVersion
53
UInt16
mMajor
1
UInt16
mMinor
0
UInt16
mPatch
0
--TextFormatter: End of Object--
--TextFormatter: End of Object--
TypeRef:20
34
UInt32
Baudrate
19200
Double
SyncBreakLength
18
Double
SyncDelimiterLength
2
APPDIR Vector.CANalyzer.LIN.InteractiveScheduler.DLL
Vector.CANalyzer.LIN.InteractiveScheduler, Version=11.0.81.0, Culture=neutral, PublicKeyToken=null
Vector.CANalyzer.LIN.InteractiveScheduler.Model.Network.Interfaces.SleepState
23
SleepState
54
Int32
value__
0
--TextFormatter: End of Object--
APPDIR Vector.CANalyzer.LIN.InteractiveScheduler.DLL
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
TypeRef:41
196
Int32
ElementCount
0
String
Guid
1
d0ce36e4-5f10-4081-9698-fc8bbd11db34
Boolean
Collapsed
False
--TextFormatter: End of Object--
TypeRef:38
200
Boolean
Active
True
TypeRef:42
TriggerType
218
Int32
value__
0
--TextFormatter: End of Object--
UInt32
KeyCode
0
UInt32
PeriodMs
10
String
Guid
1
c15e5c56-08d2-44f9-acb2-9802d9fa74fa
Boolean
Collapsed
False
--TextFormatter: End of Object--
TypeRef:40
202
Byte
B0
255
Byte
B1
255
Byte
B2
144
Byte
B3
255
Byte
B4
255
Byte
B5
255
Byte
B6
255
Byte
B7
127
String
Guid
1
f6a54970-01c5-4982-a8a1-39077d7e06e7
Boolean
Collapsed
False
--TextFormatter: End of Object--
TypeRef:41
203
Int32
ElementCount
0
String
Guid
1
9942794c-5760-41c7-b180-5929f60d9438
Boolean
Collapsed
False
--TextFormatter: End of Object--
End_Of_Object VNETStandaloneComponent 7
End_Of_Object VLINInteractiveSchedulerConfiguration 6
NULL

EndOfComment
0
1
End_Of_Object VDAOGBFunctionBlock 5
TABPredecessor:
0
TABSuccessor:
57
VDAOGBFunctionBlock 5 Begin_Of_Object
1
2
0
TABPredecessor:
66
TABSuccessor:
0
VCardConf 6 Begin_Of_Object
1
End_Of_Object VCardConf 6
NULL

EndOfComment
0
1
End_Of_Object VDAOGBFunctionBlock 5
End_Of_Object VDAOBus 4
NULL
0
End_Of_Object VDOLocalInfoStruct 3
0.000000
0 0
1 0 2 59421 1 240 1 2882400001 1029 1269 181 708 2882400002  0 0 0 59421 1 280 1 2882400001 1024 1224 183 383 2882400002  0 0 0 0 0 0   3 
SS_BEGIN_COMMON_INFO
1
0
SS_END_COMMON_INFO

EOF_MBSSDATA
1
LIN
5
1
1
0 1 0 1 0 1 1 0 899 0 2000 1 
SS_BEGIN_COMMON_INFO
1
3
Channels
1
Databases
1
Misc
1
SS_END_COMMON_INFO

EOF_BUSDATA
1
_Start_VPRBSManager 1 
0 0x32 0x1 
_End_VPRBSManager
NodeSignalPanelBustypeCount 0
EOF_BUS

EOF_MBSSDATA
End_Of_Object VGBRealTimeBox 2
VWriteBox 2 Begin_Of_Object
2
VUniqueBox 3 Begin_Of_Object
1
VBoxRoot 4 Begin_Of_Object
1
3
0 1 0 1 -1 -1 -1 -1 960 564 1920 846
Write
1

MDI_DOCK_INFO_END
5
1
6
0 1 -1 -1 -1 -1 960 564 1920 846
6 0 1025 195 0 0 300 180 300 180 0 61440 1 36756 1904 0 0 0 0 260 0 0 0 1 5 32767 1 59422 1 5 1026 200 4 93 595 1 1 0 0 1 195 0 59422 1 
END_OF_DOCK_INFO
1
1
0
1
1
1920 848
END_OF_DESKTOP_DATA
6
0 1 -1 -1 -1 -1 516 341 1000 587
6 1 1025 191 0 0 300 180 300 180 0 61440 1 36756 1904 0 0 0 0 260 0 0 0 1 5 32767 1 59422 1 5 1026 196 4 7 474 1 0 0 0 1 201 0 59422 1 
END_OF_DOCK_INFO
1
0
0
1
1
1275 837
END_OF_DESKTOP_DATA
6
0 1 -1 -1 -1 -1 1 296 499 587
6 0 0 0 0 0 0 0 0 0 0 0 0 0 0 0 0 0 0 0 0 0 0 -1 -1 32767 0 0 0 0 0 0 0 0 0 0 0 0 0 0 0 0 0 0 
END_OF_DOCK_INFO
1
2
0
1
1
1275 837
END_OF_DESKTOP_DATA
END_OF_DESKTOP_DATA_COLLECTION
0
0 1
1
6
0 0 0 0 0 0 283 291 853 654
6 0 0 0 0 0 0 0 0 0 0 0 0 0 0 0 0 0 0 0 0 0 0 -1 -1 32767 0 0 0 0 0 0 0 0 0 0 0 0 0 0 0 0 0 0 
END_OF_DOCK_INFO
0
-1
0
1
0
0 0
END_OF_DESKTOP_DATA
6
0 1 -1 -1 -1 -1 0 1 576 339
6 0 0 0 0 0 0 0 0 0 0 0 0 0 0 0 0 0 0 0 0 0 0 -1 -1 32767 0 0 0 0 0 0 0 0 0 0 -1 -1 0 0 0 0 0 0 
END_OF_DOCK_INFO
1
1
0
1
0
0 0
END_OF_DESKTOP_DATA
6
0 1 -1 -1 -1 -1 0 1 576 339
6 0 0 0 0 0 0 0 0 0 0 0 0 0 0 0 0 0 0 0 0 0 0 -1 -1 32767 0 0 0 0 0 0 0 0 0 0 -1 -1 0 0 0 0 0 0 
END_OF_DOCK_INFO
1
1
0
1
0
0 0
END_OF_DESKTOP_DATA
END_OF_DESKTOP_DATA_COLLECTION
0
END_OF_DESKTOP_MEMBER
{63372714-3383-4E08-B637-01C6E097AC1F}
0
End_Of_Object VBoxRoot 4
1 -1 0 0 0 0 0 0 0 0 0 0
End_Of_Object VUniqueBox 3
2
VWriteControlAdapter 3 Begin_Of_Object
2
VControlAdapter 4 Begin_Of_Object
1
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
End_Of_Object VSignalGeneratorStreamer 2
SignalGeneratorsReplay 1
VNETStandaloneComponent 2 Begin_Of_Object
1
VNETControlBox 3 Begin_Of_Object
2
VUniqueBox 4 Begin_Of_Object
1
VBoxRoot 5 Begin_Of_Object
1
3
1 -1 0 1 0 0 -1 -1 211 228 1173 656
Signal Generators and Signal Replay
1
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
