czc13611858691/hozonEp40/code/RTAS/app/EP40_seat/EP40_seat/src/driver_init.c

/**
 * \file
 *
 * \brief Driver initialization.
 *
 (c) 2020 Microchip Technology Inc. and its subsidiaries.

    Subject to your compliance with these terms,you may use this software and
    any derivatives exclusively with Microchip products.It is your responsibility
    to comply with third party license terms applicable to your use of third party
    software (including open source software) that may accompany Microchip software.

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
    IN NO EVENT WILL MICROCHIP BE LIABLE FOR ANY INDIRECT, SPECIAL, PUNITIVE,
    INCIDENTAL OR CONSEQUENTIAL LOSS, DAMAGE, COST OR EXPENSE OF ANY KIND
    WHATSOEVER RELATED TO THE SOFTWARE, HOWEVER CAUSED, EVEN IF MICROCHIP HAS
    BEEN ADVISED OF THE POSSIBILITY OR THE DAMAGES ARE FORESEEABLE. TO THE
    FULLEST EXTENT ALLOWED BY LAW, MICROCHIP'S TOTAL LIABILITY ON ALL CLAIMS IN
    ANY WAY RELATED TO THIS SOFTWARE WILL NOT EXCEED THE AMOUNT OF FEES, IF ANY,
    THAT YOU HAVE PAID DIRECTLY TO MICROCHIP FOR THIS SOFTWARE.
 *
 */

/*
 * Code generated by START.
 *
 * This file will be overwritten when reconfiguring your START project.
 * Please copy examples or other code you want to keep to a separate file
 * to avoid losing it when reconfiguring.
 */

#include "driver_init.h"
#include <system.h>

/* configure the pins and initialize the registers */
void USART_0_initialization(void)
{

	// Set pin direction to input
	PC1_set_dir(PORT_DIR_IN);

	PC1_set_pull_mode(
	    // <y> Pull configuration
	    // <id> pad_pull_config
	    // <PORT_PULL_OFF"> Off
	    // <PORT_PULL_UP"> Pull-up
	    PORT_PULL_OFF);

	// Set pin direction to output

	PC0_set_level(
	    // <y> Initial level
	    // <id> pad_initial_level
	    // <false"> Low
	    // <true"> High
	    false);

	PC0_set_dir(PORT_DIR_OUT);

	USART_0_init();
}

/* configure the pins and initialize the registers */
void USART_initialization(void)
{

	// Set pin direction to input
	PF1_set_dir(PORT_DIR_IN);

	PF1_set_pull_mode(
	    // <y> Pull configuration
	    // <id> pad_pull_config
	    // <PORT_PULL_OFF"> Off
	    // <PORT_PULL_UP"> Pull-up
	    PORT_PULL_OFF);

	// Set pin direction to output

	PF0_set_level(
	    // <y> Initial level
	    // <id> pad_initial_level
	    // <false"> Low
	    // <true"> High
	    false);

	PF0_set_dir(PORT_DIR_OUT);

	USART_init();
}

void TIMER_1_initialization(void)
{

	// Set pin direction to output

	PD2_set_level(
	    // <y> Initial level
	    // <id> pad_initial_level
	    // <false"> Low
	    // <true"> High
	    false);

	PD2_set_dir(PORT_DIR_OUT);

	/* set the alternate pin mux */

	PORTMUX.TCAROUTEA |= (PORTMUX_TCA00_bm | PORTMUX_TCA01_bm);

	// Set pin direction to output

	PD4_set_level(
	    // <y> Initial level
	    // <id> pad_initial_level
	    // <false"> Low
	    // <true"> High
	    false);

	PD4_set_dir(PORT_DIR_OUT);

	/* set the alternate pin mux */

	PORTMUX.TCAROUTEA |= (PORTMUX_TCA00_bm | PORTMUX_TCA01_bm);

	TIMER_1_init();
}

/* Initialize registers */
void FLASH_0_initialization(void)
{
	FLASH_0_init();
}

void TIMER_0_initialization(void)
{

	TIMER_0_init();
}

/**
 * \brief System initialization
 */
void system_init()
{
	mcu_init();

	/* PORT setting on PD3 */

	// Set pin direction to output

	LIN_EN_set_level(
	    // <y> Initial level
	    // <id> pad_initial_level
	    // <false"> Low
	    // <true"> High
	    true);

	LIN_EN_set_dir(PORT_DIR_OUT);

	/* PORT setting on PF2 */

	// Set pin direction to output

	LED_OUT_DAT_set_level(
	    // <y> Initial level
	    // <id> pad_initial_level
	    // <false"> Low
	    // <true"> High
	    false);

	LED_OUT_DAT_set_dir(PORT_DIR_OUT);

	/* PORT setting on PF3 */

	// Set pin direction to output

	LED_CS_set_level(
	    // <y> Initial level
	    // <id> pad_initial_level
	    // <false"> Low
	    // <true"> High
	    false);

	LED_CS_set_dir(PORT_DIR_OUT);

	/* PORT setting on PF4 */

	// Set pin direction to output

	LED_MCLK_set_level(
	    // <y> Initial level
	    // <id> pad_initial_level
	    // <false"> Low
	    // <true"> High
	    false);

	LED_MCLK_set_dir(PORT_DIR_OUT);

	/* PORT setting on PF5 */

	// Set pin direction to output

	LED_ON_N_set_level(
	    // <y> Initial level
	    // <id> pad_initial_level
	    // <false"> Low
	    // <true"> High
	    false);

	LED_ON_N_set_dir(PORT_DIR_OUT);

	CLKCTRL_init();

	USART_0_initialization();

	USART_initialization();

	SLPCTRL_init();

	CPUINT_init();

	TIMER_1_initialization();

	Timer_init();

	FLASH_0_initialization();

	TIMER_0_initialization();

	BOD_init();
}
