czc13611858691/hozonEp40/code/RTAS/app/EP40_seat/EP40_seat/include/atmel_start_pins.h

/*
 * Code generated from START.
 *
 * This file will be overwritten when reconfiguring your START project.
 * Please copy examples or other code you want to keep to a separate file
 * to avoid losing it when reconfiguring.
 */
#ifndef ATMEL_START_PINS_H_INCLUDED
#define ATMEL_START_PINS_H_INCLUDED

#include <port.h>

/**
 * \brief Set PA0 pull mode
 *
 * Configure pin to pull up, down or disable pull mode, supported pull
 * modes are defined by device used
 *
 * \param[in] pull_mode Pin pull mode
 */
static inline void PA0_set_pull_mode(const enum port_pull_mode pull_mode)
{
	PORTA_set_pin_pull_mode(0, pull_mode);
}

/**
 * \brief Set PA0 data direction
 *
 * Select if the pin data direction is input, output or disabled.
 * If disabled state is not possible, this function throws an assert.
 *
 * \param[in] direction PORT_DIR_IN  = Data direction in
 *                      PORT_DIR_OUT = Data direction out
 *                      PORT_DIR_OFF = Disables the pin
 *                      (low power state)
 */
static inline void PA0_set_dir(const enum port_dir dir)
{
	PORTA_set_pin_dir(0, dir);
}

/**
 * \brief Set PA0 input/sense configuration
 *
 * Enable/disable PA0 digital input buffer and pin change interrupt,
 * select pin interrupt edge/level sensing mode
 *
 * \param[in] isc PORT_ISC_INTDISABLE_gc    = Iterrupt disabled but input buffer enabled
 *                PORT_ISC_BOTHEDGES_gc     = Sense Both Edges
 *                PORT_ISC_RISING_gc        = Sense Rising Edge
 *                PORT_ISC_FALLING_gc       = Sense Falling Edge
 *                PORT_ISC_INPUT_DISABLE_gc = Digital Input Buffer disabled
 *                PORT_ISC_LEVEL_gc         = Sense low Level
 */
static inline void PA0_set_isc(const PORT_ISC_t isc)
{
	PORTA_pin_set_isc(0, isc);
}

/**
 * \brief Set PA0 inverted mode
 *
 * Enable or disable inverted I/O on a pin
 *
 * \param[in] inverted true  = I/O on PA0 is inverted
 *                     false = I/O on PA0 is not inverted
 */
static inline void PA0_set_inverted(const bool inverted)
{
	PORTA_pin_set_inverted(0, inverted);
}

/**
 * \brief Set PA0 level
 *
 * Sets output level on a pin
 *
 * \param[in] level true  = Pin level set to "high" state
 *                  false = Pin level set to "low" state
 */
static inline void PA0_set_level(const bool level)
{
	PORTA_set_pin_level(0, level);
}

/**
 * \brief Toggle output level on PA0
 *
 * Toggle the pin level
 */
static inline void PA0_toggle_level()
{
	PORTA_toggle_pin_level(0);
}

/**
 * \brief Get level on PA0
 *
 * Reads the level on a pin
 */
static inline bool PA0_get_level()
{
	return PORTA_get_pin_level(0);
}

/**
 * \brief Set PA1 pull mode
 *
 * Configure pin to pull up, down or disable pull mode, supported pull
 * modes are defined by device used
 *
 * \param[in] pull_mode Pin pull mode
 */
static inline void PA1_set_pull_mode(const enum port_pull_mode pull_mode)
{
	PORTA_set_pin_pull_mode(1, pull_mode);
}

/**
 * \brief Set PA1 data direction
 *
 * Select if the pin data direction is input, output or disabled.
 * If disabled state is not possible, this function throws an assert.
 *
 * \param[in] direction PORT_DIR_IN  = Data direction in
 *                      PORT_DIR_OUT = Data direction out
 *                      PORT_DIR_OFF = Disables the pin
 *                      (low power state)
 */
static inline void PA1_set_dir(const enum port_dir dir)
{
	PORTA_set_pin_dir(1, dir);
}

/**
 * \brief Set PA1 input/sense configuration
 *
 * Enable/disable PA1 digital input buffer and pin change interrupt,
 * select pin interrupt edge/level sensing mode
 *
 * \param[in] isc PORT_ISC_INTDISABLE_gc    = Iterrupt disabled but input buffer enabled
 *                PORT_ISC_BOTHEDGES_gc     = Sense Both Edges
 *                PORT_ISC_RISING_gc        = Sense Rising Edge
 *                PORT_ISC_FALLING_gc       = Sense Falling Edge
 *                PORT_ISC_INPUT_DISABLE_gc = Digital Input Buffer disabled
 *                PORT_ISC_LEVEL_gc         = Sense low Level
 */
static inline void PA1_set_isc(const PORT_ISC_t isc)
{
	PORTA_pin_set_isc(1, isc);
}

/**
 * \brief Set PA1 inverted mode
 *
 * Enable or disable inverted I/O on a pin
 *
 * \param[in] inverted true  = I/O on PA1 is inverted
 *                     false = I/O on PA1 is not inverted
 */
static inline void PA1_set_inverted(const bool inverted)
{
	PORTA_pin_set_inverted(1, inverted);
}

/**
 * \brief Set PA1 level
 *
 * Sets output level on a pin
 *
 * \param[in] level true  = Pin level set to "high" state
 *                  false = Pin level set to "low" state
 */
static inline void PA1_set_level(const bool level)
{
	PORTA_set_pin_level(1, level);
}

/**
 * \brief Toggle output level on PA1
 *
 * Toggle the pin level
 */
static inline void PA1_toggle_level()
{
	PORTA_toggle_pin_level(1);
}

/**
 * \brief Get level on PA1
 *
 * Reads the level on a pin
 */
static inline bool PA1_get_level()
{
	return PORTA_get_pin_level(1);
}

/**
 * \brief Set PA2 pull mode
 *
 * Configure pin to pull up, down or disable pull mode, supported pull
 * modes are defined by device used
 *
 * \param[in] pull_mode Pin pull mode
 */
static inline void PA2_set_pull_mode(const enum port_pull_mode pull_mode)
{
	PORTA_set_pin_pull_mode(2, pull_mode);
}

/**
 * \brief Set PA2 data direction
 *
 * Select if the pin data direction is input, output or disabled.
 * If disabled state is not possible, this function throws an assert.
 *
 * \param[in] direction PORT_DIR_IN  = Data direction in
 *                      PORT_DIR_OUT = Data direction out
 *                      PORT_DIR_OFF = Disables the pin
 *                      (low power state)
 */
static inline void PA2_set_dir(const enum port_dir dir)
{
	PORTA_set_pin_dir(2, dir);
}

/**
 * \brief Set PA2 input/sense configuration
 *
 * Enable/disable PA2 digital input buffer and pin change interrupt,
 * select pin interrupt edge/level sensing mode
 *
 * \param[in] isc PORT_ISC_INTDISABLE_gc    = Iterrupt disabled but input buffer enabled
 *                PORT_ISC_BOTHEDGES_gc     = Sense Both Edges
 *                PORT_ISC_RISING_gc        = Sense Rising Edge
 *                PORT_ISC_FALLING_gc       = Sense Falling Edge
 *                PORT_ISC_INPUT_DISABLE_gc = Digital Input Buffer disabled
 *                PORT_ISC_LEVEL_gc         = Sense low Level
 */
static inline void PA2_set_isc(const PORT_ISC_t isc)
{
	PORTA_pin_set_isc(2, isc);
}

/**
 * \brief Set PA2 inverted mode
 *
 * Enable or disable inverted I/O on a pin
 *
 * \param[in] inverted true  = I/O on PA2 is inverted
 *                     false = I/O on PA2 is not inverted
 */
static inline void PA2_set_inverted(const bool inverted)
{
	PORTA_pin_set_inverted(2, inverted);
}

/**
 * \brief Set PA2 level
 *
 * Sets output level on a pin
 *
 * \param[in] level true  = Pin level set to "high" state
 *                  false = Pin level set to "low" state
 */
static inline void PA2_set_level(const bool level)
{
	PORTA_set_pin_level(2, level);
}

/**
 * \brief Toggle output level on PA2
 *
 * Toggle the pin level
 */
static inline void PA2_toggle_level()
{
	PORTA_toggle_pin_level(2);
}

/**
 * \brief Get level on PA2
 *
 * Reads the level on a pin
 */
static inline bool PA2_get_level()
{
	return PORTA_get_pin_level(2);
}

/**
 * \brief Set PA3 pull mode
 *
 * Configure pin to pull up, down or disable pull mode, supported pull
 * modes are defined by device used
 *
 * \param[in] pull_mode Pin pull mode
 */
static inline void PA3_set_pull_mode(const enum port_pull_mode pull_mode)
{
	PORTA_set_pin_pull_mode(3, pull_mode);
}

/**
 * \brief Set PA3 data direction
 *
 * Select if the pin data direction is input, output or disabled.
 * If disabled state is not possible, this function throws an assert.
 *
 * \param[in] direction PORT_DIR_IN  = Data direction in
 *                      PORT_DIR_OUT = Data direction out
 *                      PORT_DIR_OFF = Disables the pin
 *                      (low power state)
 */
static inline void PA3_set_dir(const enum port_dir dir)
{
	PORTA_set_pin_dir(3, dir);
}

/**
 * \brief Set PA3 input/sense configuration
 *
 * Enable/disable PA3 digital input buffer and pin change interrupt,
 * select pin interrupt edge/level sensing mode
 *
 * \param[in] isc PORT_ISC_INTDISABLE_gc    = Iterrupt disabled but input buffer enabled
 *                PORT_ISC_BOTHEDGES_gc     = Sense Both Edges
 *                PORT_ISC_RISING_gc        = Sense Rising Edge
 *                PORT_ISC_FALLING_gc       = Sense Falling Edge
 *                PORT_ISC_INPUT_DISABLE_gc = Digital Input Buffer disabled
 *                PORT_ISC_LEVEL_gc         = Sense low Level
 */
static inline void PA3_set_isc(const PORT_ISC_t isc)
{
	PORTA_pin_set_isc(3, isc);
}

/**
 * \brief Set PA3 inverted mode
 *
 * Enable or disable inverted I/O on a pin
 *
 * \param[in] inverted true  = I/O on PA3 is inverted
 *                     false = I/O on PA3 is not inverted
 */
static inline void PA3_set_inverted(const bool inverted)
{
	PORTA_pin_set_inverted(3, inverted);
}

/**
 * \brief Set PA3 level
 *
 * Sets output level on a pin
 *
 * \param[in] level true  = Pin level set to "high" state
 *                  false = Pin level set to "low" state
 */
static inline void PA3_set_level(const bool level)
{
	PORTA_set_pin_level(3, level);
}

/**
 * \brief Toggle output level on PA3
 *
 * Toggle the pin level
 */
static inline void PA3_toggle_level()
{
	PORTA_toggle_pin_level(3);
}

/**
 * \brief Get level on PA3
 *
 * Reads the level on a pin
 */
static inline bool PA3_get_level()
{
	return PORTA_get_pin_level(3);
}

/**
 * \brief Set PA4 pull mode
 *
 * Configure pin to pull up, down or disable pull mode, supported pull
 * modes are defined by device used
 *
 * \param[in] pull_mode Pin pull mode
 */
static inline void PA4_set_pull_mode(const enum port_pull_mode pull_mode)
{
	PORTA_set_pin_pull_mode(4, pull_mode);
}

/**
 * \brief Set PA4 data direction
 *
 * Select if the pin data direction is input, output or disabled.
 * If disabled state is not possible, this function throws an assert.
 *
 * \param[in] direction PORT_DIR_IN  = Data direction in
 *                      PORT_DIR_OUT = Data direction out
 *                      PORT_DIR_OFF = Disables the pin
 *                      (low power state)
 */
static inline void PA4_set_dir(const enum port_dir dir)
{
	PORTA_set_pin_dir(4, dir);
}

/**
 * \brief Set PA4 input/sense configuration
 *
 * Enable/disable PA4 digital input buffer and pin change interrupt,
 * select pin interrupt edge/level sensing mode
 *
 * \param[in] isc PORT_ISC_INTDISABLE_gc    = Iterrupt disabled but input buffer enabled
 *                PORT_ISC_BOTHEDGES_gc     = Sense Both Edges
 *                PORT_ISC_RISING_gc        = Sense Rising Edge
 *                PORT_ISC_FALLING_gc       = Sense Falling Edge
 *                PORT_ISC_INPUT_DISABLE_gc = Digital Input Buffer disabled
 *                PORT_ISC_LEVEL_gc         = Sense low Level
 */
static inline void PA4_set_isc(const PORT_ISC_t isc)
{
	PORTA_pin_set_isc(4, isc);
}

/**
 * \brief Set PA4 inverted mode
 *
 * Enable or disable inverted I/O on a pin
 *
 * \param[in] inverted true  = I/O on PA4 is inverted
 *                     false = I/O on PA4 is not inverted
 */
static inline void PA4_set_inverted(const bool inverted)
{
	PORTA_pin_set_inverted(4, inverted);
}

/**
 * \brief Set PA4 level
 *
 * Sets output level on a pin
 *
 * \param[in] level true  = Pin level set to "high" state
 *                  false = Pin level set to "low" state
 */
static inline void PA4_set_level(const bool level)
{
	PORTA_set_pin_level(4, level);
}

/**
 * \brief Toggle output level on PA4
 *
 * Toggle the pin level
 */
static inline void PA4_toggle_level()
{
	PORTA_toggle_pin_level(4);
}

/**
 * \brief Get level on PA4
 *
 * Reads the level on a pin
 */
static inline bool PA4_get_level()
{
	return PORTA_get_pin_level(4);
}

/**
 * \brief Set PA5 pull mode
 *
 * Configure pin to pull up, down or disable pull mode, supported pull
 * modes are defined by device used
 *
 * \param[in] pull_mode Pin pull mode
 */
static inline void PA5_set_pull_mode(const enum port_pull_mode pull_mode)
{
	PORTA_set_pin_pull_mode(5, pull_mode);
}

/**
 * \brief Set PA5 data direction
 *
 * Select if the pin data direction is input, output or disabled.
 * If disabled state is not possible, this function throws an assert.
 *
 * \param[in] direction PORT_DIR_IN  = Data direction in
 *                      PORT_DIR_OUT = Data direction out
 *                      PORT_DIR_OFF = Disables the pin
 *                      (low power state)
 */
static inline void PA5_set_dir(const enum port_dir dir)
{
	PORTA_set_pin_dir(5, dir);
}

/**
 * \brief Set PA5 input/sense configuration
 *
 * Enable/disable PA5 digital input buffer and pin change interrupt,
 * select pin interrupt edge/level sensing mode
 *
 * \param[in] isc PORT_ISC_INTDISABLE_gc    = Iterrupt disabled but input buffer enabled
 *                PORT_ISC_BOTHEDGES_gc     = Sense Both Edges
 *                PORT_ISC_RISING_gc        = Sense Rising Edge
 *                PORT_ISC_FALLING_gc       = Sense Falling Edge
 *                PORT_ISC_INPUT_DISABLE_gc = Digital Input Buffer disabled
 *                PORT_ISC_LEVEL_gc         = Sense low Level
 */
static inline void PA5_set_isc(const PORT_ISC_t isc)
{
	PORTA_pin_set_isc(5, isc);
}

/**
 * \brief Set PA5 inverted mode
 *
 * Enable or disable inverted I/O on a pin
 *
 * \param[in] inverted true  = I/O on PA5 is inverted
 *                     false = I/O on PA5 is not inverted
 */
static inline void PA5_set_inverted(const bool inverted)
{
	PORTA_pin_set_inverted(5, inverted);
}

/**
 * \brief Set PA5 level
 *
 * Sets output level on a pin
 *
 * \param[in] level true  = Pin level set to "high" state
 *                  false = Pin level set to "low" state
 */
static inline void PA5_set_level(const bool level)
{
	PORTA_set_pin_level(5, level);
}

/**
 * \brief Toggle output level on PA5
 *
 * Toggle the pin level
 */
static inline void PA5_toggle_level()
{
	PORTA_toggle_pin_level(5);
}

/**
 * \brief Get level on PA5
 *
 * Reads the level on a pin
 */
static inline bool PA5_get_level()
{
	return PORTA_get_pin_level(5);
}

/**
 * \brief Set PA6 pull mode
 *
 * Configure pin to pull up, down or disable pull mode, supported pull
 * modes are defined by device used
 *
 * \param[in] pull_mode Pin pull mode
 */
static inline void PA6_set_pull_mode(const enum port_pull_mode pull_mode)
{
	PORTA_set_pin_pull_mode(6, pull_mode);
}

/**
 * \brief Set PA6 data direction
 *
 * Select if the pin data direction is input, output or disabled.
 * If disabled state is not possible, this function throws an assert.
 *
 * \param[in] direction PORT_DIR_IN  = Data direction in
 *                      PORT_DIR_OUT = Data direction out
 *                      PORT_DIR_OFF = Disables the pin
 *                      (low power state)
 */
static inline void PA6_set_dir(const enum port_dir dir)
{
	PORTA_set_pin_dir(6, dir);
}

/**
 * \brief Set PA6 input/sense configuration
 *
 * Enable/disable PA6 digital input buffer and pin change interrupt,
 * select pin interrupt edge/level sensing mode
 *
 * \param[in] isc PORT_ISC_INTDISABLE_gc    = Iterrupt disabled but input buffer enabled
 *                PORT_ISC_BOTHEDGES_gc     = Sense Both Edges
 *                PORT_ISC_RISING_gc        = Sense Rising Edge
 *                PORT_ISC_FALLING_gc       = Sense Falling Edge
 *                PORT_ISC_INPUT_DISABLE_gc = Digital Input Buffer disabled
 *                PORT_ISC_LEVEL_gc         = Sense low Level
 */
static inline void PA6_set_isc(const PORT_ISC_t isc)
{
	PORTA_pin_set_isc(6, isc);
}

/**
 * \brief Set PA6 inverted mode
 *
 * Enable or disable inverted I/O on a pin
 *
 * \param[in] inverted true  = I/O on PA6 is inverted
 *                     false = I/O on PA6 is not inverted
 */
static inline void PA6_set_inverted(const bool inverted)
{
	PORTA_pin_set_inverted(6, inverted);
}

/**
 * \brief Set PA6 level
 *
 * Sets output level on a pin
 *
 * \param[in] level true  = Pin level set to "high" state
 *                  false = Pin level set to "low" state
 */
static inline void PA6_set_level(const bool level)
{
	PORTA_set_pin_level(6, level);
}

/**
 * \brief Toggle output level on PA6
 *
 * Toggle the pin level
 */
static inline void PA6_toggle_level()
{
	PORTA_toggle_pin_level(6);
}

/**
 * \brief Get level on PA6
 *
 * Reads the level on a pin
 */
static inline bool PA6_get_level()
{
	return PORTA_get_pin_level(6);
}

/**
 * \brief Set PA7 pull mode
 *
 * Configure pin to pull up, down or disable pull mode, supported pull
 * modes are defined by device used
 *
 * \param[in] pull_mode Pin pull mode
 */
static inline void PA7_set_pull_mode(const enum port_pull_mode pull_mode)
{
	PORTA_set_pin_pull_mode(7, pull_mode);
}

/**
 * \brief Set PA7 data direction
 *
 * Select if the pin data direction is input, output or disabled.
 * If disabled state is not possible, this function throws an assert.
 *
 * \param[in] direction PORT_DIR_IN  = Data direction in
 *                      PORT_DIR_OUT = Data direction out
 *                      PORT_DIR_OFF = Disables the pin
 *                      (low power state)
 */
static inline void PA7_set_dir(const enum port_dir dir)
{
	PORTA_set_pin_dir(7, dir);
}

/**
 * \brief Set PA7 input/sense configuration
 *
 * Enable/disable PA7 digital input buffer and pin change interrupt,
 * select pin interrupt edge/level sensing mode
 *
 * \param[in] isc PORT_ISC_INTDISABLE_gc    = Iterrupt disabled but input buffer enabled
 *                PORT_ISC_BOTHEDGES_gc     = Sense Both Edges
 *                PORT_ISC_RISING_gc        = Sense Rising Edge
 *                PORT_ISC_FALLING_gc       = Sense Falling Edge
 *                PORT_ISC_INPUT_DISABLE_gc = Digital Input Buffer disabled
 *                PORT_ISC_LEVEL_gc         = Sense low Level
 */
static inline void PA7_set_isc(const PORT_ISC_t isc)
{
	PORTA_pin_set_isc(7, isc);
}

/**
 * \brief Set PA7 inverted mode
 *
 * Enable or disable inverted I/O on a pin
 *
 * \param[in] inverted true  = I/O on PA7 is inverted
 *                     false = I/O on PA7 is not inverted
 */
static inline void PA7_set_inverted(const bool inverted)
{
	PORTA_pin_set_inverted(7, inverted);
}

/**
 * \brief Set PA7 level
 *
 * Sets output level on a pin
 *
 * \param[in] level true  = Pin level set to "high" state
 *                  false = Pin level set to "low" state
 */
static inline void PA7_set_level(const bool level)
{
	PORTA_set_pin_level(7, level);
}

/**
 * \brief Toggle output level on PA7
 *
 * Toggle the pin level
 */
static inline void PA7_toggle_level()
{
	PORTA_toggle_pin_level(7);
}

/**
 * \brief Get level on PA7
 *
 * Reads the level on a pin
 */
static inline bool PA7_get_level()
{
	return PORTA_get_pin_level(7);
}

/**
 * \brief Set PC0 pull mode
 *
 * Configure pin to pull up, down or disable pull mode, supported pull
 * modes are defined by device used
 *
 * \param[in] pull_mode Pin pull mode
 */
static inline void PC0_set_pull_mode(const enum port_pull_mode pull_mode)
{
	PORTC_set_pin_pull_mode(0, pull_mode);
}

/**
 * \brief Set PC0 data direction
 *
 * Select if the pin data direction is input, output or disabled.
 * If disabled state is not possible, this function throws an assert.
 *
 * \param[in] direction PORT_DIR_IN  = Data direction in
 *                      PORT_DIR_OUT = Data direction out
 *                      PORT_DIR_OFF = Disables the pin
 *                      (low power state)
 */
static inline void PC0_set_dir(const enum port_dir dir)
{
	PORTC_set_pin_dir(0, dir);
}

/**
 * \brief Set PC0 input/sense configuration
 *
 * Enable/disable PC0 digital input buffer and pin change interrupt,
 * select pin interrupt edge/level sensing mode
 *
 * \param[in] isc PORT_ISC_INTDISABLE_gc    = Iterrupt disabled but input buffer enabled
 *                PORT_ISC_BOTHEDGES_gc     = Sense Both Edges
 *                PORT_ISC_RISING_gc        = Sense Rising Edge
 *                PORT_ISC_FALLING_gc       = Sense Falling Edge
 *                PORT_ISC_INPUT_DISABLE_gc = Digital Input Buffer disabled
 *                PORT_ISC_LEVEL_gc         = Sense low Level
 */
static inline void PC0_set_isc(const PORT_ISC_t isc)
{
	PORTC_pin_set_isc(0, isc);
}

/**
 * \brief Set PC0 inverted mode
 *
 * Enable or disable inverted I/O on a pin
 *
 * \param[in] inverted true  = I/O on PC0 is inverted
 *                     false = I/O on PC0 is not inverted
 */
static inline void PC0_set_inverted(const bool inverted)
{
	PORTC_pin_set_inverted(0, inverted);
}

/**
 * \brief Set PC0 level
 *
 * Sets output level on a pin
 *
 * \param[in] level true  = Pin level set to "high" state
 *                  false = Pin level set to "low" state
 */
static inline void PC0_set_level(const bool level)
{
	PORTC_set_pin_level(0, level);
}

/**
 * \brief Toggle output level on PC0
 *
 * Toggle the pin level
 */
static inline void PC0_toggle_level()
{
	PORTC_toggle_pin_level(0);
}

/**
 * \brief Get level on PC0
 *
 * Reads the level on a pin
 */
static inline bool PC0_get_level()
{
	return PORTC_get_pin_level(0);
}

/**
 * \brief Set PC1 pull mode
 *
 * Configure pin to pull up, down or disable pull mode, supported pull
 * modes are defined by device used
 *
 * \param[in] pull_mode Pin pull mode
 */
static inline void PC1_set_pull_mode(const enum port_pull_mode pull_mode)
{
	PORTC_set_pin_pull_mode(1, pull_mode);
}

/**
 * \brief Set PC1 data direction
 *
 * Select if the pin data direction is input, output or disabled.
 * If disabled state is not possible, this function throws an assert.
 *
 * \param[in] direction PORT_DIR_IN  = Data direction in
 *                      PORT_DIR_OUT = Data direction out
 *                      PORT_DIR_OFF = Disables the pin
 *                      (low power state)
 */
static inline void PC1_set_dir(const enum port_dir dir)
{
	PORTC_set_pin_dir(1, dir);
}

/**
 * \brief Set PC1 input/sense configuration
 *
 * Enable/disable PC1 digital input buffer and pin change interrupt,
 * select pin interrupt edge/level sensing mode
 *
 * \param[in] isc PORT_ISC_INTDISABLE_gc    = Iterrupt disabled but input buffer enabled
 *                PORT_ISC_BOTHEDGES_gc     = Sense Both Edges
 *                PORT_ISC_RISING_gc        = Sense Rising Edge
 *                PORT_ISC_FALLING_gc       = Sense Falling Edge
 *                PORT_ISC_INPUT_DISABLE_gc = Digital Input Buffer disabled
 *                PORT_ISC_LEVEL_gc         = Sense low Level
 */
static inline void PC1_set_isc(const PORT_ISC_t isc)
{
	PORTC_pin_set_isc(1, isc);
}

/**
 * \brief Set PC1 inverted mode
 *
 * Enable or disable inverted I/O on a pin
 *
 * \param[in] inverted true  = I/O on PC1 is inverted
 *                     false = I/O on PC1 is not inverted
 */
static inline void PC1_set_inverted(const bool inverted)
{
	PORTC_pin_set_inverted(1, inverted);
}

/**
 * \brief Set PC1 level
 *
 * Sets output level on a pin
 *
 * \param[in] level true  = Pin level set to "high" state
 *                  false = Pin level set to "low" state
 */
static inline void PC1_set_level(const bool level)
{
	PORTC_set_pin_level(1, level);
}

/**
 * \brief Toggle output level on PC1
 *
 * Toggle the pin level
 */
static inline void PC1_toggle_level()
{
	PORTC_toggle_pin_level(1);
}

/**
 * \brief Get level on PC1
 *
 * Reads the level on a pin
 */
static inline bool PC1_get_level()
{
	return PORTC_get_pin_level(1);
}

/**
 * \brief Set PD0 pull mode
 *
 * Configure pin to pull up, down or disable pull mode, supported pull
 * modes are defined by device used
 *
 * \param[in] pull_mode Pin pull mode
 */
static inline void PD0_set_pull_mode(const enum port_pull_mode pull_mode)
{
	PORTD_set_pin_pull_mode(0, pull_mode);
}

/**
 * \brief Set PD0 data direction
 *
 * Select if the pin data direction is input, output or disabled.
 * If disabled state is not possible, this function throws an assert.
 *
 * \param[in] direction PORT_DIR_IN  = Data direction in
 *                      PORT_DIR_OUT = Data direction out
 *                      PORT_DIR_OFF = Disables the pin
 *                      (low power state)
 */
static inline void PD0_set_dir(const enum port_dir dir)
{
	PORTD_set_pin_dir(0, dir);
}

/**
 * \brief Set PD0 input/sense configuration
 *
 * Enable/disable PD0 digital input buffer and pin change interrupt,
 * select pin interrupt edge/level sensing mode
 *
 * \param[in] isc PORT_ISC_INTDISABLE_gc    = Iterrupt disabled but input buffer enabled
 *                PORT_ISC_BOTHEDGES_gc     = Sense Both Edges
 *                PORT_ISC_RISING_gc        = Sense Rising Edge
 *                PORT_ISC_FALLING_gc       = Sense Falling Edge
 *                PORT_ISC_INPUT_DISABLE_gc = Digital Input Buffer disabled
 *                PORT_ISC_LEVEL_gc         = Sense low Level
 */
static inline void PD0_set_isc(const PORT_ISC_t isc)
{
	PORTD_pin_set_isc(0, isc);
}

/**
 * \brief Set PD0 inverted mode
 *
 * Enable or disable inverted I/O on a pin
 *
 * \param[in] inverted true  = I/O on PD0 is inverted
 *                     false = I/O on PD0 is not inverted
 */
static inline void PD0_set_inverted(const bool inverted)
{
	PORTD_pin_set_inverted(0, inverted);
}

/**
 * \brief Set PD0 level
 *
 * Sets output level on a pin
 *
 * \param[in] level true  = Pin level set to "high" state
 *                  false = Pin level set to "low" state
 */
static inline void PD0_set_level(const bool level)
{
	PORTD_set_pin_level(0, level);
}

/**
 * \brief Toggle output level on PD0
 *
 * Toggle the pin level
 */
static inline void PD0_toggle_level()
{
	PORTD_toggle_pin_level(0);
}

/**
 * \brief Get level on PD0
 *
 * Reads the level on a pin
 */
static inline bool PD0_get_level()
{
	return PORTD_get_pin_level(0);
}

/**
 * \brief Set PD2 pull mode
 *
 * Configure pin to pull up, down or disable pull mode, supported pull
 * modes are defined by device used
 *
 * \param[in] pull_mode Pin pull mode
 */
static inline void PD2_set_pull_mode(const enum port_pull_mode pull_mode)
{
	PORTD_set_pin_pull_mode(2, pull_mode);
}

/**
 * \brief Set PD2 data direction
 *
 * Select if the pin data direction is input, output or disabled.
 * If disabled state is not possible, this function throws an assert.
 *
 * \param[in] direction PORT_DIR_IN  = Data direction in
 *                      PORT_DIR_OUT = Data direction out
 *                      PORT_DIR_OFF = Disables the pin
 *                      (low power state)
 */
static inline void PD2_set_dir(const enum port_dir dir)
{
	PORTD_set_pin_dir(2, dir);
}

/**
 * \brief Set PD2 input/sense configuration
 *
 * Enable/disable PD2 digital input buffer and pin change interrupt,
 * select pin interrupt edge/level sensing mode
 *
 * \param[in] isc PORT_ISC_INTDISABLE_gc    = Iterrupt disabled but input buffer enabled
 *                PORT_ISC_BOTHEDGES_gc     = Sense Both Edges
 *                PORT_ISC_RISING_gc        = Sense Rising Edge
 *                PORT_ISC_FALLING_gc       = Sense Falling Edge
 *                PORT_ISC_INPUT_DISABLE_gc = Digital Input Buffer disabled
 *                PORT_ISC_LEVEL_gc         = Sense low Level
 */
static inline void PD2_set_isc(const PORT_ISC_t isc)
{
	PORTD_pin_set_isc(2, isc);
}

/**
 * \brief Set PD2 inverted mode
 *
 * Enable or disable inverted I/O on a pin
 *
 * \param[in] inverted true  = I/O on PD2 is inverted
 *                     false = I/O on PD2 is not inverted
 */
static inline void PD2_set_inverted(const bool inverted)
{
	PORTD_pin_set_inverted(2, inverted);
}

/**
 * \brief Set PD2 level
 *
 * Sets output level on a pin
 *
 * \param[in] level true  = Pin level set to "high" state
 *                  false = Pin level set to "low" state
 */
static inline void PD2_set_level(const bool level)
{
	PORTD_set_pin_level(2, level);
}

/**
 * \brief Toggle output level on PD2
 *
 * Toggle the pin level
 */
static inline void PD2_toggle_level()
{
	PORTD_toggle_pin_level(2);
}

/**
 * \brief Get level on PD2
 *
 * Reads the level on a pin
 */
static inline bool PD2_get_level()
{
	return PORTD_get_pin_level(2);
}

/**
 * \brief Set LIN_EN pull mode
 *
 * Configure pin to pull up, down or disable pull mode, supported pull
 * modes are defined by device used
 *
 * \param[in] pull_mode Pin pull mode
 */
static inline void LIN_EN_set_pull_mode(const enum port_pull_mode pull_mode)
{
	PORTD_set_pin_pull_mode(3, pull_mode);
}

/**
 * \brief Set LIN_EN data direction
 *
 * Select if the pin data direction is input, output or disabled.
 * If disabled state is not possible, this function throws an assert.
 *
 * \param[in] direction PORT_DIR_IN  = Data direction in
 *                      PORT_DIR_OUT = Data direction out
 *                      PORT_DIR_OFF = Disables the pin
 *                      (low power state)
 */
static inline void LIN_EN_set_dir(const enum port_dir dir)
{
	PORTD_set_pin_dir(3, dir);
}

/**
 * \brief Set LIN_EN input/sense configuration
 *
 * Enable/disable LIN_EN digital input buffer and pin change interrupt,
 * select pin interrupt edge/level sensing mode
 *
 * \param[in] isc PORT_ISC_INTDISABLE_gc    = Iterrupt disabled but input buffer enabled
 *                PORT_ISC_BOTHEDGES_gc     = Sense Both Edges
 *                PORT_ISC_RISING_gc        = Sense Rising Edge
 *                PORT_ISC_FALLING_gc       = Sense Falling Edge
 *                PORT_ISC_INPUT_DISABLE_gc = Digital Input Buffer disabled
 *                PORT_ISC_LEVEL_gc         = Sense low Level
 */
static inline void LIN_EN_set_isc(const PORT_ISC_t isc)
{
	PORTD_pin_set_isc(3, isc);
}

/**
 * \brief Set LIN_EN inverted mode
 *
 * Enable or disable inverted I/O on a pin
 *
 * \param[in] inverted true  = I/O on LIN_EN is inverted
 *                     false = I/O on LIN_EN is not inverted
 */
static inline void LIN_EN_set_inverted(const bool inverted)
{
	PORTD_pin_set_inverted(3, inverted);
}

/**
 * \brief Set LIN_EN level
 *
 * Sets output level on a pin
 *
 * \param[in] level true  = Pin level set to "high" state
 *                  false = Pin level set to "low" state
 */
static inline void LIN_EN_set_level(const bool level)
{
	PORTD_set_pin_level(3, level);
}

/**
 * \brief Toggle output level on LIN_EN
 *
 * Toggle the pin level
 */
static inline void LIN_EN_toggle_level()
{
	PORTD_toggle_pin_level(3);
}

/**
 * \brief Get level on LIN_EN
 *
 * Reads the level on a pin
 */
static inline bool LIN_EN_get_level()
{
	return PORTD_get_pin_level(3);
}

/**
 * \brief Set PD4 pull mode
 *
 * Configure pin to pull up, down or disable pull mode, supported pull
 * modes are defined by device used
 *
 * \param[in] pull_mode Pin pull mode
 */
static inline void PD4_set_pull_mode(const enum port_pull_mode pull_mode)
{
	PORTD_set_pin_pull_mode(4, pull_mode);
}

/**
 * \brief Set PD4 data direction
 *
 * Select if the pin data direction is input, output or disabled.
 * If disabled state is not possible, this function throws an assert.
 *
 * \param[in] direction PORT_DIR_IN  = Data direction in
 *                      PORT_DIR_OUT = Data direction out
 *                      PORT_DIR_OFF = Disables the pin
 *                      (low power state)
 */
static inline void PD4_set_dir(const enum port_dir dir)
{
	PORTD_set_pin_dir(4, dir);
}

/**
 * \brief Set PD4 input/sense configuration
 *
 * Enable/disable PD4 digital input buffer and pin change interrupt,
 * select pin interrupt edge/level sensing mode
 *
 * \param[in] isc PORT_ISC_INTDISABLE_gc    = Iterrupt disabled but input buffer enabled
 *                PORT_ISC_BOTHEDGES_gc     = Sense Both Edges
 *                PORT_ISC_RISING_gc        = Sense Rising Edge
 *                PORT_ISC_FALLING_gc       = Sense Falling Edge
 *                PORT_ISC_INPUT_DISABLE_gc = Digital Input Buffer disabled
 *                PORT_ISC_LEVEL_gc         = Sense low Level
 */
static inline void PD4_set_isc(const PORT_ISC_t isc)
{
	PORTD_pin_set_isc(4, isc);
}

/**
 * \brief Set PD4 inverted mode
 *
 * Enable or disable inverted I/O on a pin
 *
 * \param[in] inverted true  = I/O on PD4 is inverted
 *                     false = I/O on PD4 is not inverted
 */
static inline void PD4_set_inverted(const bool inverted)
{
	PORTD_pin_set_inverted(4, inverted);
}

/**
 * \brief Set PD4 level
 *
 * Sets output level on a pin
 *
 * \param[in] level true  = Pin level set to "high" state
 *                  false = Pin level set to "low" state
 */
static inline void PD4_set_level(const bool level)
{
	PORTD_set_pin_level(4, level);
}

/**
 * \brief Toggle output level on PD4
 *
 * Toggle the pin level
 */
static inline void PD4_toggle_level()
{
	PORTD_toggle_pin_level(4);
}

/**
 * \brief Get level on PD4
 *
 * Reads the level on a pin
 */
static inline bool PD4_get_level()
{
	return PORTD_get_pin_level(4);
}

/**
 * \brief Set PF0 pull mode
 *
 * Configure pin to pull up, down or disable pull mode, supported pull
 * modes are defined by device used
 *
 * \param[in] pull_mode Pin pull mode
 */
static inline void PF0_set_pull_mode(const enum port_pull_mode pull_mode)
{
	PORTF_set_pin_pull_mode(0, pull_mode);
}

/**
 * \brief Set PF0 data direction
 *
 * Select if the pin data direction is input, output or disabled.
 * If disabled state is not possible, this function throws an assert.
 *
 * \param[in] direction PORT_DIR_IN  = Data direction in
 *                      PORT_DIR_OUT = Data direction out
 *                      PORT_DIR_OFF = Disables the pin
 *                      (low power state)
 */
static inline void PF0_set_dir(const enum port_dir dir)
{
	PORTF_set_pin_dir(0, dir);
}

/**
 * \brief Set PF0 input/sense configuration
 *
 * Enable/disable PF0 digital input buffer and pin change interrupt,
 * select pin interrupt edge/level sensing mode
 *
 * \param[in] isc PORT_ISC_INTDISABLE_gc    = Iterrupt disabled but input buffer enabled
 *                PORT_ISC_BOTHEDGES_gc     = Sense Both Edges
 *                PORT_ISC_RISING_gc        = Sense Rising Edge
 *                PORT_ISC_FALLING_gc       = Sense Falling Edge
 *                PORT_ISC_INPUT_DISABLE_gc = Digital Input Buffer disabled
 *                PORT_ISC_LEVEL_gc         = Sense low Level
 */
static inline void PF0_set_isc(const PORT_ISC_t isc)
{
	PORTF_pin_set_isc(0, isc);
}

/**
 * \brief Set PF0 inverted mode
 *
 * Enable or disable inverted I/O on a pin
 *
 * \param[in] inverted true  = I/O on PF0 is inverted
 *                     false = I/O on PF0 is not inverted
 */
static inline void PF0_set_inverted(const bool inverted)
{
	PORTF_pin_set_inverted(0, inverted);
}

/**
 * \brief Set PF0 level
 *
 * Sets output level on a pin
 *
 * \param[in] level true  = Pin level set to "high" state
 *                  false = Pin level set to "low" state
 */
static inline void PF0_set_level(const bool level)
{
	PORTF_set_pin_level(0, level);
}

/**
 * \brief Toggle output level on PF0
 *
 * Toggle the pin level
 */
static inline void PF0_toggle_level()
{
	PORTF_toggle_pin_level(0);
}

/**
 * \brief Get level on PF0
 *
 * Reads the level on a pin
 */
static inline bool PF0_get_level()
{
	return PORTF_get_pin_level(0);
}

/**
 * \brief Set PF1 pull mode
 *
 * Configure pin to pull up, down or disable pull mode, supported pull
 * modes are defined by device used
 *
 * \param[in] pull_mode Pin pull mode
 */
static inline void PF1_set_pull_mode(const enum port_pull_mode pull_mode)
{
	PORTF_set_pin_pull_mode(1, pull_mode);
}

/**
 * \brief Set PF1 data direction
 *
 * Select if the pin data direction is input, output or disabled.
 * If disabled state is not possible, this function throws an assert.
 *
 * \param[in] direction PORT_DIR_IN  = Data direction in
 *                      PORT_DIR_OUT = Data direction out
 *                      PORT_DIR_OFF = Disables the pin
 *                      (low power state)
 */
static inline void PF1_set_dir(const enum port_dir dir)
{
	PORTF_set_pin_dir(1, dir);
}

/**
 * \brief Set PF1 input/sense configuration
 *
 * Enable/disable PF1 digital input buffer and pin change interrupt,
 * select pin interrupt edge/level sensing mode
 *
 * \param[in] isc PORT_ISC_INTDISABLE_gc    = Iterrupt disabled but input buffer enabled
 *                PORT_ISC_BOTHEDGES_gc     = Sense Both Edges
 *                PORT_ISC_RISING_gc        = Sense Rising Edge
 *                PORT_ISC_FALLING_gc       = Sense Falling Edge
 *                PORT_ISC_INPUT_DISABLE_gc = Digital Input Buffer disabled
 *                PORT_ISC_LEVEL_gc         = Sense low Level
 */
static inline void PF1_set_isc(const PORT_ISC_t isc)
{
	PORTF_pin_set_isc(1, isc);
}

/**
 * \brief Set PF1 inverted mode
 *
 * Enable or disable inverted I/O on a pin
 *
 * \param[in] inverted true  = I/O on PF1 is inverted
 *                     false = I/O on PF1 is not inverted
 */
static inline void PF1_set_inverted(const bool inverted)
{
	PORTF_pin_set_inverted(1, inverted);
}

/**
 * \brief Set PF1 level
 *
 * Sets output level on a pin
 *
 * \param[in] level true  = Pin level set to "high" state
 *                  false = Pin level set to "low" state
 */
static inline void PF1_set_level(const bool level)
{
	PORTF_set_pin_level(1, level);
}

/**
 * \brief Toggle output level on PF1
 *
 * Toggle the pin level
 */
static inline void PF1_toggle_level()
{
	PORTF_toggle_pin_level(1);
}

/**
 * \brief Get level on PF1
 *
 * Reads the level on a pin
 */
static inline bool PF1_get_level()
{
	return PORTF_get_pin_level(1);
}

/**
 * \brief Set LED_OUT_DAT pull mode
 *
 * Configure pin to pull up, down or disable pull mode, supported pull
 * modes are defined by device used
 *
 * \param[in] pull_mode Pin pull mode
 */
static inline void LED_OUT_DAT_set_pull_mode(const enum port_pull_mode pull_mode)
{
	PORTF_set_pin_pull_mode(2, pull_mode);
}

/**
 * \brief Set LED_OUT_DAT data direction
 *
 * Select if the pin data direction is input, output or disabled.
 * If disabled state is not possible, this function throws an assert.
 *
 * \param[in] direction PORT_DIR_IN  = Data direction in
 *                      PORT_DIR_OUT = Data direction out
 *                      PORT_DIR_OFF = Disables the pin
 *                      (low power state)
 */
static inline void LED_OUT_DAT_set_dir(const enum port_dir dir)
{
	PORTF_set_pin_dir(2, dir);
}

/**
 * \brief Set LED_OUT_DAT input/sense configuration
 *
 * Enable/disable LED_OUT_DAT digital input buffer and pin change interrupt,
 * select pin interrupt edge/level sensing mode
 *
 * \param[in] isc PORT_ISC_INTDISABLE_gc    = Iterrupt disabled but input buffer enabled
 *                PORT_ISC_BOTHEDGES_gc     = Sense Both Edges
 *                PORT_ISC_RISING_gc        = Sense Rising Edge
 *                PORT_ISC_FALLING_gc       = Sense Falling Edge
 *                PORT_ISC_INPUT_DISABLE_gc = Digital Input Buffer disabled
 *                PORT_ISC_LEVEL_gc         = Sense low Level
 */
static inline void LED_OUT_DAT_set_isc(const PORT_ISC_t isc)
{
	PORTF_pin_set_isc(2, isc);
}

/**
 * \brief Set LED_OUT_DAT inverted mode
 *
 * Enable or disable inverted I/O on a pin
 *
 * \param[in] inverted true  = I/O on LED_OUT_DAT is inverted
 *                     false = I/O on LED_OUT_DAT is not inverted
 */
static inline void LED_OUT_DAT_set_inverted(const bool inverted)
{
	PORTF_pin_set_inverted(2, inverted);
}

/**
 * \brief Set LED_OUT_DAT level
 *
 * Sets output level on a pin
 *
 * \param[in] level true  = Pin level set to "high" state
 *                  false = Pin level set to "low" state
 */
static inline void LED_OUT_DAT_set_level(const bool level)
{
	PORTF_set_pin_level(2, level);
}

/**
 * \brief Toggle output level on LED_OUT_DAT
 *
 * Toggle the pin level
 */
static inline void LED_OUT_DAT_toggle_level()
{
	PORTF_toggle_pin_level(2);
}

/**
 * \brief Get level on LED_OUT_DAT
 *
 * Reads the level on a pin
 */
static inline bool LED_OUT_DAT_get_level()
{
	return PORTF_get_pin_level(2);
}

/**
 * \brief Set LED_CS pull mode
 *
 * Configure pin to pull up, down or disable pull mode, supported pull
 * modes are defined by device used
 *
 * \param[in] pull_mode Pin pull mode
 */
static inline void LED_CS_set_pull_mode(const enum port_pull_mode pull_mode)
{
	PORTF_set_pin_pull_mode(3, pull_mode);
}

/**
 * \brief Set LED_CS data direction
 *
 * Select if the pin data direction is input, output or disabled.
 * If disabled state is not possible, this function throws an assert.
 *
 * \param[in] direction PORT_DIR_IN  = Data direction in
 *                      PORT_DIR_OUT = Data direction out
 *                      PORT_DIR_OFF = Disables the pin
 *                      (low power state)
 */
static inline void LED_CS_set_dir(const enum port_dir dir)
{
	PORTF_set_pin_dir(3, dir);
}

/**
 * \brief Set LED_CS input/sense configuration
 *
 * Enable/disable LED_CS digital input buffer and pin change interrupt,
 * select pin interrupt edge/level sensing mode
 *
 * \param[in] isc PORT_ISC_INTDISABLE_gc    = Iterrupt disabled but input buffer enabled
 *                PORT_ISC_BOTHEDGES_gc     = Sense Both Edges
 *                PORT_ISC_RISING_gc        = Sense Rising Edge
 *                PORT_ISC_FALLING_gc       = Sense Falling Edge
 *                PORT_ISC_INPUT_DISABLE_gc = Digital Input Buffer disabled
 *                PORT_ISC_LEVEL_gc         = Sense low Level
 */
static inline void LED_CS_set_isc(const PORT_ISC_t isc)
{
	PORTF_pin_set_isc(3, isc);
}

/**
 * \brief Set LED_CS inverted mode
 *
 * Enable or disable inverted I/O on a pin
 *
 * \param[in] inverted true  = I/O on LED_CS is inverted
 *                     false = I/O on LED_CS is not inverted
 */
static inline void LED_CS_set_inverted(const bool inverted)
{
	PORTF_pin_set_inverted(3, inverted);
}

/**
 * \brief Set LED_CS level
 *
 * Sets output level on a pin
 *
 * \param[in] level true  = Pin level set to "high" state
 *                  false = Pin level set to "low" state
 */
static inline void LED_CS_set_level(const bool level)
{
	PORTF_set_pin_level(3, level);
}

/**
 * \brief Toggle output level on LED_CS
 *
 * Toggle the pin level
 */
static inline void LED_CS_toggle_level()
{
	PORTF_toggle_pin_level(3);
}

/**
 * \brief Get level on LED_CS
 *
 * Reads the level on a pin
 */
static inline bool LED_CS_get_level()
{
	return PORTF_get_pin_level(3);
}

/**
 * \brief Set LED_MCLK pull mode
 *
 * Configure pin to pull up, down or disable pull mode, supported pull
 * modes are defined by device used
 *
 * \param[in] pull_mode Pin pull mode
 */
static inline void LED_MCLK_set_pull_mode(const enum port_pull_mode pull_mode)
{
	PORTF_set_pin_pull_mode(4, pull_mode);
}

/**
 * \brief Set LED_MCLK data direction
 *
 * Select if the pin data direction is input, output or disabled.
 * If disabled state is not possible, this function throws an assert.
 *
 * \param[in] direction PORT_DIR_IN  = Data direction in
 *                      PORT_DIR_OUT = Data direction out
 *                      PORT_DIR_OFF = Disables the pin
 *                      (low power state)
 */
static inline void LED_MCLK_set_dir(const enum port_dir dir)
{
	PORTF_set_pin_dir(4, dir);
}

/**
 * \brief Set LED_MCLK input/sense configuration
 *
 * Enable/disable LED_MCLK digital input buffer and pin change interrupt,
 * select pin interrupt edge/level sensing mode
 *
 * \param[in] isc PORT_ISC_INTDISABLE_gc    = Iterrupt disabled but input buffer enabled
 *                PORT_ISC_BOTHEDGES_gc     = Sense Both Edges
 *                PORT_ISC_RISING_gc        = Sense Rising Edge
 *                PORT_ISC_FALLING_gc       = Sense Falling Edge
 *                PORT_ISC_INPUT_DISABLE_gc = Digital Input Buffer disabled
 *                PORT_ISC_LEVEL_gc         = Sense low Level
 */
static inline void LED_MCLK_set_isc(const PORT_ISC_t isc)
{
	PORTF_pin_set_isc(4, isc);
}

/**
 * \brief Set LED_MCLK inverted mode
 *
 * Enable or disable inverted I/O on a pin
 *
 * \param[in] inverted true  = I/O on LED_MCLK is inverted
 *                     false = I/O on LED_MCLK is not inverted
 */
static inline void LED_MCLK_set_inverted(const bool inverted)
{
	PORTF_pin_set_inverted(4, inverted);
}

/**
 * \brief Set LED_MCLK level
 *
 * Sets output level on a pin
 *
 * \param[in] level true  = Pin level set to "high" state
 *                  false = Pin level set to "low" state
 */
static inline void LED_MCLK_set_level(const bool level)
{
	PORTF_set_pin_level(4, level);
}

/**
 * \brief Toggle output level on LED_MCLK
 *
 * Toggle the pin level
 */
static inline void LED_MCLK_toggle_level()
{
	PORTF_toggle_pin_level(4);
}

/**
 * \brief Get level on LED_MCLK
 *
 * Reads the level on a pin
 */
static inline bool LED_MCLK_get_level()
{
	return PORTF_get_pin_level(4);
}

/**
 * \brief Set LED_ON_N pull mode
 *
 * Configure pin to pull up, down or disable pull mode, supported pull
 * modes are defined by device used
 *
 * \param[in] pull_mode Pin pull mode
 */
static inline void LED_ON_N_set_pull_mode(const enum port_pull_mode pull_mode)
{
	PORTF_set_pin_pull_mode(5, pull_mode);
}

/**
 * \brief Set LED_ON_N data direction
 *
 * Select if the pin data direction is input, output or disabled.
 * If disabled state is not possible, this function throws an assert.
 *
 * \param[in] direction PORT_DIR_IN  = Data direction in
 *                      PORT_DIR_OUT = Data direction out
 *                      PORT_DIR_OFF = Disables the pin
 *                      (low power state)
 */
static inline void LED_ON_N_set_dir(const enum port_dir dir)
{
	PORTF_set_pin_dir(5, dir);
}

/**
 * \brief Set LED_ON_N input/sense configuration
 *
 * Enable/disable LED_ON_N digital input buffer and pin change interrupt,
 * select pin interrupt edge/level sensing mode
 *
 * \param[in] isc PORT_ISC_INTDISABLE_gc    = Iterrupt disabled but input buffer enabled
 *                PORT_ISC_BOTHEDGES_gc     = Sense Both Edges
 *                PORT_ISC_RISING_gc        = Sense Rising Edge
 *                PORT_ISC_FALLING_gc       = Sense Falling Edge
 *                PORT_ISC_INPUT_DISABLE_gc = Digital Input Buffer disabled
 *                PORT_ISC_LEVEL_gc         = Sense low Level
 */
static inline void LED_ON_N_set_isc(const PORT_ISC_t isc)
{
	PORTF_pin_set_isc(5, isc);
}

/**
 * \brief Set LED_ON_N inverted mode
 *
 * Enable or disable inverted I/O on a pin
 *
 * \param[in] inverted true  = I/O on LED_ON_N is inverted
 *                     false = I/O on LED_ON_N is not inverted
 */
static inline void LED_ON_N_set_inverted(const bool inverted)
{
	PORTF_pin_set_inverted(5, inverted);
}

/**
 * \brief Set LED_ON_N level
 *
 * Sets output level on a pin
 *
 * \param[in] level true  = Pin level set to "high" state
 *                  false = Pin level set to "low" state
 */
static inline void LED_ON_N_set_level(const bool level)
{
	PORTF_set_pin_level(5, level);
}

/**
 * \brief Toggle output level on LED_ON_N
 *
 * Toggle the pin level
 */
static inline void LED_ON_N_toggle_level()
{
	PORTF_toggle_pin_level(5);
}

/**
 * \brief Get level on LED_ON_N
 *
 * Reads the level on a pin
 */
static inline bool LED_ON_N_get_level()
{
	return PORTF_get_pin_level(5);
}

#endif /* ATMEL_START_PINS_H_INCLUDED */
