czc13611858691/hozonEp40/code/PFGLS/app/AVR128DA28_FR_RR/user/common/app/ep40_function_specification.c

#include "ep40_function_specification.h"
#include "ep40_cfg.h"
#include "atmel_start_pins.h"
#include "target.h"

const uint32_t g_level[11] = {
    0,
    20,
    28,
    37,
    46,
    55,
    64,
    73,
    82,
    91,
    100,
};
uint8_t g_level_index = 4;//level3 初始值 37%

void btn_rear_tick_task(void)
{
    btn_rear_t* btn_rear_ptr = &g_btn_rear;
    switch (btn_rear_ptr->status)
    {
    case 0:
        if (btn_rear_ptr->cap_trig_flg == 1)
        {
            btn_rear_ptr->cap_trig_flg = 0;
            if (btn_rear_ptr->press_trig_flg == 1)
            {
                btn_rear_ptr->press_trig_flg = 0;

                btn_rear_ptr->status = 1;
                btn_rear_ptr->ticks = 0;
                if (btn_rear_ptr->rear_led_ctrl_cb != NULL)
                {
                    btn_rear_ptr->rear_led_ctrl_cb(1);
                }
            }
        }
        break;
    case 1:
        if (btn_rear_ptr->all_cap_status == 1)
        {
            btn_rear_ptr->ticks = 0;
        }
        else
        {
            btn_rear_ptr->ticks++;
        }
        if (btn_rear_ptr->ticks >= ((uint32_t)TIMEOUT_REAR_UNIT_S * 1000 / ONE_TICK_UNIT_MS))
        {
            btn_rear_ptr->ticks = 0;

            btn_rear_ptr->status = 0;
            if (btn_rear_ptr->rear_led_ctrl_cb != NULL)
            {
                btn_rear_ptr->rear_led_ctrl_cb(0);
            }
        }
        if (btn_rear_ptr->cap_trig_flg == 1)
        {
            btn_rear_ptr->cap_trig_flg = 0;
            if (btn_rear_ptr->press_trig_flg == 1)
            {
                btn_rear_ptr->press_trig_flg = 0;

                btn_rear_ptr->status = 0;
                if (btn_rear_ptr->rear_led_ctrl_cb != NULL)
                {
                    btn_rear_ptr->rear_led_ctrl_cb(0);
                }
            }
        }
        break;

    default:
        break;
    }
}

void window_task(window_t* window_ptr)
{
    switch (window_ptr->status)
    {
    case 0:
    {
        window_ptr->signal = SIGNAL_VAL_NO_REQUEST;
        if (window_ptr->btn_a_cap_trig_flg == 1)
        {
            window_ptr->btn_a_cap_trig_flg = 0;

            if (window_ptr->long_flg == 1)
            {
                window_ptr->signal = SIGNAL_VAL_MANUAL_UP;
                if (window_ptr->cb != NULL)
                {
                    window_ptr->cb(window_ptr->signal);
                }
                window_ptr->status = 1;
            }
            else
            {
                window_ptr->signal = SIGNAL_VAL_AUTO_UP;
                if (window_ptr->cb != NULL)
                {
                    window_ptr->cb(window_ptr->signal);
                }
            }
        }
        else if (window_ptr->btn_b_cap_trig_flg == 1)
        {
            window_ptr->btn_b_cap_trig_flg = 0;

            if (window_ptr->long_flg == 1)
            {
                window_ptr->signal = SIGNAL_VAL_MANUAL_DOWN;
                if (window_ptr->cb != NULL)
                {
                    window_ptr->cb(window_ptr->signal);
                }
                window_ptr->status = 1;
            }
            else
            {
                window_ptr->signal = SIGNAL_VAL_AUTO_DOWN;
                if (window_ptr->cb != NULL)
                {
                    window_ptr->cb(window_ptr->signal);
                }
            }
        }
        else if (window_ptr->slide_1_to_2_flg == 1)
        {
            window_ptr->slide_1_to_2_flg = 0;
            if (window_ptr->long_flg == 1)
            {
                window_ptr->signal = SIGNAL_VAL_MANUAL_UP;
                if (window_ptr->cb != NULL)
                {
                    window_ptr->cb(window_ptr->signal);
                }
                window_ptr->status = 2;
            }
            else
            {
                window_ptr->signal = SIGNAL_VAL_AUTO_UP;
                if (window_ptr->cb != NULL)
                {
                    window_ptr->cb(window_ptr->signal);
                }
            }
        }
        else if (window_ptr->slide_2_to_1_flg == 1)
        {
            window_ptr->slide_2_to_1_flg = 0;
            if (window_ptr->long_flg == 1)
            {
                window_ptr->signal = SIGNAL_VAL_MANUAL_DOWN;
                if (window_ptr->cb != NULL)
                {
                    window_ptr->cb(window_ptr->signal);
                }
                window_ptr->status = 2;
            }
            else
            {
                window_ptr->signal = SIGNAL_VAL_AUTO_DOWN;
                if (window_ptr->cb != NULL)
                {
                    window_ptr->cb(window_ptr->signal);
                }
            }
        }
    }
    break;
    case 1:
    {
        if (window_ptr->signal == SIGNAL_VAL_MANUAL_DOWN)
        {
            if (window_ptr->btn_b_status != 0)
            {
                if (window_ptr->cb != NULL)
                {
                    window_ptr->cb(window_ptr->signal);
                }
            }
            else
            {
                if (window_ptr->cb != NULL)
                {
                    window_ptr->cb(window_ptr->signal);
                }
                window_ptr->status = 0;
            }
        }
        else if (window_ptr->signal == SIGNAL_VAL_MANUAL_UP)
        {
            if (window_ptr->btn_a_status != 0)
            {
                if (window_ptr->cb != NULL)
                {
                    window_ptr->cb(window_ptr->signal);
                }
            }
            else
            {
                if (window_ptr->cb != NULL)
                {
                    window_ptr->cb(window_ptr->signal);
                }
                window_ptr->status = 0;
            }
        }
    }
    break;
    case 2:
    {
        if (window_ptr->slide_status != 0)
        {
            if (window_ptr->cb != NULL)
            {
                window_ptr->cb(window_ptr->signal);
            }
        }
        else
        {
            if (window_ptr->cb != NULL)
            {
                window_ptr->cb(window_ptr->signal);
            }
            window_ptr->status = 0;
        }
    }
    break;
    default:
        break;
    }
}

/* V01-3.1.5.6 */
void window_lock_task(void)
{
    window_lock_t* window_lock_ptr = &g_window_lock;
    LIN_RX_signal_t* signal_ptr = &g_lin_rx_signal;

    if (window_lock_ptr->capsense_flg == 1)
    {
        window_lock_ptr->capsense_flg = 0;

        if (window_lock_ptr->press_flg == 1)
        {
            window_lock_ptr->press_flg = 0;

            if (window_lock_ptr->signal_cb != NULL)
            {
                window_lock_ptr->signal_cb();
            }
        }
    }

    if (window_lock_ptr->led_cb != NULL)
    {
        window_lock_ptr->led_cb(signal_ptr->ctrl_window_lock);
    }
}

void backlight_task(void)
{
    LIN_RX_signal_t* signal_ptr = &g_lin_rx_signal;

    uint32_t tmp = 0;
    uint32_t night_gain = 0;

    if (signal_ptr->backlight_status == SIGNAL_VAL_ACTIVE)
    {
        night_gain = BACKLIGHT_NIGHT_GAIN;
        if (signal_ptr->backlight_brightness != 0)
        {
            g_level_index = signal_ptr->backlight_brightness;
        }
    }
    else
    {
        night_gain = BACKLIGHT_DAYTIME_GAIN;
        g_level_index = 10;
    }

    tmp = g_level[g_level_index] * night_gain * DUTY_MAX / 10000;

    if (g_backlight_cb != NULL)
    {
        g_backlight_cb(tmp);
    }
}
