czc13611858691/hozonEp40/code/DFGLS/app/microchip_studio_project/atmel_start.h

#ifndef ATMEL_START_H_INCLUDED
#define ATMEL_START_H_INCLUDED

#ifdef __cplusplus
extern "C" {
#endif

#include "include/driver_init.h"
#include "include/atmel_start_pins.h"

#include "touch.h"

/**
 * Initializes MCU, drivers and middleware in the project
 **/
void atmel_start_init(void);

#ifdef __cplusplus
}
#endif
#endif
