czc13611858691/hozonEp40/code/DFGLS/app/microchip_studio_project/led.h

/*
 * led.h
 *
 * Created: 2021/9/24 15:15:55
 *  Author: Sunny
 */

#ifndef LED_H_
#define LED_H_

#include <stdint.h>

typedef enum
{
    led_d16,
    led_d9,
    led_d5,
    led_d6,
    led_d7,
    led_d8,
    led_d10,
    led_d17,

    led_d15,
    led_d13,
    led_d4,
    led_d11,
    led_d12,
    led_d14,
    led_d19,
    led_d18,
} led_Dx_e;

void led_set_level(led_Dx_e Dx, uint8_t level);
void led_update_buf_task(void);
void led_init(void);

#endif /* LED_H_ */
