czc13611858691/hozonEp40/(commit log)

2021-12-15 E3代码初次完成
    [EP40_DDCU_LIN1_Matrix_V2.1_Release0910.xlsx, EP40_PDCU_LIN1_Matrix_V2.1_Release0910.xlsx, EP40_update_software.cfg]
2022-01-11 E3样件发布版本
    [EP40-DFGLS-LIN诊断调查表V1.1_2021.11.12.xlsx, EP40-DRGLS-LIN诊断调查表V1.1_2021.11.12.xlsx, EP40-PFGLS-LIN诊断调查表V1.1_2021.11.12.xlsx, EP40-PRGLS-LIN诊断调查表V1.1_2021.11.12.xlsx, EP40_E2_DFGLS_自测试报告_20211026.xlsx, EP40_update_software.cfg, xx项目_xx阶段_xxECU_AUTOSAR测试报告-xxxx.xx.xx日期.xlsx, xx项目_xx阶段_xxECU_CAN网络测试报告-xxxx.xx.xx日期(1).xls]
2022-01-13 上传前初始化仓库
    [EP40-DFGLS-LIN诊断调查表V1.1_2021.11.12.xlsx, EP40-DRGLS-LIN诊断调查表V1.1_2021.11.12.xlsx, EP40-PFGLS-LIN诊断调查表V1.1_2021.11.12.xlsx, EP40-PRGLS-LIN诊断调查表V1.1_2021.11.12.xlsx, EP40_DDCU_LIN1_Matrix_V2.1_Release0910.xlsx, EP40_E2_DFGLS_自测试报告_20211026.xlsx, EP40_PDCU_LIN1_Matrix_V2.1_Release0910.xlsx, EP40_update_software.cfg]
2022-01-13 更新readme.txt
2022-01-13 更新app软件版本号为03.00.01
2022-01-13 移动图片位置
2022-01-13 移动文件夹位置
    [EP40_update_software.cfg]
2022-01-19 增加客户反馈问题
    [EP40_DDCU_LIN1_Matrix_V2.1_Release0910.xlsx, EP40_PDCU_LIN1_Matrix_V2.1_Release0910.xlsx]
2022-01-19 修复lin诊断功能
2022-01-19 修改PRGLS错误位
2022-01-19 增加bootloader代码
    [EP40-DFGLS-LIN诊断调查表V1.1_2021.11.12.xlsx, EP40-DRGLS-LIN诊断调查表V1.1_2021.11.12.xlsx, EP40-PFGLS-LIN诊断调查表V1.1_2021.11.12.xlsx, EP40-PRGLS-LIN诊断调查表V1.1_2021.11.12.xlsx, EP40_DDCU_LIN1_Matrix_V2.1_Release0910.xlsx, EP40_E2_DFGLS_自测试报告_20211026.xlsx, EP40_PDCU_LIN1_Matrix_V2.1_Release0910.xlsx, EP40_update_software.cfg]
2022-01-19 添加bootloader工程
2022-01-19 右后错误位bug修复
2022-01-19 更新主驾和左后的response_err错误,同时目前软件版本号为03.00.02
2022-01-19 修复软件定时器的bug
2022-01-19 DID数据长度统统+1,并且软件版本号回退到03.00.01
    [EP40_update_software.cfg]
2022-01-20 正式发布版本，软件版本v03.00.01
    [EP40_update_software.cfg]
2022-01-26 右前样件修改会话模式0 1 2--> 1 2 3
2022-01-26 增加支持的服务SID，但是没有实际性动作，也就是不会反馈NRC
2022-01-26 F186返回当前会话状态值，而不是无论0x10会话请求的子功能是否支持都返回子功能的值
2022-01-26 软件版本更新到03.00.02
    [EP40-PFGLS-LIN诊断调查表V1.1_2021.11.12.xlsx, EP40_update_software.cfg]
2022-01-26 更新NRC错误码
2022-02-11 文档更新
    [EP40_update_software.cfg]
2022-02-14 2022-2-14 修改软件版本位03.00.02
    [EP40_update_software.cfg]
2022-02-14 UDS Bootloader上位机开发中，临时保存
    [EP40_E3_DFGLS_功能测试报告_2021228.xlsx, EP40_update_software.cfg, ep40_uds_bootloader.cfg]
2022-02-18 添加RTAS后扶手座椅代码
    [EP40_update_software.cfg, RTAS.cfg, ep40_uds_bootloader.cfg]
2022-02-18 编译器优化等级太高导致ECU无法进入睡眠模式
    [EP40_update_software.cfg]
2022-02-18 修改PFGLS文件夹结构
2022-02-18 PFGLS整理main文件
2022-02-21 座椅将睡眠功能函数的优化等级设置为O0
    [EP40-DFGLS-LIN诊断调查表V1.2_2022.02.17.xlsx, EP40-DFGLS-LIN诊断调查表V1.2_2022.02.19.xlsx, EP40-DRGLS-LIN诊断调查表V1.2_2022.02.17.xlsx, EP40-DRGLS-LIN诊断调查表V1.2_2022.02.19.xlsx, EP40-PFGLS-LIN诊断调查表V1.2_2022.02.17.xlsx, EP40-PFGLS-LIN诊断调查表V1.2_2022.02.19.xlsx, EP40-PRGLS-LIN诊断调查表V1.2_2022.02.17.xlsx, EP40-PRGLS-LIN诊断调查表V1.2_2022.02.19.xlsx]
2022-02-22 根据客户需求，修改LIN诊断功能
    [EP40_update_software.cfg]
2022-02-22 整理PFGLS代码结构
2022-02-22 开关按键只支持手动挡信号，滑动只支持自动挡信号
2022-02-22 删除一些不必要的注释
2022-02-22 当非默认会话超时5S后，安全等级会重新处于锁定状态
2022-02-22 ECU处于锁定状态发送的种子不能为0
    [ep40_uds_bootloader.cfg]
2022-02-22 增加LIN诊断通信使能和关闭功能
2022-02-22 28服务的通讯使能关闭功能只做响应不做实际功能
